MASH-Mushroom-Automation/MASH-IoT-Device/assets/figma/bg_main.png

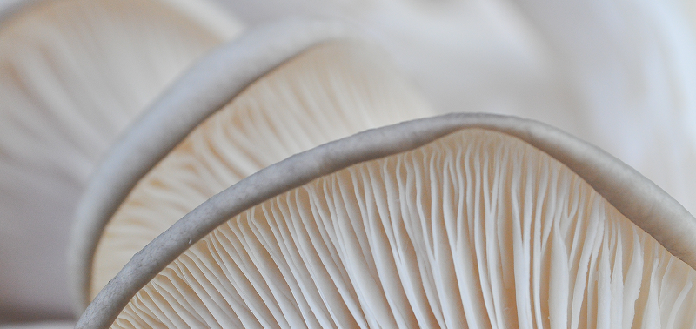
assets/figma/bg_main.png
