MASH-Mushroom-Automation/MASH-IoT-Device/assets/figma/bg_main_gradient.png

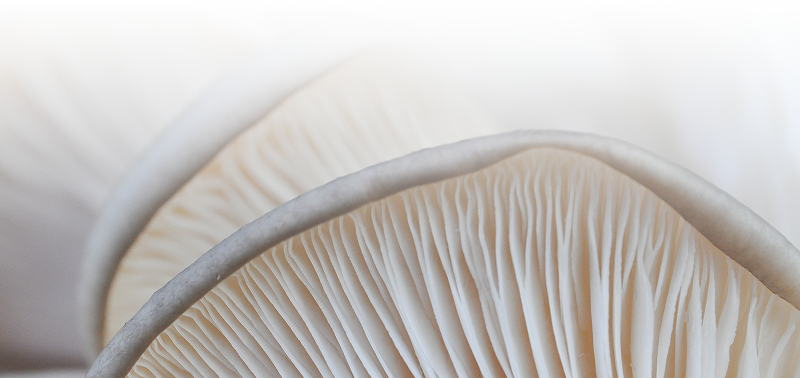
assets/figma/bg_main_gradient.png
