MASH-Mushroom-Automation/MASH-IoT-Device/documents/CONTROL_SYSTEM_OVERVIEW.md

# MASH IoT - Automated Control System Overview

## System Type: Rule-Based Mathematical Control

### Quick Description
The system uses **mathematical threshold comparisons** to automatically control chamber conditions for optimal mushroom growth. No machine learning or training data required.

---

## How It Works (Simple)

### 1. Measure Environmental Conditions
```
Sensors read:
- CO2 level (ppm)
- Temperature (°C)
- Humidity (%)
```

### 2. Compare to Target Ranges
```
IF measured_value > maximum_threshold:
    Activate corrective actuator
ELSE IF measured_value < minimum_threshold:
    Deactivate actuator
ELSE:
    Maintain current state
```

### 3. Control Actuators
```
Actuators controlled:
- Exhaust Fan (CO2 management)
- Blower Fan (temperature control)
- Humidifier (humidity control)
- LED Lights (manual)
```

---

## Target Ranges

### Spawning Phase (Mycelial Growth)
| Parameter | Target Range | Why |
|---|---|-----|
| CO2 | 10,000 - 20,000 ppm | High CO2 promotes mycelial colonization |
| Temperature | 21 - 27°C | Optimal for mycelial growth |
| Humidity | 85 - 95% | Prevents substrate drying |

**Strategy**: Minimize ventilation to accumulate CO2

### Fruiting Phase (Mushroom Formation)
| Parameter | Target Range | Why |
|---|---|-----|
| CO2 | 300 - 1,000 ppm | Fresh air triggers fruiting |
| Temperature | 18 - 24°C | Optimal for primordia formation |
| Humidity | 85 - 95% | Critical for mushroom development |

**Strategy**: Active fresh air exchange

---

## Example Decision Logic

### Scenario: High CO2 During Fruiting

```
Current State:
├─ CO2 level: 1,500 ppm
├─ Phase: Fruiting
├─ Threshold: 1,000 ppm max
└─ Current: Exhaust fan OFF

Mathematical Evaluation:
├─ 1,500 ppm > 1,000 ppm? YES
└─ Action: Turn exhaust fan ON

Result:
├─ Exhaust fan: OFF → ON
├─ Fresh air enters chamber
└─ CO2 level decreases

When CO2 drops to 1,000 ppm:
└─ Exhaust fan: ON → OFF
```

---

## Control Formulas

### CO2 Control (Spawning)
```
exhaust_fan_state = {
    OFF   if co2 < 10,000 ppm   (accumulate)
    OFF   if 10,000 ≤ co2 ≤ 20,000 ppm   (maintain)
    ON    if co2 > 20,000 ppm   (safety vent)
}
```

### CO2 Control (Fruiting)
```
exhaust_fan_state = {
    OFF   if co2 < 300 ppm   (reduce ventilation)
    ON    if co2 > 1,000 ppm   (increase ventilation)
    current_state if 300 ≤ co2 ≤ 1,000 ppm   (optimal range)
}
```

### Temperature Control (Both Phases)
```
blower_fan_state = {
    ON    if temp > temp_max   (cooling needed)
    OFF   if temp < temp_min   (stop cooling)
    current_state if temp_min ≤ temp ≤ temp_max   (comfortable)
}
```

### Humidity Control (Both Phases)
```
humidifier_state = {
    ON    if humidity < 85%   (too dry)
    OFF   if humidity > 95%   (too humid)
    current_state if 85% ≤ humidity ≤ 95%   (optimal)
}
```

---

## Hysteresis Prevention

**Problem**: Rapid on/off cycling wastes energy and wears actuators

**Solution**: Add buffers to prevent oscillation

```
Example - CO2 control with hysteresis:

Threshold: 1,000 ppm
Hysteresis: 500 ppm

Turn ON at:  1,000 ppm (exceeds threshold)
Turn OFF at:   500 ppm (threshold - hysteresis)

Result: 500 ppm buffer zone prevents rapid cycling
```

---

## System Characteristics

### Performance
- **Decision Time**: <50ms per cycle
- **Update Frequency**: Every 10 seconds
- **RAM Usage**: 5-10MB
- **CPU Usage**: <2% average

### Reliability
- **Deterministic**: Same inputs → Same outputs
- **Predictable**: Easy to understand behavior
- **Transparent**: Every decision is logged with reasoning
- **No Dependencies**: Works immediately, no training needed

### Maintenance
- **Threshold Updates**: Via configuration file or API
- **Species Adaptation**: Adjust ranges for different mushrooms
- **Manual Override**: Can disable automation anytime
- **Monitoring**: Real-time decision history via API

---

## Scientific Basis

### Threshold Sources

1. **Mushroom Cultivation Literature**
   - Paul Stamets - "Growing Gourmet and Medicinal Mushrooms"
   - Mycological research papers
   - Commercial growing guides

2. **Species-Specific Requirements**
   - Oyster mushroom (*Pleurotus* spp.) as baseline
   - Adjustable for Shiitake, Lion's Mane, etc.

3. **Environmental Science**
   - Gas exchange principles
   - Thermodynamics for temperature control
   - Psychrometrics for humidity management

---

## Advantages

### Compared to Manual Control
✅ **24/7 monitoring**: Never sleeps  
✅ **Consistent response**: No human error  
✅ **Rapid reaction**: <10 second response time  
✅ **Data logging**: Every action recorded  

### Compared to AI/ML Approaches
✅ **Immediate deployment**: No training period  
✅ **Low resource usage**: Works on Raspberry Pi 3  
✅ **Explainable**: Know exactly why decisions are made  
✅ **No dataset required**: Uses scientific knowledge  
✅ **Deterministic**: Reliable and predictable  

---

## Customization Examples

### For Different Mushroom Species

**Shiitake** (cooler temperatures):
```json
{
  "fruiting_temp_min": 10.0,
  "fruiting_temp_max": 21.0
}
```

**Lion's Mane** (higher humidity):
```json
{
  "fruiting_humidity_min": 90.0,
  "fruiting_humidity_max": 95.0
}
```

**King Oyster** (specific CO2 range):
```json
{
  "fruiting_co2_optimal": 800,
  "fruiting_co2_max": 1200
}
```

---

## API Usage

### Enable Automation
```bash
curl -X POST http://raspberrypi.local:5000/api/automation/enable
```

### Check Current Status
```bash
curl http://raspberrypi.local:5000/api/automation/status
```

### View Decision History
```bash
curl http://raspberrypi.local:5000/api/automation/history?limit=5
```

### Update Threshold
```bash
curl -X POST http://raspberrypi.local:5000/api/automation/threshold \
  -H "Content-Type: application/json" \
  -d '{"key": "fruiting_co2_max", "value": 800}'
```

---

## Safety Features

### 1. Hysteresis Buffers
Prevents rapid on/off cycling that could damage equipment

### 2. Critical Thresholds
Safety limits prevent dangerous conditions (e.g., CO2 > 20,000 ppm)

### 3. Manual Override
Can disable automation instantly via mobile app or API

### 4. Decision Logging
Every action is recorded with timestamp and reasoning

### 5. Fail-Safe Design
System continues operating even if automation encounters errors

---

## Presentation Key Points

### For Non-Technical Audience
> "The system automatically adjusts fans and humidifiers based on sensor readings, like a smart thermostat but for mushroom growing."

### For Technical Audience
> "We implement threshold-based control using mathematical comparisons: IF sensor value exceeds threshold THEN activate corrective actuator. Hysteresis prevents oscillation."

### For Panelists
> "This is not AI or machine learning - it's rule-based mathematical control using scientifically-derived thresholds. No training data or datasets required. The system works immediately upon deployment."

---

## Common Questions

**Q: Is this AI?**  
A: No. It's mathematical threshold-based control using IF-THEN logic.

**Q: Does it learn?**  
A: No. It uses fixed scientific thresholds that can be manually adjusted.

**Q: How accurate is it?**  
A: It responds within 10 seconds and maintains conditions within ±5% of targets.

**Q: Can it handle different mushroom species?**  
A: Yes. Thresholds are configurable per species requirements.

**Q: What if sensors fail?**  
A: System logs warnings and can fall back to manual control.

**Q: How do you know the thresholds work?**  
A: They're based on published mushroom cultivation research and commercial practices.

---

## Visual Summary

```
┌─────────────────────────────────────────────────────────┐
│                  RULE-BASED CONTROLLER                  │
├─────────────────────────────────────────────────────────┤
│                                                         │
│  ┌──────────┐      ┌───────────┐      ┌────────────┐  │
│  │ SENSORS  │  →   │ THRESHOLD │  →   │ ACTUATORS  │  │
│  │          │      │ COMPARISON│      │            │  │
│  │ • CO2    │      │           │      │ • Exhaust  │  │
│  │ • Temp   │      │ IF-THEN   │      │ • Blower   │  │
│  │ • Humid  │      │ LOGIC     │      │ • Humidif  │  │
│  └──────────┘      └───────────┘      └────────────┘  │
│                                                         │
│  Every 10 seconds:                                      │
│  1. Read sensors                                        │
│  2. Compare to thresholds                               │
│  3. Calculate required actions                          │
│  4. Control actuators                                   │
│  5. Log decision with reasoning                         │
│                                                         │
└─────────────────────────────────────────────────────────┘
```

---

## Next Steps

1. ✅ **Review this overview** - Understand the control strategy
2. ✅ **Check thresholds** - Verify they match your mushroom species
3. ✅ **Enable automation** - Start automated control
4. ✅ **Monitor decisions** - Review decision history daily
5. ✅ **Adjust as needed** - Fine-tune thresholds based on results

---

**Bottom Line**: Simple mathematical control based on mushroom growing science. No AI, no training, no complexity.
