MASH-Mushroom-Automation/MASH-IoT-Device/touchscreen_ui/ALIGNMENT_AND_ICONS_SUMMARY.md

# Alignment Fixes & Icon Integration Summary

## ✅ Completed Tasks

### 1. Alignment Fixes
- **Controls Screen**: Fixed actuator grid layout with proper spacing and row heights
- **WiFi Setup Screen**: Improved form layout for OSK compatibility (inputs in top 60%)
- **Controls Screen**: Added section titles and consistent spacing

### 2. Icon Integration System
Created comprehensive icon management system:
- **Icon Helper** (`utils/icon_helper.py`) - Centralized icon loading and management
- **Icon Guide** (`ICON_GUIDE.md`) - Complete documentation
- **Download Checklist** (`ICON_DOWNLOAD_CHECKLIST.md`) - Step-by-step download instructions
- **Usage Examples** (`ICON_USAGE_EXAMPLES.py`) - Code examples

### 3. Icon Assets
Created proper asset structure:
```
touchscreen_ui/assets/icons/
├── Navigation icons (home, sliders, bell, brain, help-circle, settings)
├── Actuator icons (droplet, wind, lightbulb, power)
├── Sensor icons (gauge, thermometer, droplet)
├── Status icons (check-circle, alert-triangle, x-circle, info)
└── System icons (wifi, activity, refresh-cw, chevron-right)
```

## 📋 Required Icons (27 total)

### Priority 1 - Essential (17 icons)
1. home.png - Dashboard navigation
2. sliders.png - Controls navigation
3. bell.png - Alerts navigation
4. brain.png - AI Insights navigation
5. help-circle.png - Help navigation
6. settings.png - Settings navigation
7. droplet.png - Humidifier & Humidity
8. wind.png - Fan controls
9. lightbulb.png - LED lights
10. power.png - Power toggle
11. gauge.png - CO2 sensor
12. thermometer.png - Temperature
13. check-circle.png - Success
14. alert-triangle.png - Warning
15. x-circle.png - Error
16. info.png - Information
17. wifi.png - WiFi connectivity

### Priority 2 - Additional (10 icons)
18. activity.png - System activity
19. refresh-cw.png - Refresh data
20. chevron-right.png - Navigation arrow
21. menu.png - Menu (optional)
22. play.png - Start automation
23. pause.png - Pause automation
24. skip-forward.png - Next
25. skip-back.png - Previous
26. download.png - Export data
27. upload.png - Import settings

## 🎨 Icon Specifications

**Download from**: https://lucide.dev

**Settings**:
- Format: PNG
- Size: 60x60 pixels (standard), 32x32 (small)
- Color: #FFFFFF (white) for dark theme
- Stroke width: 2px
- Background: Transparent

## 💻 Usage in Code

### Basic Usage
```python
from utils.icon_helper import get_icon

# Standard 60x60 icon
icon = get_icon('home')

# Different sizes
small = get_icon('bell', size='small')    # 32x32
medium = get_icon('wifi', size='medium')  # 48x48
large = get_icon('settings', size='large') # 60x60

# Custom size
custom = get_icon('power', size=40)
```

### Integration Examples

#### Navigation Sidebar
```python
# Replace emoji icons with Lucide icons
nav_items = [
    ('home', 'dashboard', 'Home'),
    ('bell', 'alerts', 'Alerts'),
    ('brain', 'ai_insights', 'AI'),
    ('sliders', 'controls', 'Controls'),
    ('help-circle', 'help', 'Help'),
    ('settings', 'settings', 'Settings')
]
```

#### Sensor Cards
```python
# Add sensor type icons
sensor_icons = {
    'co2': 'gauge',
    'temperature': 'thermometer',
    'humidity': 'droplet'
}
```

#### Actuator Controls
```python
# Add actuator icons
actuator_icons = {
    'humidifier': 'droplet',
    'fan_exhaust': 'wind',
    'fan_circulation': 'wind',
    'led_grow': 'lightbulb'
}
```

## 📂 File Structure
```
touchscreen_ui/
├── assets/
│   └── icons/              # Icon PNG files (YOU NEED TO ADD THESE)
│       ├── home.png
│       ├── sliders.png
│       ├── bell.png
│       └── ... (27 icons total)
├── utils/
│   └── icon_helper.py      # ✅ Icon loading utility (CREATED)
├── ICON_GUIDE.md           # ✅ Complete documentation (CREATED)
├── ICON_DOWNLOAD_CHECKLIST.md  # ✅ Download guide (CREATED)
└── ICON_USAGE_EXAMPLES.py  # ✅ Code examples (CREATED)
```

## 🚀 Next Steps

### 1. Download Icons (YOU NEED TO DO THIS)
Follow the checklist in `ICON_DOWNLOAD_CHECKLIST.md`:
1. Go to https://lucide.dev
2. Search for each icon
3. Download as PNG (60x60px, white, stroke 2px)
4. Save to `touchscreen_ui/assets/icons/`

### 2. Integrate Icons into Screens
Once icons are downloaded, update these files:
- `widgets/navigation_sidebar.py` - Replace emoji icons
- `widgets/sensor_card.py` - Add sensor type icons
- `widgets/toggle_button.py` - Add actuator icons
- `widgets/status_bar.py` - Add WiFi and status icons

### 3. Test Demo Mode
```powershell
cd touchscreen_ui
python main.py
```

## 🎯 Alignment Improvements

### Controls Screen
- ✅ Added section title "Actuator Controls"
- ✅ Fixed grid layout with proper row heights
- ✅ Improved spacing between elements
- ✅ Added consistent padding

### WiFi Setup Screen
- ✅ Form positioned in top 60% (OSK compatible)
- ✅ Added input padding for better touch targets
- ✅ Improved button layout and spacing
- ✅ Better status message alignment

### General Improvements
- ✅ Consistent spacing across all screens
- ✅ Proper touch target sizes (minimum 50dp)
- ✅ Better visual hierarchy with titles
- ✅ Improved readability

## ⚠️ Important Notes

1. **Icons are NOT included** - You must download them from lucide.dev
2. **Placeholder system** - Icon helper creates gray squares if icons are missing
3. **Testing** - Test with mock mode: `MOCK_MODE=true` in `.env`
4. **Performance** - Icons are optimized for RPi3 (60x60px)

## 📊 Implementation Status

- ✅ Icon helper system created
- ✅ Documentation complete
- ✅ Alignment fixes applied
- ✅ Mock mode working
- ⏳ Icons need to be downloaded (by you)
- ⏳ Screen integration (after icons are added)

---

**Ready for Testing**: Yes (with placeholder icons)  
**Ready for Production**: After downloading real icons
