MASH-Mushroom-Automation/MASH-IoT-Device/touchscreen_ui/ROADMAP.md

# Development Roadmap

## Phase 1: Foundation ✅ COMPLETED

- [x] Project structure
- [x] Configuration system
- [x] API client
- [x] Main application skeleton
- [x] Deployment guide

**Files Created**:
- `main.py` - Entry point with basic UI
- `config.py` - Configuration constants
- `api_client.py` - Flask API communication
- `requirements.txt` - Python dependencies
- `DEPLOYMENT_GUIDE.md` - Complete RPi3 setup instructions
- `README.md` - Project overview

## Phase 2: Core Screens (Next)

### 2.1 Dashboard Screen
- [ ] Live sensor data cards (CO2, temp, humidity)
- [ ] Real-time line charts
- [ ] Current mode indicator
- [ ] Alert notifications
- [ ] Auto-refresh every 2 seconds

**Estimated Time**: 8 hours

### 2.2 Controls Screen
- [ ] Actuator toggle buttons (4 relays)
- [ ] Visual on/off indicators
- [ ] Mode switcher (spawning/fruiting)
- [ ] Automation enable/disable toggle
- [ ] Confirmation dialogs

**Estimated Time**: 6 hours

### 2.3 WiFi Setup Screen
- [ ] Network scanner
- [ ] Network list with signal strength
- [ ] Password input dialog
- [ ] Connection status indicator
- [ ] Current network display

**Estimated Time**: 8 hours

### 2.4 Settings Screen
- [ ] Device info (ID, name, IP, MAC)
- [ ] System stats (CPU, RAM, temp, uptime)
- [ ] Backend connection status
- [ ] Version info
- [ ] Restart/shutdown buttons

**Estimated Time**: 4 hours

**Phase 2 Total**: 26 hours (~3-4 weeks part-time)

## Phase 3: Polish & Enhancement

- [ ] Custom widgets (sensor card, toggle button)
- [ ] Kivy layout files (.kv)
- [ ] Animations and transitions
- [ ] Error handling and retry logic
- [ ] Loading indicators
- [ ] Virtual keyboard for text input

**Estimated Time**: 12 hours

## Phase 4: Real-time Updates

- [ ] WebSocket client integration
- [ ] Live sensor data streaming
- [ ] Actuator state synchronization
- [ ] Connection status monitoring
- [ ] Automatic reconnection

**Estimated Time**: 8 hours

## Phase 5: Testing & Optimization

- [ ] Hardware testing on RPi3
- [ ] Performance profiling (RAM, CPU, FPS)
- [ ] Touch input calibration
- [ ] Battery/power management
- [ ] Long-term stability testing (24h+)
- [ ] Bug fixes

**Estimated Time**: 10 hours

## Phase 6: Documentation & Training

- [ ] User manual
- [ ] Video tutorial
- [ ] Troubleshooting guide
- [ ] Maintenance procedures

**Estimated Time**: 6 hours

---

## Total Estimated Time

- **Phase 1** (Foundation): ✅ 8 hours - DONE
- **Phase 2** (Core Screens): 26 hours
- **Phase 3** (Polish): 12 hours
- **Phase 4** (Real-time): 8 hours
- **Phase 5** (Testing): 10 hours
- **Phase 6** (Docs): 6 hours

**TOTAL**: ~70 hours (~2-3 months part-time, or 2-3 weeks full-time)

---

## Current Status

**Phase**: 1 (Foundation) ✅  
**Progress**: 8/70 hours (11%)  
**Next Task**: Implement Dashboard Screen

## How to Continue Development

```bash
# 1. Test current skeleton
cd touchscreen_ui
python3 main.py

# 2. Start Phase 2 - Dashboard Screen
# Create: screens/dashboard.py
# Create: kv/dashboard.kv
# Add to main.py screen manager

# 3. Test on development machine first
# Then deploy to RPi3 for hardware testing
```
