MASH-Mushroom-Automation/MASH-IoT-Device/documents/BLUETOOTH_INTEGRATION_SUMMARY.md

# Bluetooth Integration Summary - IoT Device

## Overview
Successfully integrated Bluetooth connectivity into the MASH IoT Device integrated server, enabling Bluetooth tethering for internet sharing and device discovery.

## Files Modified

### 1. `integrated_server.py`
**Changes Made:**
- Added Bluetooth manager and tethering imports
- Initialized Bluetooth components on startup
- Added 3 new API endpoints for Bluetooth control
- Updated health check to include Bluetooth status

## New Components Initialized

### Bluetooth Manager
```python
bluetooth_manager = BluetoothManager()
```
- Handles Bluetooth adapter control
- Manages discoverable mode
- Provides Bluetooth status

### Bluetooth Tethering
```python
bluetooth_tethering = BluetoothTethering()
```
- Manages internet sharing via Bluetooth PAN
- Handles NAT configuration
- Controls tethering lifecycle

## New API Endpoints

### 1. GET `/api/bluetooth/status`
**Description:** Get Bluetooth and tethering status

**Response:**
```json
{
  "success": true,
  "data": {
    "bluetooth": {
      "available": true,
      "powered": true,
      "discoverable": true,
      "pairable": true,
      "adapter": "hci0",
      "address": "XX:XX:XX:XX:XX:XX"
    },
    "tethering": {
      "active": false,
      "interface": "bnep0",
      "connected_devices": []
    }
  }
}
```

### 2. POST `/api/bluetooth/tethering`
**Description:** Start or stop Bluetooth tethering

**Request Body:**
```json
{
  "action": "start"  // or "stop"
}
```

**Response:**
```json
{
  "success": true,
  "data": {
    "action": "start",
    "message": "Bluetooth tethering started",
    "status": {
      "active": true,
      "interface": "bnep0",
      "connected_devices": []
    }
  }
}
```

### 3. POST `/api/bluetooth/discoverable`
**Description:** Set Bluetooth discoverable mode

**Request Body:**
```json
{
  "enabled": true,
  "timeout": 180  // seconds (optional, default: 180)
}
```

**Response:**
```json
{
  "success": true,
  "data": {
    "discoverable": true,
    "timeout": 180,
    "message": "Bluetooth discoverable enabled"
  }
}
```

## Startup Behavior

When the integrated server starts:

1. **Bluetooth Initialization**
   - Checks if Bluetooth is available
   - Logs availability status
   - Handles initialization errors gracefully

2. **Auto-Discoverable Mode**
   - Automatically sets device to discoverable
   - Default timeout: 300 seconds (5 minutes)
   - Allows mobile app to find the device easily

3. **Logging**
   ```
   INFO - Bluetooth is available
   INFO - Bluetooth set to discoverable mode (5 minutes)
   ```

## Updated Health Check

The `/api/health` endpoint now includes Bluetooth status:

```json
{
  "success": true,
  "data": {
    "status": "healthy",
    "serialConnected": true,
    "gpioAvailable": true,
    "automationEnabled": true,
    "bluetoothAvailable": true,  // NEW
    "timestamp": "2024-11-11T15:13:00.000Z"
  }
}
```

## Integration Flow

### Mobile App → IoT Device via Bluetooth

1. **Discovery Phase**
   ```
   Mobile App → Scans for Bluetooth devices
   IoT Device → Broadcasts as discoverable (MASH-IoT-XXXXX)
   Mobile App → Finds device in scan results
   ```

2. **Connection Phase**
   ```
   Mobile App → Connects to device via Bluetooth
   IoT Device → Accepts connection
   Mobile App → Sends HTTP requests over Bluetooth
   ```

3. **Tethering Phase (Optional)**
   ```
   Mobile App → POST /api/bluetooth/tethering {"action": "start"}
   IoT Device → Starts Bluetooth PAN
   IoT Device → Configures NAT for internet sharing
   IoT Device → Gets internet from mobile app
   ```

## Error Handling

All Bluetooth endpoints include comprehensive error handling:

```python
try:
    # Bluetooth operation
    status = bluetooth_manager.get_status()
    return jsonify({'success': True, 'data': status})
except Exception as e:
    logger.error(f"ERROR: Error getting Bluetooth status: {e}")
    return jsonify({'success': False, 'error': str(e)}), 500
```

## Dependencies

### Python Packages
- `subprocess` - For bluetoothctl commands
- `logging` - For error and status logging
- `flask` - For HTTP API endpoints

### System Requirements
- Bluetooth adapter (built-in on Raspberry Pi 3)
- `bluetoothctl` command-line tool
- `bluez` Bluetooth stack
- `iptables` for NAT configuration

## Testing Checklist

- [x] Bluetooth manager initialization
- [x] Bluetooth tethering initialization
- [x] API endpoint: GET /api/bluetooth/status
- [x] API endpoint: POST /api/bluetooth/tethering
- [x] API endpoint: POST /api/bluetooth/discoverable
- [x] Health check includes Bluetooth status
- [x] Auto-discoverable on startup
- [ ] Test on actual Raspberry Pi 3 hardware
- [ ] Test Bluetooth pairing with mobile app
- [ ] Test tethering internet sharing
- [ ] Test API calls over Bluetooth connection

## Usage Examples

### Check Bluetooth Status
```bash
curl http://localhost:5000/api/bluetooth/status
```

### Start Tethering
```bash
curl -X POST http://localhost:5000/api/bluetooth/tethering \
  -H "Content-Type: application/json" \
  -d '{"action": "start"}'
```

### Make Device Discoverable
```bash
curl -X POST http://localhost:5000/api/bluetooth/discoverable \
  -H "Content-Type: application/json" \
  -d '{"enabled": true, "timeout": 300}'
```

### Health Check
```bash
curl http://localhost:5000/api/health
```

## Security Considerations

1. **Pairing Required**: Device requires pairing before connection
2. **Timeout**: Discoverable mode auto-disables after timeout
3. **Local Only**: Bluetooth has limited range (~10 meters)
4. **No Authentication**: API endpoints don't require auth (local network only)

## Future Enhancements

1. Add Bluetooth device pairing management
2. Add connected devices list
3. Add Bluetooth signal strength monitoring
4. Add automatic tethering on mobile connection
5. Add Bluetooth connection history
6. Add device name customization

## Troubleshooting

### Bluetooth Not Available
```
WARNING: Bluetooth not available on this system
```
**Solution:** Ensure Bluetooth hardware is present and `bluez` is installed

### Tethering Fails
```
ERROR: Failed to start tethering
```
**Solution:** Check iptables permissions and network configuration

### Discoverable Mode Fails
```
ERROR: Failed to set discoverable mode
```
**Solution:** Ensure bluetoothctl is installed and Bluetooth is powered on

---

**Updated:** November 11, 2024
**Version:** 1.0.0
**Status:** Integrated and Ready for Testing
