MASH-Mushroom-Automation/MASH-IoT-Device/documents/Budget_Breakdown.md

# M.A.S.H. Project Budget Breakdown

## Hardware Components Budget

| Item | Cost | Shop Link |
|---|---|---|
| Raspberry Pi Zero 2W | ₱1,600.00 | [MakerLab Electronics](https://www.makerlab-electronics.com/products/raspberry-pi-zero-2w-sc1146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) |
| Micro USB Power Switch | ₱70.00 | [Shopee](https://shopee.ph/ITHT-USB-Type-C-With-ON-OFF-Switch-Power-Button-30CM-Charging-Extension-Cable-Universal-Type-C-Extension-Cable-new-i.168902097.43350919209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) |
| CO2L Unit with Temperature and Humidity Sensor | ₱3,090.00 | [MakerLab Electronics](https://www.makerlab-electronics.com/products/m5stack-co2l-unit-with-temperature-and-humidity-sensor-scd41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) |
| I2C 20x4 Arduino LCD Display Module | ₱280.00 | [MakerLab Electronics](https://www.makerlab-electronics.com/products/20x4-lcd-display-i2c-white-blue?_pos=2&_psq=20x4&_ss=e&_v=1.0) |
| Breadboard Jumper Wires | ₱50.00 | [MakerLab Electronics](https://www.makerlab-electronics.com/products/40-pin-10cm-jumper-wires?_pos=1&_psq=jum&_ss=e&_v=1.) |
| Mini Fan (exhaust) | ₱75.00 | [MakerLab Electronics](https://www.makerlab-electronics.com/products/raspberry-pi-fan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) |
| Humidifier | ₱135.00 | [Shopee](https://shopee.ph/DC5V-Unswitched-Four-Spray-Humidifier-Module-Atomization-Control-Board-i.1118156654.41163184713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) |
| HEPA Filter | ₱400.00 | [Shopee](https://shopee.ph/Sharp-FZ-F30HFE-Air-Purifier-Composite-Filter-For-FP-F30-FP-GM30E-KC-F30E-FP-J30E-FP-JM30-FP-GM30B-B-i.1242063782.41350010111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) |
| Blower Fan (12 inch) (Air intake) | ₱1,000.00 | [Shopee](https://shopee.ph/Exhaust-fan-Low-Noise-Kitchen-Exhaust-Fan-Wall-Mounted-Home-Exhaust-Fan-Multi-size-Ventilation-Fan-i.629450377.26465497321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) |
| Air Filtered Fan (4 inch) | ₱2,300.00 | [Shopee](https://shopee.ph/%E3%80%90Remote-Control%E3%80%91-Xiaomi-DIY-Air-Purifier-Set-Exhaust-Fan-Extractor-Fan-with-for-Version2-2S-2H-2C-3H-i.955280135.29637047541) |
| Grow Tent (24 x 24 x 36 inch) | ₱4,789.00 | [Shopee](https://shopee.ph/%E3%80%90Litgrow%E3%80%91Garden-80-x-80-x-160-CM(32-x32-x64-)-Hydroponic-Indoor-Bud-Green-Room-600D-Grow-Tent-i.980116806.16894088199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) |
| Fan Speed Control Board | ₱200.00 | [OSHPark](https://oshpark.com/shared_projects/oJIFTsvc) |
| Panel Mount Audio Jack | ₱90.00 | [Shopee](https://shopee.ph/1-3-5PCS-3.5MM-Audio-Jack-Socket-Stereo-3-Pole-Solder-Panel-Mount-With-Nut-Connector-Headphone-Female-Socket-PJ-392A-PJ392A-i.1263679380.2816672311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) |
| Power strip smart socket | ₱1,799.00 | [Shopee](https://shopee.ph/LASCO-Wifi-Universal-Smart-Power-Strip-with-Energy-Monitoring-Smart-Socket-with-Surge-Pro-i.151900297.23955304247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) |
| F5305S Power Mosfet Module | ₱150.00 | [MakerLab Electronics](https://www.makerlab-electronics.com/products/f5305s-power-mosfet-module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) |

## Total Hardware Cost: ₱16,028.00

## Budget Analysis

### Project Budget Allocation
- **Total Team Budget**: ₱20,000.00
- **Hardware Costs**: ₱16,028.00 (80.14% of budget)
- **Remaining Budget**: ₱3,972.00 (19.86% of budget)

### Remaining Budget Allocation
The remaining ₱3,972.00 will cover:
- Software development tools and subscriptions
- Testing and prototyping materials
- Documentation and printing costs
- Contingency funds for unexpected expenses
- Transportation for field visits and interviews

### Cost Justification
- **Component Selection**: All components chosen are off-the-shelf, readily available, and cost-effective for a prototype system
- **Scalability**: Components can be sourced in bulk for production scaling
- **Quality**: Industrial-grade components ensure reliability for agricultural use
- **Local Availability**: Most components available through Philippine suppliers (Shopee, local electronics shops)

### Return on Investment (ROI) Projection
Based on stakeholder interviews and market research:
- **Target Yield Increase**: 20% improvement in mushroom production
- **Cost Recovery Period**: 6-8 months for small-scale growers
- **Annual ROI**: 150-200% based on increased yields and direct-to-consumer sales
- **Break-even Analysis**: System pays for itself within one growing cycle

### Funding Sources
- **Primary**: Team budget allocation (₱20,000)
- **Secondary**: Potential sponsorships from Department of Agriculture or technology partners
- **Future**: Government grants for agricultural innovation (DA, DTI programs)

## Procurement Timeline
- **Week 1-2**: Core controller (Raspberry Pi) and basic sensors
- **Week 3-4**: Environmental control components (fans, humidifier, filters)
- **Week 5-6**: Structural components (grow tent, mounting hardware)
- **Week 7-8**: Power management and connectivity components

## Risk Mitigation
- **Price Fluctuations**: Budget includes 10% contingency for component price changes
- **Availability**: Multiple suppliers identified for critical components
- **Import Delays**: Local alternatives identified for imported components
- **Currency Exchange**: Budget fixed in Philippine Pesos to avoid exchange rate risks
