MASH-Mushroom-Automation/MASH-IoT-Device/documents/README.md

# MASH Project Documentation

This folder contains official documentation for the M.A.S.H. (Mushroom Automation with Smart Hydro-environment using IoT and AI for Sustainable Harvest) project.

## Documents Overview

- **[MASH_Project_Proposal.md](MASH_Project_Proposal.md)** - Complete project proposal including rationale, objectives, scope, and methodology
- **[Feasibility_Study.md](Feasibility_Study.md)** - Detailed feasibility analysis across operational, technical, and economic domains
- **[Budget_Breakdown.md](Budget_Breakdown.md)** - Complete hardware and component cost breakdown
- **[Technical_Specifications.md](Technical_Specifications.md)** - Hardware components, software stack, and system architecture details
- **[Tech_Stack.md](Tech_Stack.md)** - Detailed technology stack including frameworks, databases, and tools
- **[Stakeholder_Interviews.md](Stakeholder_Interviews.md)** - Interview summaries with growers, producers, and industry experts
- **[References.md](References.md)** - Complete bibliography and research sources

## Project Overview

M.A.S.H. is an IoT and AI-driven system for automated oyster mushroom cultivation, featuring:
- Smart environmental monitoring and control
- AI-powered optimization algorithms
- Mobile applications for growers and consumers
- Integrated e-commerce platform
- Real-time data synchronization

## Contact Information

**Project Team:**
- Kevin A. Llanes (Project Manager)
- Irheil Mae S. Antang (Software Engineer)
- Ma. Catherine H. Bae (Front-end Developer)
- Jin Harold A. Failana (Hardware Programmer)
- Jhon Keneth Ryan B. Namias (Back-end Developer)
- Emmanuel L. Pabua (Database Administrator)
- Ronan Renz T. Valencia (Full Stack Developer)

**Thesis Adviser:** Prof. Joemen G. Barrios, MIT

**Date:** September 29, 2025
