MASH-Mushroom-Automation/MASH-IoT-Device/documents/MIGRATION_TO_RULE_BASED.md

# Migration from AI to Rule-Based Controller

## Summary

Based on panelist feedback, the system has been updated to remove AI terminology and clearly show that it uses **mathematical threshold-based control**, not machine learning or AI.

## What Changed

### 1. New Rule-Based Controller
- **File**: `rule_based_controller.py`
- Replaces: `ai_automation.py`
- **Key Improvement**: Clear documentation that this uses mathematical equations, not AI

### 2. Updated Integration
- **File**: `integrated_server.py`
- Changed all references from `AIAutomationEngine` to `RuleBasedController`
- Updated variable names: `ai_engine` → `automation_controller`
- Updated log messages to remove "AI" terminology

### 3. New Documentation
- **File**: `RULE_BASED_AUTOMATION_GUIDE.md`
- Comprehensive guide explaining the mathematical approach
- Threshold tables and formulas clearly documented
- Examples showing exact decision logic
- Replaces: `AI_AUTOMATION_GUIDE.md` (which can be archived)

## What DIDN'T Change

### System Still Works the Same Way
The control logic is **identical** - it was always using mathematical thresholds, not AI:

```python
# This was ALWAYS the logic (just renamed now)
IF co2 > threshold_max THEN
    activate_exhaust_fan
ELSE IF co2 < threshold_min THEN
    deactivate_exhaust_fan
```

### No Breaking Changes
- **Backward compatible**: Old `AIAutomationEngine` still works (aliased)
- **Same API endpoints**: `/api/automation/*` endpoints unchanged
- **Same functionality**: All features work exactly as before
- **No dataset required**: Never needed datasets (that was the point!)

## Key Clarifications

### What This System Actually Does

**Rule-Based Mathematical Control**:
1. Read sensor values (CO2, temperature, humidity)
2. Compare values to scientific thresholds
3. Apply simple IF-THEN logic
4. Control actuators based on comparison results

**NOT AI/Machine Learning**:
- ❌ No neural networks
- ❌ No training datasets required
- ❌ No model training process
- ❌ No machine learning algorithms

### Why It Was Called "AI" Before

The original `ai_automation.py` had this confusing structure:
- Included a "training" function that just loaded JSON thresholds
- Used terminology like "model" for what was just configuration
- This made panelists think it needed dataset collection time

## Benefits of the Clarification

### For Presentation
✅ **Clearer explanation**: "Mathematical threshold-based control"  
✅ **No dataset concerns**: Works immediately with scientifically-derived values  
✅ **Transparent logic**: Every decision is explainable  
✅ **Simpler terminology**: Rule-based controller, not AI engine  

### For Implementation
✅ **Same lightweight performance**: 5-10MB RAM  
✅ **Same deterministic behavior**: Predictable outcomes  
✅ **Same ease of customization**: Adjust thresholds via config  
✅ **Backward compatible**: No code changes needed elsewhere  

## Control Logic Documentation

### Spawning Phase
```
CO2 Management:
  IF co2 < 10,000 ppm:
    exhaust_fan = OFF (accumulate CO2)
  ELSE IF co2 > 20,000 ppm:
    exhaust_fan = ON (safety ventilation)
  
Temperature Control:
  IF temperature > 27°C:
    blower_fan = ON (cooling)
  ELSE IF temperature < 21°C:
    blower_fan = OFF (stop cooling)
  
Humidity Control:
  IF humidity < 85%:
    humidifier = ON
  ELSE IF humidity > 95%:
    humidifier = OFF
```

### Fruiting Phase
```
CO2 Management:
  IF co2 > 1,000 ppm:
    exhaust_fan = ON (fresh air exchange)
  ELSE IF co2 < 300 ppm:
    exhaust_fan = OFF (reduce ventilation)
  
Temperature Control:
  IF temperature > 24°C:
    blower_fan = ON (cooling)
  ELSE IF temperature < 18°C:
    blower_fan = OFF (stop cooling)
  
Humidity Control:
  IF humidity < 85%:
    humidifier = ON
  ELSE IF humidity > 95%:
    humidifier = OFF
```

## Threshold Sources

All thresholds are derived from **mushroom cultivation science**:

1. **Literature Review**:
   - Paul Stamets - "Growing Gourmet and Medicinal Mushrooms"
   - Research papers on Oyster mushroom cultivation
   - Commercial mushroom growing guidelines

2. **Known Best Practices**:
   - Spawning requires high CO2 (10,000-20,000 ppm) for mycelial growth
   - Fruiting requires fresh air exchange (300-1,000 ppm CO2)
   - Humidity must remain high (85-95%) throughout
   - Temperature ranges vary by growth phase

3. **Safety Margins**:
   - Hysteresis buffers prevent oscillation
   - Critical thresholds protect against extremes
   - Conservative ranges ensure mushroom health

## Migration Steps (If Needed)

### If You Have Custom Code

**Old import**:
```python
from ai_automation import AIAutomationEngine
controller = AIAutomationEngine()
```

**New recommended import**:
```python
from rule_based_controller import RuleBasedController
controller = RuleBasedController()
```

**Backward compatible** (old code still works):
```python
from rule_based_controller import AIAutomationEngine  # Alias provided
controller = AIAutomationEngine()  # Still works!
```

### Configuration Files

**Old**: `models/decision_model.json`  
**New**: `config/thresholds.json` (optional)

Same format works for both:
```json
{
  "version": "1.0",
  "thresholds": {
    "spawning_co2_min": 10000,
    "fruiting_co2_max": 1000
  }
}
```

## Presentation Talking Points

When presenting to panelists:

### Before (Confusing):
> "We use an AI automation engine with a trained decision model that learns from historical data..."

**Panelist concern**: "How long did you collect training data? How much storage for datasets?"

### After (Clear):
> "We use rule-based mathematical control with scientifically-derived thresholds. For example, if CO2 exceeds 1000 ppm during fruiting phase, the exhaust fan activates for fresh air exchange."

**Panelist response**: "That makes sense and is immediately deployable."

## Files Reference

### New/Updated Files
- ✅ `rule_based_controller.py` - Main controller (new)
- ✅ `RULE_BASED_AUTOMATION_GUIDE.md` - Documentation (new)
- ✅ `MIGRATION_TO_RULE_BASED.md` - This file (new)
- ✅ `integrated_server.py` - Updated integration

### Old Files (Can Be Kept for Reference)
- 📁 `ai_automation.py` - Original (now superseded)
- 📁 `AI_AUTOMATION_GUIDE.md` - Original documentation
- 📁 `raspberry-pi/train_decision_model.py` - Not needed

### Files to Remove (Optional Cleanup)
- ❌ `raspberry-pi/train_decision_model.py` - Training script not needed
- ❌ `data/training_data.csv` - No training data needed
- ❌ `models/` directory - Can use `config/` instead

## Testing Checklist

After migration, verify:

- [ ] System starts successfully
- [ ] Automation can be enabled/disabled via API
- [ ] Sensor readings are processed
- [ ] Actuator control works
- [ ] Decision history is logged
- [ ] API endpoints respond correctly
- [ ] No errors in logs

## Questions & Answers

**Q: Do I need to retrain anything?**  
A: No. There is no training. The system uses fixed mathematical thresholds.

**Q: Will performance change?**  
A: No. It's the exact same logic, just renamed for clarity.

**Q: Can I still customize thresholds?**  
A: Yes. Edit `config/thresholds.json` or use the API.

**Q: Is the old code still there?**  
A: Yes. `ai_automation.py` is kept for reference and backward compatibility.

**Q: Do mobile apps need updates?**  
A: No. API endpoints are unchanged.

**Q: What about the "AI" toggle in the mobile app?**  
A: It can be renamed to "Auto-Control" or "Automation" in the UI, but the API works the same.

---

## Conclusion

This migration **clarifies the terminology** without changing functionality. The system was always using mathematical threshold-based control - now it's just more honest about it!

**For panelists**: No lengthy data collection required. The system uses proven scientific thresholds and is ready to deploy immediately.

**For you**: Same great control system, clearer documentation, easier to explain.
