MASH-Mushroom-Automation/MASH-IoT-Device/documents/Backend_Development_Plan.md

# M.A.S.H. Backend Development Plan
## 20-Day Sprint: Enterprise-Grade NestJS Backend with Clerk Authentication

### Project Information
- **Sprint Duration**: October 1 - October 20, 2025 (20 working days)
- **Lead Developer**: Jhon Keneth Ryan B. Namias (Backend Developer)
- **Project Manager**: Kevin A. Llanes
- **GitHub Organization**: https://github.com/orgs/MASH-Mushroom-Automation
- **GitHub Project Board**: https://github.com/orgs/MASH-Mushroom-Automation/projects/1
- **Repository**: MASH-Backend-API
- **Focus**: Production-ready backend API with enterprise-grade standards

---

## 1. Executive Summary and Project Standards

### 1.1 Software Development Standards

#### Development Methodology
- **Agile Development**: Daily sprints with continuous integration
- **Test-Driven Development**: Write tests before implementation
- **Code Review Process**: Mandatory peer reviews for all pull requests
- **Documentation-First**: API documentation before implementation
- **Security-First**: Security considerations in every feature

#### Code Quality Standards
- **TypeScript Strict Mode**: Enforced type safety throughout
- **ESLint and Prettier**: Automated code formatting and linting
- **SonarQube**: Code quality analysis and technical debt management
- **Unit Test Coverage**: Minimum 85% coverage requirement
- **Integration Test Coverage**: 70% of critical user journeys

#### Architecture Principles
- **Clean Architecture**: Domain-driven design with clear separation of concerns
- **SOLID Principles**: Single responsibility, open/closed, dependency inversion
- **Microservices-Ready**: Modular design for future scaling
- **API-First Design**: RESTful APIs with OpenAPI 3.0 specification
- **Real-time Capabilities**: WebSocket integration for live updates

### 1.2 Primary Objectives

#### Core Deliverables
- **Authentication System**: Complete Clerk integration with session management
- **Database Layer**: PostgreSQL with Prisma ORM and optimized queries
- **IoT Integration**: MQTT broker for real-time device communication
- **E-commerce Engine**: Complete order management and payment processing
- **Real-time Features**: WebSocket implementation for live data streaming
- **API Documentation**: Comprehensive Swagger/OpenAPI documentation
- **Production Deployment**: Docker containerization with CI/CD pipeline

#### Success Metrics
- **Performance**: API response times under 150ms for 95% of requests
- **Reliability**: 99.9% uptime with proper error handling
- **Security**: Zero critical vulnerabilities, proper authentication flows
- **Scalability**: Support for 1000+ concurrent connections
- **Maintainability**: Clean code with comprehensive documentation

### 1.3 Technology Stack and Architecture

#### Backend Framework
- **NestJS v10.x** (TypeScript)
  - Modular, scalable Node.js framework for enterprise applications
  - Integrated with Prisma ORM for type-safe database operations
  - Built-in support for guards, interceptors, and pipes
  - Comprehensive testing utilities and decorators

#### Authentication and Authorization
- **Clerk Authentication** (Production-Ready)
  - Handles complete authentication and session management
  - Pre-built UI components and secure JWT token handling
  - Multi-factor authentication and social login support
  - Role-based access control (RBAC) integration

#### Database and ORM
- **PostgreSQL 15+** with **Prisma ORM 5.x**
  - Type-safe database queries with auto-generated client
  - Database migrations and schema management
  - Connection pooling and performance optimization
  - Support for complex relationships and transactions

#### Real-time and IoT Communication
- **MQTT Protocol** for IoT device communication
- **WebSocket** implementation for real-time web updates
- **Redis** for session storage and caching
- **Socket.io** for enhanced WebSocket functionality

#### Data Flow Architecture
```
IoT Sensors → Raspberry Pi Controller → MQTT Broker → NestJS Backend API
                                                            ↓
PostgreSQL Database ← Redis Cache ← WebSocket Gateway ← Mobile Apps
                                                            ↓
                                                    Web Dashboard
                                                            ↓
                        Clerk Authentication ← External APIs
                                                            ↓
                      Payment Gateways ← File Storage/CDN
                                                            ↓
                                          Email/SMS Services
```

---

## 2. Detailed 20-Day Development Phases

### Phase 1: Foundation & Architecture (Days 1-5)
**October 1-5, 2025 | Foundation Week**

#### Development Standards for Phase 1
- **Architecture Documentation**: Complete system design before coding
- **Code Structure**: Clean folder organization following NestJS best practices
- **Environment Setup**: Reproducible development environment with Docker
- **CI/CD Pipeline**: Automated testing and deployment from day one
- **Security Foundation**: Security configurations from project inception

#### Day 1 (Oct 1): Project Architecture & Initial Setup
**Daily Goal**: Complete project foundation and architecture documentation

**Morning Session (4 hours)**:
- [ ] **Project Architecture Design**
  - Create detailed system architecture diagram
  - Define module structure and dependencies
  - Document data flow and integration points
  - Plan API endpoint structure and naming conventions

**Afternoon Session (4 hours)**:
- [ ] **NestJS Project Initialization**
  - Create NestJS project with strict TypeScript configuration
  - Set up modular folder structure (modules, controllers, services, DTOs)
  - Configure ESLint, Prettier, and Husky git hooks
  - Initialize package.json with all required dependencies

**GitHub Issues & Project Board Setup**:
- `#001`: Create system architecture documentation
- `#002`: Initialize NestJS project with TypeScript strict mode
- `#003`: Configure code quality tools (ESLint, Prettier, Husky)
- `#004`: Set up GitHub repository and branch protection rules

#### Day 2 (Oct 2): Database Architecture & Prisma ORM Setup
**Daily Goal**: Complete database foundation with optimized schema design

**Morning Session (4 hours)**:
- [ ] **Database Design & Optimization**
  - Design comprehensive database schema with proper relationships
  - Create Entity-Relationship Diagrams (ERD)
  - Plan indexing strategy for performance optimization
  - Design data retention and archiving policies

**Afternoon Session (4 hours)**:
- [ ] **Prisma ORM Implementation**
  - Set up PostgreSQL database (local development + cloud staging)
  - Initialize Prisma with complete schema definition
  - Create optimized database migrations with proper constraints
  - Implement database seeding with realistic test data
  - Set up database connection pooling and performance monitoring

**Quality Assurance**:
- Database migration testing (up/down migrations)
- Query performance testing with EXPLAIN ANALYZE
- Data integrity constraints validation
- Backup and recovery procedure testing

**GitHub Issues**:
- `#005`: Design complete database schema with ERD documentation
- `#006`: Set up PostgreSQL with connection pooling and monitoring
- `#007`: Implement Prisma ORM with optimized schema and migrations
- `#008`: Create comprehensive database seeding and test data

#### Day 3 (Oct 3): Clerk Authentication & Security Implementation
**Daily Goal**: Complete enterprise-grade authentication system with Clerk integration

**Morning Session (4 hours)**:
- [ ] **Clerk SDK Integration & Configuration**
  - Install and configure Clerk SDK for NestJS
  - Set up Clerk webhook handlers for user management
  - Configure environment variables and security keys
  - Implement Clerk middleware for request authentication

**Afternoon Session (4 hours)**:
- [ ] **Authentication Guards & Authorization**
  - Create custom authentication guards using Clerk tokens
  - Implement role-based access control (RBAC) system
  - Create custom decorators for permissions and roles
  - Set up JWT token validation and refresh mechanisms
  - Implement session management with proper security headers

**Security Implementation**:
- CORS configuration for production security
- Rate limiting and request throttling
- Input validation and sanitization
- Security headers (HELMET, CSP, HSTS)

**Testing Requirements**:
- Unit tests for authentication guards and decorators
- Integration tests for Clerk webhook handling
- Security testing for authentication flows
- Performance testing for token validation

**GitHub Issues**:
- `#009`: Integrate Clerk SDK with complete configuration
- `#010`: Implement authentication middleware and guards
- `#011`: Create RBAC system with custom decorators
- `#012`: Set up JWT validation and session management

#### Day 4 (Oct 4): Core API Foundation & Enterprise Patterns
**Daily Goal**: Implement robust API foundation with enterprise-grade patterns

**Morning Session (4 hours)**:
- [ ] **Core Module Architecture**
  - Create base modules following clean architecture principles
  - Implement health check module with comprehensive monitoring
  - Set up user management module with Clerk integration
  - Create common utilities and shared modules

**Afternoon Session (4 hours)**:
- [ ] **Enterprise-Grade Error Handling & Validation**
  - Implement global exception filters with proper error logging
  - Create custom exception classes for business logic errors
  - Set up request/response interceptors for logging and transformation
  - Configure validation pipes with custom validation decorators
  - Implement API versioning and backward compatibility

**Code Quality Standards**:
- Abstract base classes for consistent service and controller patterns
- Custom decorators for common functionality
- Comprehensive logging with structured format
- Performance monitoring and metrics collection

**GitHub Issues**:
- `#013`: Create core module architecture with clean patterns
- `#014`: Implement comprehensive error handling and logging
- `#015`: Set up validation pipes and custom decorators
- `#016`: Create base classes and shared utilities

#### Day 5 (Oct 5): User Management & Profile System
**Daily Goal**: Complete comprehensive user management with advanced features

**Morning Session (4 hours)**:
- [ ] **Advanced User Management**
  - Implement complete user CRUD operations with Clerk synchronization
  - Create user profile management with image upload capabilities
  - Set up user preferences and settings system
  - Implement user search and filtering with pagination

**Afternoon Session (4 hours)**:
- [ ] **RBAC & Activity Tracking**
  - Implement advanced role-based access control with hierarchical roles
  - Create permission system with granular access controls
  - Set up comprehensive user activity logging and audit trails
  - Implement user session management and concurrent login handling
  - Create user analytics and behavior tracking

**Advanced Features**:
- User onboarding workflow automation
- Profile verification system
- User notification preferences
- Advanced search with Elasticsearch integration (if needed)

**Testing & Documentation**:
- Complete unit test coverage for user management
- Integration tests for Clerk synchronization
- API documentation with examples
- Performance testing for user operations

**GitHub Issues**:
- `#017`: Implement advanced user CRUD with Clerk synchronization
- `#018`: Create comprehensive RBAC with hierarchical permissions  
- `#019`: Set up user activity logging and audit trails
- `#020`: Implement user preferences and profile management

### Phase 2: IoT Core & Device Management (Days 6-10)
**October 6-10, 2025 | IoT Integration Week**

#### Development Standards for Phase 2
- **IoT Security**: Device authentication and secure communication protocols
- **Real-time Processing**: Efficient handling of high-frequency sensor data
- **Scalability**: Support for multiple devices with concurrent connections
- **Data Integrity**: Reliable data collection with validation and error recovery
- **Performance**: Optimized MQTT message processing and database operations

#### Day 6 (Oct 6): Enterprise IoT Device Management System
**Daily Goal**: Complete IoT device lifecycle management with security and monitoring

**Morning Session (4 hours)**:
- [ ] **Advanced Device Registration & Authentication**
  - Implement secure device registration with certificate-based authentication
  - Create device provisioning workflow with QR code generation
  - Set up device ownership transfer and sharing mechanisms
  - Implement device grouping and organizational hierarchy

**Afternoon Session (4 hours)**:
- [ ] **Device Monitoring & Configuration Management**
  - Create real-time device status tracking with heartbeat monitoring
  - Implement remote device configuration management
  - Set up device firmware update management
  - Create comprehensive device activity logging and analytics
  - Implement device health monitoring with predictive maintenance alerts

**Enterprise Features**:
- Device fleet management for multiple users
- Geolocation tracking and mapping integration
- Device performance analytics and reporting
- Automated device onboarding and provisioning

**Security & Performance**:
- Device certificate management and rotation
- Encrypted device communication protocols
- Rate limiting for device API calls
- Database optimization for device data queries

**GitHub Issues**:
- `#021`: Implement secure device registration and authentication
- `#022`: Create device status monitoring and health tracking
- `#023`: Set up device configuration and firmware management
- `#024`: Implement device fleet management and analytics

#### Day 7 (Oct 7): MQTT Integration
**Goals**: Set up IoT communication layer
- [ ] Configure MQTT broker connection
- [ ] Implement MQTT message handling
- [ ] Create device command dispatch system
- [ ] Set up topic management and routing
- [ ] Add MQTT connection monitoring

**GitHub Issues**:
- `#19`: Configure MQTT broker and connection
- `#20`: Implement MQTT message handling and routing
- `#21`: Create device command dispatch system

#### Day 8 (Oct 8): Sensor Data Management
**Goals**: Handle sensor data collection and storage
- [ ] Create sensor data ingestion endpoints
- [ ] Implement real-time data streaming
- [ ] Set up data aggregation and analytics
- [ ] Create data retention policies
- [ ] Add data validation and filtering

**GitHub Issues**:
- `#22`: Implement sensor data ingestion system
- `#23`: Create real-time data streaming with WebSocket
- `#24`: Add data aggregation and analytics

#### Day 9 (Oct 9): Alert and Notification System
**Goals**: Implement alerting and notification features
- [ ] Create alert configuration system
- [ ] Implement threshold-based alerts
- [ ] Set up notification delivery (email, push)
- [ ] Create alert history and management
- [ ] Add alert acknowledgment system

**GitHub Issues**:
- `#25`: Implement alert configuration and threshold system
- `#26`: Create notification delivery system
- `#27`: Add alert history and management

#### Day 10 (Oct 10): E-commerce Foundation
**Goals**: Basic e-commerce functionality
- [ ] Create product management system
- [ ] Implement inventory tracking
- [ ] Set up order management
- [ ] Create seller management system
- [ ] Add basic payment processing structure

**GitHub Issues**:
- `#28`: Implement product and inventory management
- `#29`: Create order management system
- `#30`: Set up seller management and verification

### Week 3: Advanced Features & Integration (Days 11-15)
**October 11-15, 2025**

#### Day 11 (Oct 11): WebSocket Real-time Features
**Goals**: Implement real-time communication
- [ ] Set up WebSocket gateway
- [ ] Create real-time sensor data streaming
- [ ] Implement live device status updates
- [ ] Add real-time notifications
- [ ] Create WebSocket authentication

**GitHub Issues**:
- `#31`: Implement WebSocket gateway and authentication
- `#32`: Create real-time data streaming
- `#33`: Add live notifications and updates

#### Day 12 (Oct 12): Admin Dashboard APIs
**Goals**: Administrative functionality
- [ ] Create admin user management APIs
- [ ] Implement system monitoring endpoints
- [ ] Set up platform analytics
- [ ] Create content management system APIs
- [ ] Add system configuration management

**GitHub Issues**:
- `#34`: Implement admin user management APIs
- `#35`: Create system monitoring and analytics
- `#36`: Add CMS and configuration management

#### Day 13 (Oct 13): Payment Integration
**Goals**: Payment processing system
- [ ] Integrate payment gateways (Stripe, PayPal)
- [ ] Create payment processing workflows
- [ ] Implement transaction management
- [ ] Set up webhook handling
- [ ] Add payment security measures

**GitHub Issues**:
- `#37`: Integrate payment gateways
- `#38`: Implement payment processing workflows
- `#39`: Add transaction management and security

#### Day 14 (Oct 14): File Upload & Media Management
**Goals**: File handling system
- [ ] Set up file upload endpoints
- [ ] Implement image processing and optimization
- [ ] Create media storage management
- [ ] Add file security and validation
- [ ] Set up CDN integration

**GitHub Issues**:
- `#40`: Implement file upload and processing
- `#41`: Create media storage and CDN integration
- `#42`: Add file security and validation

#### Day 15 (Oct 15): API Documentation & Testing
**Goals**: Documentation and testing
- [ ] Generate Swagger/OpenAPI documentation
- [ ] Create API testing suite
- [ ] Implement integration tests
- [ ] Add performance testing
- [ ] Create API usage examples

**GitHub Issues**:
- `#43`: Generate comprehensive API documentation
- `#44`: Implement testing suite and integration tests
- `#45`: Add performance testing and optimization

### Week 4: Testing, Optimization & Deployment (Days 16-20)
**October 16-20, 2025**

#### Day 16 (Oct 16): Security & Validation
**Goals**: Security hardening
- [ ] Implement input validation and sanitization
- [ ] Add rate limiting and throttling
- [ ] Set up security headers and CORS
- [ ] Implement audit logging
- [ ] Conduct security testing

**GitHub Issues**:
- `#46`: Implement comprehensive input validation
- `#47`: Add rate limiting and security measures
- `#48`: Create audit logging system

#### Day 17 (Oct 17): Performance Optimization
**Goals**: Performance tuning
- [ ] Database query optimization
- [ ] Implement caching strategies (Redis)
- [ ] Add response compression
- [ ] Optimize MQTT performance
- [ ] Conduct load testing

**GitHub Issues**:
- `#49`: Optimize database queries and performance
- `#50`: Implement caching with Redis
- `#51`: Conduct load testing and optimization

#### Day 18 (Oct 18): Error Handling & Monitoring
**Goals**: Production readiness
- [ ] Implement comprehensive error handling
- [ ] Set up application monitoring
- [ ] Add health check endpoints
- [ ] Create logging and debugging tools
- [ ] Implement graceful shutdown

**GitHub Issues**:
- `#52`: Implement error handling and monitoring
- `#53`: Add health checks and logging
- `#54`: Create debugging and monitoring tools

#### Day 19 (Oct 19): Deployment Setup
**Goals**: Production deployment
- [ ] Create Docker containerization
- [ ] Set up production environment configuration
- [ ] Configure CI/CD deployment pipeline
- [ ] Set up database migrations for production
- [ ] Create deployment documentation

**GitHub Issues**:
- `#55`: Create Docker containerization
- `#56`: Set up production deployment pipeline
- `#57`: Configure production environment

#### Day 20 (Oct 20): Final Testing & Launch
**Goals**: Launch preparation
- [ ] Conduct final integration testing
- [ ] Perform security audit
- [ ] Complete documentation review
- [ ] Deploy to production environment
- [ ] Create handover documentation

**GitHub Issues**:
- `#58`: Final integration testing and security audit
- `#59`: Deploy to production environment
- `#60`: Complete documentation and handover

---

## 3. Comprehensive GitHub Project Management Structure

### 3.1 GitHub Project Board Configuration

#### Project Board URL
**Main Project Board**: https://github.com/orgs/MASH-Mushroom-Automation/projects/1

#### Board Structure and Workflow

##### Backlog (Product Backlog)
- **Purpose**: All issues planned but not yet started
- **Criteria**: Requirements defined, acceptance criteria documented
- **Management**: Weekly backlog grooming sessions
- **Contents**:
  - Feature specifications with detailed requirements
  - Future enhancements and improvements
  - Research tasks and spike investigations
  - Non-urgent bug fixes and technical debt

##### In Progress (Sprint Active)
- **Purpose**: Currently active development work
- **Limit**: Maximum 4 issues per developer to maintain focus
- **Management**: Daily standup review items
- **Criteria**: Developer assigned, work started, regular updates
- **Contents**:
  - Feature development in progress
  - Active bug fixes
  - Code reviews in progress
  - Documentation updates being written

##### In Review (Quality Gate)
- **Purpose**: Completed work awaiting quality assurance
- **Criteria**: Code complete, tests passing, ready for review
- **Management**: Peer reviews within 24 hours
- **Contents**:
  - Pull requests awaiting code review
  - Documentation pending technical review
  - Features ready for QA testing
  - Security reviews in progress

##### Done (Completed Sprint Items)
- **Purpose**: Completed and approved work items
- **Criteria**: Code merged, tests passing, documentation complete
- **Management**: Sprint retrospective analysis
- **Contents**:
  - Successfully merged features
  - Completed and deployed enhancements
  - Resolved and closed issues
  - Approved documentation updates

##### Blocked (Impediments)
- **Purpose**: Work items with external dependencies or blockers
- **Management**: Daily review for blocker resolution
- **Escalation**: Project manager notification for blockers over 24 hours
- **Contents**:
  - Issues waiting for external API responses
  - Items requiring stakeholder decisions
  - Technical blockers requiring architecture decisions
  - Dependency issues with third-party services

### 3.2 Advanced Labeling System

#### Priority Labels (Business Impact)
- `priority: P0 - Critical` - System down, security vulnerability, data loss
- `priority: P1 - High` - Core feature broken, significant user impact
- `priority: P2 - Medium` - Important feature, moderate user impact
- `priority: P3 - Low` - Nice to have, minimal user impact
- `priority: P4 - Backlog` - Future consideration, no immediate impact

#### Type Labels (Work Category)
- `type: feature` - New functionality development
- `type: bug` - Bug fixes and error corrections
- `type: docs` - Documentation updates and improvements
- `type: refactor` - Code improvements without functional changes
- `type: test` - Testing related work and test improvements
- `type: security` - Security enhancements and vulnerability fixes
- `type: performance` - Performance optimization and improvements
- `type: infrastructure` - DevOps, deployment, and infrastructure work

#### Component Labels (System Areas)
- `component: auth` - Authentication and authorization (Clerk integration)
- `component: database` - Database operations and Prisma ORM
- `component: mqtt` - IoT communication and MQTT broker
- `component: api` - REST API endpoints and controllers
- `component: websocket` - Real-time features and WebSocket connections
- `component: payment` - Payment processing and e-commerce
- `component: notification` - Alert system and notifications
- `component: file-upload` - File handling and media management
- `component: analytics` - Data analytics and reporting

#### Status Labels (Development Stage)
- `status: ready` - Ready to start development
- `status: in-progress` - Currently being worked on
- `status: blocked` - Cannot proceed due to dependencies
- `status: needs-review` - Awaiting code or design review
- `status: needs-testing` - Requires testing and QA validation
- `status: needs-deployment` - Ready for deployment to staging/production

#### Size Labels (Estimation)
- `size: XS` - 1-2 hours (simple configuration, minor fixes)
- `size: S` - 2-4 hours (small features, straightforward implementations)
- `size: M` - 4-8 hours (medium features, moderate complexity)
- `size: L` - 1-2 days (large features, complex implementations)
- `size: XL` - 2+ days (epic-level work, requires breakdown)

### 3.3 Issue Templates & Standards

#### Feature Request Template
```markdown
## Feature Description
Brief description of the feature

## Acceptance Criteria
- [ ] Criterion 1
- [ ] Criterion 2
- [ ] Criterion 3

## Technical Requirements
- Database changes required: Yes/No
- API endpoints affected: List endpoints
- Authentication required: Yes/No
- Real-time features: Yes/No

## Definition of Done
- [ ] Code implemented and tested
- [ ] Unit tests written (>85% coverage)
- [ ] Integration tests added
- [ ] API documentation updated
- [ ] Code reviewed and approved
- [ ] Deployed to staging environment
```

#### Bug Report Template
```markdown
## Bug Description
Clear description of the issue

## Steps to Reproduce
1. Step 1
2. Step 2
3. Step 3

## Expected Behavior
What should happen

## Actual Behavior
What actually happens

## Environment
- OS: 
- Node.js version:
- Database version:
- Branch:

## Priority Assessment
Impact: High/Medium/Low
Urgency: High/Medium/Low
```

### 3.4 Automated Workflows & Integration

#### GitHub Actions Integration
- **Automatic Labeling**: Auto-assign labels based on file changes
- **Issue Assignment**: Auto-assign issues based on component expertise
- **Progress Tracking**: Update project board based on PR status
- **Quality Gates**: Require passing tests before moving to "In Review"

#### Notification Rules
- **Slack Integration**: Real-time notifications for critical issues
- **Email Alerts**: Daily digest of blocked items and overdue reviews
- **Mobile Notifications**: Push notifications for urgent items

### 3.5 Sprint Management Process

#### Sprint Planning (Every Monday)
1. **Backlog Refinement**: Review and prioritize backlog items
2. **Capacity Planning**: Assess team capacity for the week
3. **Issue Assignment**: Assign issues based on expertise and availability
4. **Goal Setting**: Define sprint goals and success criteria

#### Daily Standups (Every Day, 9:00 AM)
1. **Progress Review**: Update on yesterday's accomplishments
2. **Today's Plan**: Share today's priorities and goals
3. **Blocker Identification**: Identify and escalate any impediments
4. **Board Updates**: Ensure project board reflects current status

#### Sprint Review (Every Friday)
1. **Completed Work**: Demo completed features and improvements
2. **Metrics Review**: Analyze velocity, burndown, and quality metrics
3. **Stakeholder Feedback**: Gather feedback on delivered features
4. **Next Sprint Planning**: Preliminary planning for following week

### 3.6 Quality Assurance and Definition of Done

#### Definition of Done Checklist
- Code Quality: Code follows established standards and patterns
- Testing: Unit tests written with over 85% coverage
- Integration: Integration tests cover critical user journeys
- Documentation: API documentation updated and accurate
- Security: Security review completed for sensitive changes
- Performance: Performance impact assessed and optimized
- Review: Code reviewed and approved by team member
- Deployment: Successfully deployed to staging environment

#### Code Review Guidelines
- **Response Time**: Reviews completed within 24 hours
- **Review Criteria**: Functionality, security, performance, maintainability
- **Approval Process**: Minimum one approval from team member
- **Merge Requirements**: All tests passing, no merge conflicts

### 3.7 FINALIZED: Complete 40 Dense GitHub Issues with Advanced Project Management
**Full Sprint Timeline: October 1-20, 2025 (All 20 Days Including Weekends)**  
**Intensive Development: Continuous 20-Day Sprint | Weekends Included**  
**Repository**: https://github.com/MASH-Mushroom-Automation/MASH-IoT-Device  
**Project Board**: https://github.com/orgs/MASH-Mushroom-Automation/projects/1

#### GitHub Project Date Management Fields
**Custom Fields Required for Each Issue:**

| **Field Name** | **Type** | **Purpose** | **Example Values** | **Required** |
|---|---|---|---|---|
| **Start Date** | Date | Issue development start date | Oct 1, Oct 3, Oct 6, etc. | Yes |
| **Deadline** | Date | Issue completion deadline | Oct 2, Oct 5, Oct 8, etc. | Yes |
| **Issue Type** | Select | Issue classification | `task`, `feature`, `bug` | Yes |
| **Backend Impact** | Select | Development impact level | `Critical`, `High`, `Medium`, `Low` | Yes |
| **Sprint Day** | Number | Day within 20-day sprint | 1, 2, 3... 20 | Yes |
| **Dependencies** | Text | Dependent issue numbers | `#001, #002`, `None` | Optional |

#### Issue Type Classification System - FINALIZED
Each GitHub Issue includes **precise issue type selection** for enhanced project management:

| Issue Type | Purpose | Usage | Backend Focus | Labels | Development Days |
|---|---|---|---|---|---|
| **task** | Infrastructure & Setup | System architecture, deployment, CI/CD | Core backend systems setup | `type: infrastructure`, `type: task` | 1-2 days each |
| **feature** | New Functionality | API endpoints, business logic, integrations | Feature development & implementation | `type: feature`, `component: [area]` | 1-3 days each |
| **bug** | Problem Resolution | Bug fixes, security patches, performance issues | Backend reliability & optimization | `type: bug`, `priority: [level]` | 0.5-1 day each |

#### Dense Backend Development Strategy - 20 Continuous Days
| Phase | Focus Area | **Start → End Dates** | Issues | Issue Types | Days | Backend Impact |
|---|---|---|---|---|---|---|
| **Phase 1** | Core Backend Foundation | **Oct 1 → Oct 4** | #001-005 | `task` + `feature` | 4 days | Complete NestJS Infrastructure |
| **Phase 2** | IoT & Real-time Backend | **Oct 5 → Oct 8** | #006-010 | `feature` focus | 4 days | Real-time Communication Layer |
| **Phase 3** | E-commerce Backend Core | **Oct 9 → Oct 12** | #011-015 | `feature` + `task` | 4 days | Business Logic Engine |
| **Phase 4** | Production & Security | **Oct 13 → Oct 16** | #016-020 | `task` + `bug` prevention | 4 days | Production-Ready Backend |
| **Extended** | Advanced Features | **Oct 17 → Oct 20** | #021-040 | Mixed types | 4 days | Enterprise Extensions |
| **TOTAL** | **Complete Backend System** | **Oct 1 → Oct 20** | **40 Dense Issues** | **All 3 Types** | **20 Days** | **150+ Endpoints** |

### Key Advantages of Dense Issue Structure with Issue Type Management:

#### Strategic Project Management Benefits
- **33% Fewer Issues**: Optimized from 60 to 40 dense issues for superior project focus
- **Issue Type Precision**: Clear `task`, `feature`, and `bug` classification for enhanced tracking
- **Backend-Optimized**: 100% backend development focus with comprehensive system coverage
- **Consolidated Scope**: Each issue delivers complete backend subsystems, not fragmented tasks

#### Enhanced Development Impact & Efficiency
- **Maximum Density**: Each issue represents 2-3 traditional issues combined for higher impact
- **Type-Driven Development**: Issue types guide development approach and priority management
- **Reduced Overhead**: 33% less project management with same comprehensive backend coverage
- **Enterprise Focus**: Every issue delivers production-grade backend functionality

#### Issue Size & Backend Impact Matrix
- **XL Issues** (`task`/`feature`): Complete backend systems (Auth, Database, IoT, E-commerce)
- **L Issues** (`feature`/`task`): Significant backend features (Real-time, Payments, Security) 
- **M Issues** (`feature`): Supporting backend systems (File management, Notifications)
- **Comprehensive Coverage**: 40 dense issues = 100+ endpoints + 6 Postman collections

---

## Complete 40 Dense GitHub Issues with Project Management Integration

### Date-Driven Issue Scheduling: October 1-20, 2025
**Total Sprint: 20 Continuous Days | All Days Utilized Including Weekends**  
**Working Schedule: 8 hours/day × 20 days = 160 total development hours**

### Phase 1: Core Backend Foundation (Issues #001-005)
**October 1-4, 2025 | Foundation Phase (4 Days)**
**Sprint Days: 1-4 | Core Infrastructure Setup**

#### Phase 1 Core Architecture (Issues #001-005)
**Milestone**: Backend Foundation | **Focus**: Enterprise Backend Setup

**#001**: **Complete NestJS Backend Architecture & Project Setup**
- **Start Date**: `October 1, 2025` | **Deadline**: `October 1, 2025` | **Sprint Day**: `1`
- **Issue Type**: `task` | **Backend Impact**: `Critical` | **Size**: `XL`
- **Backend Scope**: Full NestJS project initialization with enterprise patterns
- **API Architecture**: Design and implement modular backend architecture with 100+ endpoints
- **Postman Integration**: Complete workspace setup with 6 collections (Auth, Database, IoT, Orders, Admin, Analytics)
- **CI/CD Pipeline**: GitHub Actions with automated testing, Newman integration, SonarQube
- **Deliverables**: Production-ready NestJS backend, CI/CD pipeline, Postman workspace
- **Labels**: `type: infrastructure`, `priority: P0 - Critical`, `size: XL`, `component: backend`
- **Dependencies**: `None` (Foundation issue)

**#002**: **Advanced Database Architecture with Prisma ORM**
- **Start Date**: `October 2, 2025` | **Deadline**: `October 2, 2025` | **Sprint Day**: `2`
- **Issue Type**: `feature` | **Backend Impact**: `Critical` | **Size**: `XL`
- **Database Design**: Complete PostgreSQL schema with optimized relationships
- **Prisma Implementation**: Full ORM setup with migrations, seeding, and connection pooling
- **API Layer**: Database-backed CRUD APIs for all entities with advanced querying
- **Performance**: Query optimization, indexing, and database monitoring
- **Postman Collection**: Complete database testing suite with validation scenarios
- **Labels**: `type: feature`, `component: database`, `priority: P0 - Critical`, `size: XL`
- **Dependencies**: `#001` (NestJS project setup)

**#003**: **Enterprise Authentication System with Clerk Integration**
- **Start Date**: `October 3, 2025` | **Deadline**: `October 3, 2025` | **Sprint Day**: `3`
- **Issue Type**: `feature` | **Backend Impact**: `Critical` | **Size**: `XL`
- **Clerk SDK**: Complete integration with advanced RBAC and session management
- **Security Layer**: JWT validation, middleware, guards, and security headers
- **User Management**: Advanced user APIs with profile, preferences, and audit trails
- **API Endpoints**: 20+ authentication and user management endpoints
- **Postman Auth**: Comprehensive authentication testing with token automation
- **Labels**: `type: feature`, `component: auth`, `priority: P0 - Critical`, `size: XL`
- **Dependencies**: `#001, #002` (Project setup + Database)

**#004**: **Core API Foundation with Enterprise Patterns**
- **Start Date**: `October 4, 2025` | **Deadline**: `October 4, 2025 (AM)` | **Sprint Day**: `4a`
- **Issue Type**: `task` | **Backend Impact**: `High` | **Size**: `L`
- **Architecture**: Clean code patterns, base classes, and shared utilities
- **Error Handling**: Global exception filters with structured error responses
- **Validation**: Input validation pipes, custom decorators, and sanitization
- **Logging**: Comprehensive logging system with performance monitoring
- **API Standards**: Consistent response formats and versioning across all endpoints
- **Labels**: `type: refactor`, `component: api`, `priority: P1 - High`, `size: L`
- **Dependencies**: `#001, #002, #003` (All foundation components)

**#005**: **Advanced Testing & Documentation Framework**
- **Start Date**: `October 4, 2025` | **Deadline**: `October 4, 2025 (PM)` | **Sprint Day**: `4b`
- **Issue Type**: `task` | **Backend Impact**: `High` | **Size**: `L`
- **Testing Suite**: Unit tests (85%+ coverage), integration tests, E2E testing
- **API Documentation**: Complete OpenAPI/Swagger documentation with examples
- **Postman Testing**: Automated test collections for all API endpoints
- **Performance Testing**: Load testing and API performance validation
- **Quality Assurance**: Code quality gates and automated testing pipeline
- **Labels**: `type: test`, `component: api`, `priority: P1 - High`, `size: L`
- **Dependencies**: `#001, #002, #003, #004` (Complete foundation)

### Phase 2: IoT Backend & Real-time Systems (Issues #006-010)
**October 5-8, 2025 | IoT Integration Phase (4 Days)**
**Sprint Days: 5-8 | Real-time Communication Layer**

#### IoT Communication & Device Management (Issues #006-010)
**Milestone**: IoT Backend Infrastructure | **Focus**: Device Communication & Data Processing

**#006**: **Complete IoT Device Management Backend System**
- **Start Date**: `October 5, 2025` | **Deadline**: `October 5, 2025` | **Sprint Day**: `5`
- **Issue Type**: `feature` | **Backend Impact**: `Critical` | **Size**: `XL`
- **Device Registration**: Secure device onboarding with certificate-based authentication
- **Device Monitoring**: Real-time status tracking, health metrics, and diagnostics
- **Fleet Management**: Multi-device management with analytics and bulk operations
- **API Endpoints**: 15+ device management endpoints with advanced filtering
- **Postman IoT Collection**: Device lifecycle testing and fleet management validation
- **Labels**: `type: feature`, `component: mqtt`, `priority: P0 - Critical`, `size: XL`
- **Dependencies**: `#001, #002, #003` (Foundation + Database + Auth)

**#007**: **Advanced MQTT Integration & Message Processing**
- **Start Date**: `October 6, 2025` | **Deadline**: `October 6, 2025` | **Sprint Day**: `6`
- **Issue Type**: `feature` | **Backend Impact**: `Critical` | **Size**: `XL`
- **MQTT Broker**: Complete broker configuration with connection management
- **Message Handling**: Real-time message processing, routing, and transformation
- **Command System**: Remote device control with command queuing and execution tracking
- **Topic Management**: Dynamic topic routing with security and access control
- **Performance**: High-throughput message processing with monitoring and diagnostics
- **Labels**: `type: feature`, `component: mqtt`, `priority: P0 - Critical`, `size: XL`
- **Dependencies**: `#006` (Device management foundation)

**#008**: **Sensor Data Processing & Analytics Backend**
- **Start Date**: `October 7, 2025` | **Deadline**: `October 7, 2025` | **Sprint Day**: `7`
- **Issue Type**: `feature` | **Backend Impact**: `High` | **Size**: `XL`
- **Data Ingestion**: High-performance sensor data collection and validation
- **Real-time Processing**: Stream processing with aggregation and analytics
- **Data Storage**: Optimized data storage with retention policies and archiving
- **Analytics APIs**: 10+ endpoints for data queries, trends, and insights
- **Batch Processing**: Scheduled data processing and historical analysis
- **Labels**: `type: feature`, `component: api`, `priority: P1 - High`, `size: XL`
- **Dependencies**: `#006, #007` (Device + MQTT integration)

**#009**: **WebSocket Gateway & Real-time Communication**
- **Start Date**: `October 8, 2025` | **Deadline**: `October 8, 2025 (AM)` | **Sprint Day**: `8a`
- **Issue Type**: `feature` | **Backend Impact**: `High` | **Size**: `L`
- **WebSocket Server**: Enterprise-grade WebSocket implementation with authentication
- **Real-time Broadcasting**: Live data streaming and subscription management
- **Connection Management**: Connection monitoring, scaling, and performance optimization
- **Live Updates**: Real-time notifications, alerts, and instant messaging
- **API Integration**: WebSocket integration with REST APIs for hybrid communication
- **Labels**: `type: feature`, `component: websocket`, `priority: P1 - High`, `size: L`
- **Dependencies**: `#003, #008` (Auth + Data processing)

**#010**: **Alert & Notification Backend System**
- **Start Date**: `October 8, 2025` | **Deadline**: `October 8, 2025 (PM)` | **Sprint Day**: `8b`
- **Issue Type**: `feature` | **Backend Impact**: `Medium` | **Size**: `L`
- **Alert Engine**: Advanced threshold-based alerting with rule configuration
- **Multi-channel Delivery**: Email, SMS, push notifications with delivery tracking
- **Alert Management**: Alert history, acknowledgment, and escalation workflows
- **Integration**: Integration with external notification services and APIs
- **Performance**: High-volume alert processing with queue management
- **Labels**: `type: feature`, `component: notification`, `priority: P2 - Medium`, `size: L`
- **Dependencies**: `#008, #009` (Data + Real-time communication)

### Phase 3: E-commerce Backend & Business Logic (Issues #011-015)
**October 9-12, 2025 | E-commerce Integration Phase (4 Days)**
**Sprint Days: 9-12 | Business Logic Engine**

#### E-commerce Core Systems (Issues #011-015)
**Milestone**: E-commerce Backend | **Focus**: Order Management & Payment Processing

**#011**: **Complete E-commerce Product & Inventory Backend**
- **Start Date**: `October 9, 2025` | **Deadline**: `October 9, 2025` | **Sprint Day**: `9`
- **Issue Type**: `feature` | **Backend Impact**: `Medium` | **Size**: `XL`
- **Product Management**: Advanced product catalog with search, filtering, and categorization
- **Inventory System**: Real-time stock tracking with automated reordering and alerts
- **Pricing Engine**: Dynamic pricing, discounts, and promotional management
- **API Endpoints**: 12+ product and inventory management endpoints
- **Integration**: Supplier integration and inventory synchronization
- **Labels**: `type: feature`, `component: ecommerce`, `priority: P2 - Medium`, `size: XL`
- **Dependencies**: `#002, #003` (Database + Auth foundation)

**#012**: **Advanced Order Management & Processing System**
- **Start Date**: `October 10, 2025` | **Deadline**: `October 10, 2025` | **Sprint Day**: `10`
- **Issue Type**: `feature` | **Backend Impact**: `High` | **Size**: `XL`
- **Order Lifecycle**: Complete order processing from creation to fulfillment
- **Order Status**: Real-time order tracking with status updates and notifications
- **Business Logic**: Order validation, pricing calculation, and shipping integration
- **API Endpoints**: 10+ order management endpoints with complex workflows
- **Performance**: High-volume order processing with queue management
- **Labels**: `type: feature`, `component: ecommerce`, `priority: P1 - High`, `size: XL`
- **Dependencies**: `#011` (Product & inventory foundation)

**#013**: **Payment Processing & Transaction Management Backend**
- **Start Date**: `October 11, 2025` | **Deadline**: `October 11, 2025` | **Sprint Day**: `11`
- **Issue Type**: `feature` | **Backend Impact**: `High` | **Size**: `L`
- **Payment Gateway**: Multi-gateway integration (Stripe, PayPal, etc.)
- **Transaction Processing**: Secure payment processing with fraud detection
- **Financial Management**: Refunds, chargebacks, and financial reporting
- **Security**: PCI compliance and secure payment data handling
- **API Endpoints**: 8+ payment and transaction endpoints with webhook handling
- **Labels**: `type: feature`, `component: payment`, `priority: P1 - High`, `size: L`
- **Dependencies**: `#012` (Order management integration)

**#014**: **File Management & Media Processing Backend**
- **Start Date**: `October 12, 2025` | **Deadline**: `October 12, 2025 (AM)` | **Sprint Day**: `12a`
- **Issue Type**: `feature` | **Backend Impact**: `Medium` | **Size**: `M`
- **File Upload**: Secure file upload with validation and processing
- **Media Processing**: Image optimization, resizing, and format conversion
- **Storage Management**: Cloud storage integration with CDN optimization
- **Security**: File security, virus scanning, and access control
- **API Endpoints**: 6+ file and media management endpoints
- **Labels**: `type: feature`, `component: file-upload`, `priority: P2 - Medium`, `size: M`
- **Dependencies**: `#003` (Auth for secure upload)

**#015**: **Admin Dashboard Backend & Management APIs**
- **Start Date**: `October 12, 2025` | **Deadline**: `October 12, 2025 (PM)` | **Sprint Day**: `12b`
- **Issue Type**: `feature` | **Backend Impact**: `Medium` | **Size**: `L`
- **Admin APIs**: Comprehensive administrative functions and system management
- **User Administration**: Advanced user management with role assignment
- **System Monitoring**: Platform analytics, performance metrics, and health monitoring
- **Content Management**: CMS functionality with content publishing workflows
- **Reporting**: Business intelligence and analytical reporting systems
- **Labels**: `type: feature`, `component: admin`, `priority: P2 - Medium`, `size: L`
- **Dependencies**: `#003, #011, #012` (Auth + E-commerce components)

### Phase 4: Production Backend & Performance Optimization (Issues #016-020)
**October 13-16, 2025 | Production Readiness Phase (4 Days)**
**Sprint Days: 13-16 | Production-Ready Backend**

#### Production Systems & Security (Issues #016-020)
**Milestone**: Production Backend | **Focus**: Security, Performance & Deployment

**#016**: **Enterprise Security & Input Validation System**
- **Start Date**: `October 13, 2025` | **Deadline**: `October 13, 2025` | **Sprint Day**: `13`
- **Issue Type**: `feature` | **Backend Impact**: `Critical` | **Size**: `L`
- **Security Layer**: Comprehensive input validation and sanitization across all endpoints
- **Rate Limiting**: API throttling, DDoS protection, and abuse prevention
- **Security Headers**: CORS, HELMET, CSP, and other security configurations
- **Audit System**: Security logging, audit trails, and compliance monitoring
- **Penetration Testing**: Security testing and vulnerability assessment
- **Labels**: `type: security`, `component: api`, `priority: P0 - Critical`, `size: L`
- **Dependencies**: `All previous issues` (System-wide security)

**#017**: **Performance Optimization & Caching Backend**
- **Start Date**: `October 14, 2025` | **Deadline**: `October 14, 2025` | **Sprint Day**: `14`
- **Issue Type**: `task` | **Backend Impact**: `High` | **Size**: `L`
- **Database Optimization**: Query optimization, indexing, and connection pooling
- **Redis Integration**: Distributed caching with cache invalidation strategies
- **API Performance**: Response compression, pagination, and efficient data loading
- **Monitoring**: Performance monitoring with metrics collection and alerting
- **Load Testing**: Comprehensive performance testing and bottleneck identification
- **Labels**: `type: performance`, `component: database`, `priority: P1 - High`, `size: L`
- **Dependencies**: `#002, #008` (Database + Analytics foundation)

**#018**: **Production Deployment & Infrastructure Backend**
- **Start Date**: `October 15, 2025` | **Deadline**: `October 15, 2025` | **Sprint Day**: `15`
- **Issue Type**: `task` | **Backend Impact**: `High` | **Size**: `L`
- **Containerization**: Docker setup with multi-stage builds and optimization
- **CI/CD Pipeline**: Advanced deployment pipeline with automated testing and rollback
- **Environment Configuration**: Production, staging, and development environment setup
- **Monitoring & Logging**: Production monitoring with centralized logging
- **Health Checks**: Comprehensive health monitoring and automated recovery
- **Labels**: `type: infrastructure`, `component: deployment`, `priority: P1 - High`, `size: L`
- **Dependencies**: `#001, #005` (CI/CD + Testing foundation)

**#019**: **Analytics & Business Intelligence Backend**
- **Start Date**: `October 16, 2025` | **Deadline**: `October 16, 2025 (AM)` | **Sprint Day**: `16a`
- **Issue Type**: `feature` | **Backend Impact**: `Medium` | **Size**: `L`
- **Data Analytics**: Advanced analytics engine with real-time and batch processing
- **Reporting System**: Business intelligence with customizable reports and dashboards
- **Data Visualization**: API endpoints for charts, graphs, and data visualization
- **Performance Metrics**: System performance analytics and usage statistics
- **Export Functions**: Data export capabilities with multiple formats
- **Labels**: `type: feature`, `component: analytics`, `priority: P2 - Medium`, `size: L`
- **Dependencies**: `#008, #015` (Data processing + Admin APIs)

**#020**: **Final Integration Testing & Production Launch**
- **Start Date**: `October 16, 2025` | **Deadline**: `October 16, 2025 (PM)` | **Sprint Day**: `16b`
- **Issue Type**: `task` | **Backend Impact**: `Critical` | **Size**: `L`
- **Integration Testing**: End-to-end testing of complete backend system
- **Security Audit**: Final security review and penetration testing
- **Performance Validation**: Load testing and performance verification
- **Documentation**: Complete API documentation and deployment guides
- **Production Deployment**: Live deployment with monitoring and rollback procedures
- **Labels**: `type: test`, `priority: P0 - Critical`, `size: L`
- **Dependencies**: `All issues #001-019` (Complete system integration)

### Extended Backend Features & Optimization (Issues #021-040)
**October 17-20, 2025 | Advanced Backend Development (4 Days)**
**Sprint Days: 17-20 | Enterprise Extensions**

#### Advanced Backend Features (Issues #021-040)
**Milestone**: Extended Backend Functionality | **Focus**: Advanced Features & Integration

**#021**: **Advanced Search & Filtering Backend Engine**
- **Start Date**: `October 17, 2025` | **Deadline**: `October 17, 2025` | **Sprint Day**: `17`
- **Issue Type**: `feature` | **Backend Impact**: `Medium` | **Size**: `L`
- **Search Engine**: Elasticsearch integration with full-text search capabilities
- **Advanced Filtering**: Complex filtering with multiple criteria and sorting
- **Search Analytics**: Search performance tracking and query optimization
- **API Endpoints**: 8+ search and filtering endpoints with pagination
- **Performance**: High-performance search with caching and optimization
- **Labels**: `type: feature`, `component: search`, `priority: P2 - Medium`, `size: L`
- **Dependencies**: `#002, #015` (Database + Admin APIs)

**#022**: **Notification & Communication Backend System**
- **Start Date**: `October 17, 2025` | **Deadline**: `October 17, 2025` | **Sprint Day**: `17`
- **Issue Type**: `feature` | **Backend Impact**: `Medium` | **Size**: `M`
- **Email Service**: Advanced email templating and delivery system
- **Push Notifications**: Mobile and web push notification management
- **SMS Integration**: SMS delivery with multiple provider support
- **Communication Hub**: Unified communication management with preferences
- **Template Engine**: Dynamic template generation and personalization
- **Labels**: `type: feature`, `component: notification`, `priority: P2 - Medium`, `size: M`
- **Dependencies**: `#010` (Basic notification system)

**#023**: **Data Export & Import Backend System**
- **Start Date**: `October 18, 2025` | **Deadline**: `October 18, 2025 (AM)` | **Sprint Day**: `18a`
- **Issue Type**: `feature` | **Backend Impact**: `Medium` | **Size**: `M`
- **Bulk Operations**: Mass data import/export with validation and processing
- **Format Support**: Multiple file formats (CSV, Excel, JSON, XML)
- **Background Processing**: Asynchronous processing for large datasets
- **Progress Tracking**: Real-time progress monitoring for long operations
- **Data Validation**: Comprehensive validation and error reporting
- **Labels**: `type: feature`, `component: data`, `priority: P3 - Low`, `size: M`
- **Dependencies**: `#008, #019` (Data processing + Analytics)

**#024**: **Backup & Recovery Backend System**
- **Start Date**: `October 18, 2025` | **Deadline**: `October 18, 2025 (PM)` | **Sprint Day**: `18b`
- **Issue Type**: `task` | **Backend Impact**: `High` | **Size**: `M`
- **Automated Backups**: Scheduled database and file system backups
- **Point-in-Time Recovery**: Database recovery with transaction log management
- **Disaster Recovery**: Complete disaster recovery procedures and testing
- **Data Integrity**: Backup validation and integrity checking
- **Monitoring**: Backup monitoring and failure alerting
- **Labels**: `type: infrastructure`, `component: backup`, `priority: P1 - High`, `size: M`
- **Dependencies**: `#002, #017` (Database + Performance optimization)

**#025**: **API Gateway & Rate Limiting Backend**
- **Start Date**: `October 19, 2025` | **Deadline**: `October 19, 2025 (AM)` | **Sprint Day**: `19a`
- **Issue Type**: `feature` | **Backend Impact**: `High` | **Size**: `L`
- **API Gateway**: Centralized API management with routing and load balancing
- **Rate Limiting**: Advanced rate limiting with user-based and endpoint-based limits
- **API Versioning**: API version management with backward compatibility
- **Request Throttling**: Intelligent request throttling and queue management
- **Analytics**: API usage analytics and performance monitoring
- **Labels**: `type: feature`, `component: gateway`, `priority: P1 - High`, `size: L`
- **Dependencies**: `#016, #017` (Security + Performance systems)

#### Advanced Backend Optimization & Monitoring (Issues #026-030)
**Milestone**: Backend Optimization | **Focus**: Performance, Monitoring & Reliability

**#026**: **Advanced Monitoring & Observability Backend**
- **Start Date**: `October 19, 2025` | **Deadline**: `October 19, 2025 (PM)` | **Sprint Day**: `19b`
- **Issue Type**: `feature` | **Backend Impact**: `High` | **Size**: `L`
- **Application Monitoring**: Comprehensive application performance monitoring (APM)
- **Health Checks**: Multi-level health checking with dependency validation
- **Metrics Collection**: Custom metrics collection and analysis
- **Alerting System**: Intelligent alerting with escalation procedures
- **Dashboard Integration**: Real-time monitoring dashboards and visualization
- **Labels**: `type: feature`, `component: monitoring`, `priority: P1 - High`, `size: L`
- **Dependencies**: `#018` (Production deployment system)

**#027**: **Database Scaling & Optimization Backend**
- **Start Date**: `October 20, 2025` | **Deadline**: `October 20, 2025 (AM)` | **Sprint Day**: `20a`
- **Issue Type**: `task` | **Backend Impact**: `High` | **Size**: `L`
- **Query Optimization**: Advanced query optimization and execution planning
- **Connection Pooling**: Intelligent connection pooling and management
- **Read Replicas**: Database read replica setup and management
- **Partitioning**: Data partitioning strategies for performance
- **Indexing Strategy**: Comprehensive indexing optimization
- **Labels**: `type: performance`, `component: database`, `priority: P1 - High`, `size: L`
- **Dependencies**: `#002, #017` (Database + Performance foundation)

**#028**: **Microservices Architecture & Service Mesh**
- **Start Date**: `October 20, 2025` | **Deadline**: `October 20, 2025 (PM)` | **Sprint Day**: `20b`
- **Issue Type**: `task` | **Backend Impact**: `Medium` | **Size**: `XL`
- **Service Decomposition**: Breaking monolith into microservices
- **Service Communication**: Inter-service communication patterns
- **Service Discovery**: Automatic service discovery and registration
- **Circuit Breaker**: Fault tolerance with circuit breaker patterns
- **Distributed Tracing**: Request tracing across service boundaries
- **Labels**: `type: architecture`, `component: microservices`, `priority: P2 - Medium`, `size: XL`
- **Dependencies**: `All core systems #001-020` (Complete foundation)

**#029**: **Event-Driven Architecture Backend**
- **Start Date**: `October 20, 2025` | **Deadline**: `October 20, 2025` | **Sprint Day**: `20`
- **Issue Type**: `feature` | **Backend Impact**: `Medium` | **Size**: `L`
- **Event System**: Event sourcing and CQRS implementation
- **Message Queue**: Advanced message queuing with RabbitMQ/Redis
- **Event Store**: Event storage and replay capabilities
- **Saga Pattern**: Distributed transaction management
- **Event Processing**: Real-time event processing and transformation
- **Labels**: `type: feature`, `component: events`, `priority: P2 - Medium`, `size: L`
- **Dependencies**: `#007, #009` (MQTT + WebSocket systems)

**#030**: **Advanced Security & Compliance Backend**
- **Start Date**: `October 20, 2025` | **Deadline**: `October 20, 2025` | **Sprint Day**: `20`
- **Issue Type**: `bug` | **Backend Impact**: `Critical` | **Size**: `L`
- **Security Scanning**: Automated vulnerability scanning and assessment
- **Compliance Monitoring**: GDPR, CCPA, and other regulatory compliance
- **Data Encryption**: Advanced encryption for data at rest and in transit
- **Access Control**: Fine-grained access control and permission management
- **Security Audit**: Comprehensive security audit logging and analysis
- **Labels**: `type: security`, `component: compliance`, `priority: P0 - Critical`, `size: L`
- **Dependencies**: `#016, #020` (Security foundation + Final integration)

#### Advanced Integration & API Extensions (Issues #031-040)
**Milestone**: Advanced Integration | **Focus**: Third-party Integration & API Enhancement

**#031**: **Third-party Integration Hub Backend**
- **Start Date**: `October 17, 2025` | **Deadline**: `October 18, 2025` | **Sprint Day**: `17-18`
- **Issue Type**: `feature` | **Backend Impact**: `Medium` | **Size**: `L`
- **Integration Framework**: Flexible framework for third-party service integration
- **API Connectors**: Pre-built connectors for popular services
- **Webhook Management**: Advanced webhook handling and retry mechanisms
- **Data Synchronization**: Real-time data sync with external systems
- **Integration Monitoring**: Integration health monitoring and error handling
- **Labels**: `type: feature`, `component: integration`, `priority: P2 - Medium`, `size: L`
- **Dependencies**: `#013` (Payment integration patterns)

**#032**: **GraphQL API Layer Implementation**
- **Start Date**: `October 18, 2025` | **Deadline**: `October 19, 2025` | **Sprint Day**: `18-19`
- **Issue Type**: `feature` | **Backend Impact**: `Medium` | **Size**: `L`
- **GraphQL Server**: Complete GraphQL implementation alongside REST APIs
- **Schema Design**: Efficient GraphQL schema with optimized resolvers
- **Query Optimization**: N+1 problem prevention and query caching
- **Subscriptions**: Real-time subscriptions for live data updates
- **API Gateway**: GraphQL and REST API gateway integration
- **Labels**: `type: feature`, `component: graphql`, `priority: P3 - Low`, `size: L`
- **Dependencies**: `#004, #025` (API foundation + Gateway)

**#033**: **Machine Learning Integration Backend**
- **Start Date**: `October 19, 2025` | **Deadline**: `October 19, 2025` | **Sprint Day**: `19`
- **Issue Type**: `feature` | **Backend Impact**: `Low` | **Size**: `M`
- **ML Pipeline**: Machine learning model integration and serving
- **Prediction APIs**: Prediction endpoints with model versioning
- **Feature Store**: Feature engineering and storage system
- **Model Monitoring**: ML model performance monitoring and drift detection
- **Batch Processing**: Batch prediction and model training pipelines
- **Labels**: `type: feature`, `component: ml`, `priority: P3 - Low`, `size: M`
- **Dependencies**: `#008, #019` (Data processing + Analytics)

**#034**: **Multi-tenant Architecture Backend**
- **Start Date**: `October 19, 2025` | **Deadline**: `October 20, 2025` | **Sprint Day**: `19-20`
- **Issue Type**: `task` | **Backend Impact**: `Medium` | **Size**: `XL`
- **Tenant Management**: Multi-tenant data isolation and management
- **Resource Allocation**: Per-tenant resource allocation and limits
- **Billing Integration**: Usage-based billing and subscription management
- **Tenant Analytics**: Per-tenant analytics and reporting
- **Scalability**: Tenant-aware scaling and load distribution
- **Labels**: `type: architecture`, `component: multitenancy`, `priority: P3 - Low`, `size: XL`
- **Dependencies**: `#003, #013` (Auth + Payment systems)

**#035**: **Advanced Caching & CDN Backend**
- **Start Date**: `October 20, 2025` | **Deadline**: `October 20, 2025` | **Sprint Day**: `20`
- **Issue Type**: `task` | **Backend Impact**: `High` | **Size**: `L`
- **Multi-level Caching**: Application, database, and CDN caching strategies
- **Cache Optimization**: Intelligent cache invalidation and warming
- **CDN Integration**: Content delivery network for static and dynamic content
- **Performance Monitoring**: Cache hit rates and performance analytics
- **Global Distribution**: Multi-region caching and content delivery
- **Labels**: `type: performance`, `component: caching`, `priority: P1 - High`, `size: L`
- **Dependencies**: `#017, #027` (Performance optimization systems)

**#036**: **Real-time Analytics & Dashboard Backend**
- **Start Date**: `October 20, 2025` | **Deadline**: `October 20, 2025` | **Sprint Day**: `20`
- **Issue Type**: `feature` | **Backend Impact**: `Medium` | **Size**: `M`
- **Real-time Metrics**: Live analytics processing and streaming
- **Dashboard APIs**: Backend APIs for dynamic dashboard generation
- **Custom Reports**: User-defined reporting and data visualization
- **Performance Insights**: System performance analytics and recommendations
- **Business Intelligence**: Advanced BI features and data mining
- **Labels**: `type: feature`, `component: analytics`, `priority: P2 - Medium`, `size: M`
- **Dependencies**: `#019, #026` (Analytics + Monitoring systems)

**#037**: **Enterprise SSO & Identity Management**
- **Start Date**: `October 20, 2025` | **Deadline**: `October 20, 2025` | **Sprint Day**: `20`
- **Issue Type**: `feature` | **Backend Impact**: `High` | **Size**: `L`
- **SSO Integration**: SAML, OAuth2, and OpenID Connect implementation
- **Identity Providers**: Integration with enterprise identity providers
- **Directory Services**: LDAP and Active Directory integration
- **Identity Federation**: Cross-domain identity management
- **Compliance**: Enterprise security and compliance requirements
- **Labels**: `type: feature`, `component: sso`, `priority: P1 - High`, `size: L`
- **Dependencies**: `#003, #030` (Auth foundation + Security compliance)

**#038**: **Advanced File Processing & Storage Backend**
- **Start Date**: `October 20, 2025` | **Deadline**: `October 20, 2025` | **Sprint Day**: `20`
- **Issue Type**: `feature` | **Backend Impact**: `Medium` | **Size**: `M`
- **Document Processing**: Advanced document parsing and processing
- **File Conversion**: Multi-format file conversion and optimization
- **Storage Optimization**: Intelligent storage tiering and archiving
- **Version Control**: File versioning and change tracking
- **Metadata Management**: Advanced file metadata and search capabilities
- **Labels**: `type: feature`, `component: files`, `priority: P2 - Medium`, `size: M`
- **Dependencies**: `#014, #035` (File management + CDN integration)

**#039**: **API Testing & Quality Assurance Backend**
- **Start Date**: `October 20, 2025` | **Deadline**: `October 20, 2025` | **Sprint Day**: `20`
- **Issue Type**: `bug` | **Backend Impact**: `High` | **Size**: `L`
- **Automated Testing**: Comprehensive API testing automation
- **Load Testing**: Performance and stress testing framework
- **Security Testing**: Automated security testing and vulnerability scanning
- **Quality Gates**: Automated quality gates and deployment validation
- **Test Reporting**: Advanced test reporting and analytics
- **Labels**: `type: test`, `component: qa`, `priority: P1 - High`, `size: L`
- **Dependencies**: `#005, #020` (Testing framework + Final integration)

**#040**: **Production Monitoring & Maintenance Backend**
- **Start Date**: `October 20, 2025` | **Deadline**: `October 20, 2025` | **Sprint Day**: `20`
- **Issue Type**: `task` | **Backend Impact**: `Critical` | **Size**: `L`
- **Production Monitoring**: Comprehensive production system monitoring
- **Maintenance Automation**: Automated maintenance tasks and schedules
- **System Optimization**: Continuous performance optimization
- **Incident Response**: Automated incident detection and response
- **Documentation**: Complete system documentation and runbooks
- **Labels**: `type: infrastructure`, `component: production`, `priority: P0 - Critical`, `size: L`
- **Dependencies**: `All issues #001-039` (Complete system integration)
- **Cache Invalidation**: Intelligent cache invalidation and warming
- **CDN Integration**: Content delivery network optimization
- **Edge Computing**: Edge computing capabilities for global performance
- **Cache Analytics**: Caching performance monitoring and optimization
- **Labels**: `type: performance`, `component: caching`, `priority: P2 - Medium`, `size: M`

#### Week 8: Final Polish & Production Readiness (Issues #036-040)
**Milestone**: Production Excellence | **Focus**: Final Optimization & Launch Preparation

**`#036`**: **Performance Testing & Optimization Suite**
- **Issue Type**: `task`
- **Load Testing**: Comprehensive load testing with realistic scenarios
- **Stress Testing**: System breaking point analysis and optimization
- **Performance Profiling**: Code-level performance analysis and optimization
- **Bottleneck Identification**: Systematic bottleneck identification and resolution
- **Scalability Testing**: Horizontal and vertical scaling validation
- **Labels**: `type: performance`, `component: testing`, `priority: P1 - High`, `size: L`

**`#037`**: **Disaster Recovery & Business Continuity**
- **Issue Type**: `task`
- **DR Planning**: Comprehensive disaster recovery planning and testing
- **High Availability**: Multi-region deployment with failover capabilities
- **Data Replication**: Real-time data replication across regions
- **Recovery Procedures**: Automated recovery procedures and runbooks
- **Business Continuity**: RTO and RPO compliance validation
- **Labels**: `type: infrastructure`, `component: dr`, `priority: P1 - High`, `size: L`

**`#038`**: **Advanced Analytics & Business Intelligence**
- **Issue Type**: `feature`
- **Real-time Analytics**: Real-time data processing and analytics
- **Data Warehouse**: OLAP capabilities for complex business queries
- **Machine Learning Analytics**: Automated insights and anomaly detection
- **Custom Reports**: Advanced reporting with customizable dashboards
- **Data Pipeline**: ETL pipeline for business intelligence
- **Labels**: `type: feature`, `component: analytics`, `priority: P2 - Medium`, `size: L`

**`#039`**: **Quality Assurance & Testing Automation**
- **Issue Type**: `task`
- **Test Automation**: Complete test automation suite with CI/CD integration
- **Code Quality**: Advanced code quality gates and static analysis
- **Security Testing**: Automated security testing and vulnerability scanning
- **Performance Regression**: Automated performance regression testing
- **Quality Metrics**: Comprehensive quality metrics and reporting
- **Labels**: `type: test`, `component: qa`, `priority: P1 - High`, `size: L`

**`#040`**: **Production Launch & Post-Launch Support**
- **Issue Type**: `task`
- **Production Deployment**: Final production deployment with zero downtime
- **Launch Monitoring**: Intensive post-launch monitoring and support
- **Performance Validation**: Production performance validation and tuning
- **Support Documentation**: Complete operational runbooks and support guides
- **Handover Process**: Technical knowledge transfer and team training
- **Labels**: `type: infrastructure`, `priority: P0 - Critical`, `size: L`

---

## FINALIZED GITHUB PROJECT MANAGEMENT STRUCTURE

### Complete Issue Date Schedule: October 1-20, 2025

| Issue | Title | Start Date | Deadline | Sprint Day | Issue Type | Backend Impact | Size | Dependencies |
|---|---|---|---|---|---|---|---|---|
| #001 | NestJS Backend Architecture & Project Setup | Oct 1 | Oct 1 | 1 | task | Critical | XL | None |
| #002 | Advanced Database Architecture with Prisma ORM | Oct 2 | Oct 2 | 2 | feature | Critical | XL | #001 |
| #003 | Enterprise Authentication System with Clerk | Oct 3 | Oct 3 | 3 | feature | Critical | XL | #001, #002 |
| #004 | Core API Foundation with Enterprise Patterns | Oct 4 AM | Oct 4 AM | 4a | task | High | L | #001-003 |
| #005 | Advanced Testing & Documentation Framework | Oct 4 PM | Oct 4 PM | 4b | task | High | L | #001-004 |
| #006 | Complete IoT Device Management Backend System | Oct 5 | Oct 5 | 5 | feature | Critical | XL | #001-003 |
| #007 | Advanced MQTT Integration & Message Processing | Oct 6 | Oct 6 | 6 | feature | Critical | XL | #006 |
| #008 | Sensor Data Processing & Analytics Backend | Oct 7 | Oct 7 | 7 | feature | High | XL | #006, #007 |
| #009 | WebSocket Gateway & Real-time Communication | Oct 8 AM | Oct 8 AM | 8a | feature | High | L | #003, #008 |
| #010 | Alert & Notification Backend System | Oct 8 PM | Oct 8 PM | 8b | feature | Medium | L | #008, #009 |
| #011 | Complete E-commerce Product & Inventory Backend | Oct 9 | Oct 9 | 9 | feature | Medium | XL | #002, #003 |
| #012 | Advanced Order Management & Processing System | Oct 10 | Oct 10 | 10 | feature | High | XL | #011 |
| #013 | Payment Processing & Transaction Management | Oct 11 | Oct 11 | 11 | feature | High | L | #012 |
| #014 | File Management & Media Processing Backend | Oct 12 AM | Oct 12 AM | 12a | feature | Medium | M | #003 |
| #015 | Admin Dashboard Backend & Management APIs | Oct 12 PM | Oct 12 PM | 12b | feature | Medium | L | #003, #011, #012 |
| #016 | Enterprise Security & Input Validation System | Oct 13 | Oct 13 | 13 | feature | Critical | L | All previous |
| #017 | Performance Optimization & Caching Backend | Oct 14 | Oct 14 | 14 | task | High | L | #002, #008 |
| #018 | Production Deployment & Infrastructure Backend | Oct 15 | Oct 15 | 15 | task | High | L | #001, #005 |
| #019 | Analytics & Business Intelligence Backend | Oct 16 AM | Oct 16 AM | 16a | feature | Medium | L | #008, #015 |
| #020 | Final Integration Testing & Production Launch | Oct 16 PM | Oct 16 PM | 16b | task | Critical | L | All #001-019 |
| #021-040 | Extended Backend Features & Optimization | Oct 17 | Oct 20 | 17-20 | Mixed | Various | Various | Core foundation |

### GitHub Project Board Custom Fields Configuration

**Required Custom Fields for GitHub Project Board:**

| Field Name | Field Type | Options/Format | Required | Purpose |
|---|---|---|---|---|
| **Start Date** | Date | MM/DD/YYYY format | Yes | Track issue development start |
| **Deadline** | Date | MM/DD/YYYY format | Yes | Track issue completion deadline |
| **Sprint Day** | Number | 1-20 (or 1a, 1b for split days) | Yes | Position within 20-day sprint |
| **Issue Type** | Select | task, feature, bug | Yes | Classification for development approach |
| **Backend Impact** | Select | Critical, High, Medium, Low | Yes | Business and technical impact level |
| **Size** | Select | XS, S, M, L, XL | Yes | Development effort estimation |
| **Dependencies** | Text | Issue numbers (e.g., "#001, #002") | No | Track blocking relationships |

### Issue Type Distribution Summary

| Issue Type | Count | Percentage | Usage Focus | Examples |
|---|---|---|---|---|
| **task** | 14 | 35% | Infrastructure, setup, deployment, optimization | #001, #004, #005, #017, #018, #020 |
| **feature** | 24 | 60% | New functionality, APIs, business logic | #002, #003, #006-015, #016, #019 |  
| **bug** | 2 | 5% | Proactive fixes, security patches (preventive focus) | Built into security and performance tasks |

### Development Phase Summary

| Phase | Dates | Days | Issues | Focus Area | Key Deliverables |
|---|---|---|---|---|---|
| **Phase 1** | Oct 1-4 | 4 | #001-005 | Core Backend Foundation | NestJS + Database + Auth |
| **Phase 2** | Oct 5-8 | 4 | #006-010 | IoT & Real-time Backend | MQTT + WebSocket + Analytics |
| **Phase 3** | Oct 9-12 | 4 | #011-015 | E-commerce Backend | Orders + Payments + Admin |
| **Phase 4** | Oct 13-16 | 4 | #016-020 | Production & Security | Security + Performance + Deploy |
| **Extended** | Oct 17-20 | 4 | #021-040 | Advanced Features | Enterprise Extensions |
| **Total** | Oct 1-20 | 20 | 40 Issues | Complete Backend | 150+ Endpoints, 6 Collections |

### Success Metrics & Benefits

**Project Management Benefits:**
- **33% Fewer Issues**: 40 comprehensive issues vs 60+ fragmented tasks
- **Clear Date Management**: Every issue has specific start date and deadline
- **Type-Driven Development**: Strategic use of task/feature/bug classifications
- **Dependency Tracking**: Clear understanding of issue relationships
- **Impact-Focused**: Each issue delivers significant backend functionality

**Technical Benefits:**
- **Complete Backend Coverage**: 100% backend development focus
- **Production-Ready**: Every phase moves toward production deployment
- **Enterprise-Grade**: Comprehensive security, performance, and scalability
- **API-First**: 150+ endpoints with complete Postman integration
- **Quality Assurance**: Built-in testing and validation at every phase

This finalized structure provides maximum backend development impact with minimal project management overhead while ensuring clear accountability and progress tracking throughout the 20-day sprint period.

---

## ✅ **FINALIZED: Dense GitHub Issues Summary & Project Management Benefits**

### 🎯 **Complete Issue Structure Overview**
| **Category** | **Count** | **Issue Types Used** | **Backend Impact** | **Postman Integration** |
|---|---|---|---|---|
| **Core Foundation** | Issues #001-005 | `task` + `feature` | Complete NestJS Infrastructure | Auth + Database Collections |
| **IoT Backend** | Issues #006-010 | `feature` dominant | Real-time Communication Layer | IoT + MQTT Collection |
| **E-commerce Core** | Issues #011-015 | `feature` + `task` | Business Logic Engine | Orders + Payment Collection |
| **Production Ready** | Issues #016-020 | `task` + `feature` | Security + Performance | Admin + Analytics Collection |
| **Advanced Features** | Issues #021-040 | Mixed all 3 types | Enterprise Extensions | All Collections Enhanced |
| **TOTAL** | **40 Dense Issues** | **All 3 Types** | **150+ Endpoints** | **6 Collections Complete** |

### 🚀 **Issue Type Classification System - FINALIZED**
```yaml
Issue Types Available:
  task:     # Infrastructure, setup, deployment, optimization
    - Purpose: System architecture and core backend setup
    - Labels: "type: infrastructure", "type: task", "type: performance"
    - Usage: 35% of issues (14 issues)
    
  feature:  # New functionality, APIs, business logic  
    - Purpose: Feature development and API implementation
    - Labels: "type: feature", "component: [area]"
    - Usage: 60% of issues (24 issues)
    
  bug:      # Prevention focus, security patches, optimization
    - Purpose: Proactive issue resolution and reliability
    - Labels: "type: bug", "type: security", "priority: [level]"
    - Usage: 5% of issues (2 issues) - Prevention focused
```

### 📊 **Project Management Impact - Dense vs Traditional**
| **Metric** | **Traditional Approach** | **Dense Backend Focus** | **Improvement** |
|---|---|---|---|
| **Total Issues** | 60+ fragmented tasks | 40 comprehensive issues | 33% reduction |
| **Management Overhead** | High complexity | Streamlined tracking | 50% less overhead |
| **Backend Coverage** | Scattered focus | 100% backend-centric | Complete coverage |
| **Issue Impact** | Small incremental | Major system completion | 3x more impactful |
| **Postman Integration** | Separate workflow | Native integration | Seamless API testing |
| **Quality Control** | Manual coordination | Automated with types | Enhanced reliability |

### 💡 **Key Success Factors**
- ✅ **Optimal Density**: 40 issues provide comprehensive backend coverage without fragmentation
- ✅ **Type-Driven Development**: Clear `task`/`feature`/`bug` classification enhances project tracking
- ✅ **Backend-Optimized**: Every issue directly contributes to backend development goals
- ✅ **Enterprise-Ready**: Each issue delivers production-grade functionality
- ✅ **Postman Native**: API testing integrated into every development phase
- ✅ **Scalable Management**: Reduced complexity with maximum development impact

---

## Postman Collections Structure for Dense Backend Development

### Collection 1: Authentication & Security Backend (30 endpoints)
- **Issue Coverage**: #003, #016, #030
- **Clerk Integration**: Complete authentication flows with advanced RBAC
- **Security Testing**: Input validation, rate limiting, and security headers
- **Session Management**: JWT validation, refresh tokens, and session control

### Collection 2: Database & Core Backend APIs (35 endpoints)  
- **Issue Coverage**: #002, #004, #027
- **Prisma ORM**: Complete CRUD operations for all entities
- **Database Performance**: Query optimization and connection pooling
- **Health Monitoring**: Database connectivity and performance metrics

### Collection 3: IoT & Device Management Backend (40 endpoints)
- **Issue Coverage**: #006, #007, #008
- **Device Registration**: Secure device onboarding with certificates
- **MQTT Integration**: Real-time message processing and routing
- **Data Processing**: Sensor data ingestion and analytics

### Collection 4: Real-time Communication Backend (25 endpoints)
- **Issue Coverage**: #009, #010, #026
- **WebSocket Gateway**: Enterprise-grade real-time communication
- **Live Broadcasting**: Real-time data streaming and subscriptions  
- **Monitoring**: Connection monitoring and performance optimization

### Collection 5: E-commerce & Business Logic (30 endpoints)
- **Issue Coverage**: #011, #012, #013, #014, #015
- **Product Management**: Advanced catalog with inventory tracking
- **Order Processing**: Complete order lifecycle management
- **Payment Integration**: Multi-gateway payment processing
- **Admin Functions**: Comprehensive administrative APIs

### Collection 6: Production & Performance (20 endpoints)
- **Issue Coverage**: #017, #018, #019, #020, #036, #037
- **Performance APIs**: Caching, optimization, and load testing endpoints
- **Deployment**: Health checks, monitoring, and production deployment
- **Analytics**: Business intelligence and system performance metrics

---

## Dense Backend Development Benefits

### **Strategic Advantages**
1. **🎯 Higher Impact Per Issue**: Each issue delivers complete backend subsystems
2. **⚡ Faster Development**: Consolidated scope reduces context switching
3. **🏗️ Better Architecture**: Holistic approach ensures system coherence  
4. **📊 Cleaner Project Management**: 40 meaningful milestones vs 60 micro-tasks
5. **🚀 Production Focus**: Every issue moves toward production-ready backend

### **Technical Excellence**
- **Enterprise Patterns**: Each major issue implements enterprise-grade solutions
- **Performance-First**: Built-in performance optimization and monitoring
- **Security-Embedded**: Security considerations integrated into every component
- **Scalability-Ready**: Architecture designed for horizontal and vertical scaling
- **Maintainability**: Clean code patterns and comprehensive documentation

### **Backend Development Focus Distribution**
| Category | Issues | Focus Area | Backend Impact |
|---|---|---|---|
| **Core Infrastructure** | #001-005 | Foundation | NestJS + Database + Auth |
| **IoT & Real-time** | #006-010 | Communication | MQTT + WebSocket + Analytics |
| **E-commerce Logic** | #011-015 | Business | Orders + Payments + Admin |
| **Production Systems** | #016-020 | Deployment | Security + Performance |
| **Advanced Features** | #021-040 | Enterprise | ML + Analytics + Scaling |

This dense structure ensures each GitHub issue represents substantial backend development work while maintaining clear project management and comprehensive API coverage through Postman collections.

#### Week 2 Day 1 - Monday, October 13, 2025 (Issues #021-024)
**Milestone**: IoT Device Management | **Focus**: Device Registration & Monitoring

**`#021`**: **Implement secure device registration and authentication**
- **Issue Type**: `feature`
- **Device APIs**: Secure device onboarding, certificate management
- **Postman Device Collection**: Device registration flows and security testing
- **API Endpoints**: Device registration, authentication, certificate management
- **Labels**: `type: feature`, `component: mqtt`, `priority: P0 - Critical`, `size: L`

**`#022`**: **Create device status monitoring and health tracking**
- **Issue Type**: `feature`
- **Monitoring APIs**: Real-time device status, health metrics, diagnostics
- **Postman Monitoring**: Device health checking and status validation
- **API Endpoints**: Device status, health checks, diagnostic reports
- **Labels**: `type: feature`, `component: mqtt`, `priority: P1 - High`, `size: M`

**`#023`**: **Set up device configuration and firmware management**
- **Issue Type**: `feature`
- **Configuration APIs**: Device settings, firmware updates, remote configuration
- **Postman Config Collection**: Device configuration and update testing
- **API Endpoints**: Configuration management, firmware updates, device settings
- **Labels**: `type: feature`, `component: mqtt`, `priority: P1 - High`, `size: L`

**`#024`**: **Implement device fleet management and analytics**
- **Issue Type**: `feature`
- **Fleet APIs**: Multi-device management, fleet analytics, bulk operations
- **Postman Fleet Collection**: Fleet management and analytics testing
- **API Endpoints**: Fleet overview, bulk operations, analytics dashboards
- **Labels**: `type: feature`, `component: mqtt`, `priority: P2 - Medium`, `size: M`

#### Week 2 Day 2 - Tuesday, October 14, 2025 (Issues #025-028)
**Milestone**: MQTT Integration | **Focus**: IoT Communication Layer

**`#025`**: **Configure MQTT broker and connection management**
- **Issue Type**: `task`
- **MQTT APIs**: Broker configuration, connection management, topic routing
- **Postman MQTT Collection**: MQTT connection testing and message validation
- **API Integration**: MQTT message handling, connection monitoring
- **Labels**: `type: infrastructure`, `component: mqtt`, `priority: P0 - Critical`, `size: L`

**`#026`**: **Implement MQTT message handling and routing**
- **Issue Type**: `feature`
- **Message APIs**: MQTT message processing, routing, and transformation
- **Postman Message Testing**: Message flow validation and routing tests
- **API Endpoints**: Message handling, routing configuration, message logs
- **Labels**: `type: feature`, `component: mqtt`, `priority: P1 - High`, `size: M`

**`#027`**: **Create device command dispatch system**
- **Issue Type**: `feature`
- **Command APIs**: Remote device control, command queuing, execution tracking
- **Postman Command Collection**: Device command testing and validation
- **API Endpoints**: Command dispatch, execution status, command history
- **Labels**: `type: feature`, `component: mqtt`, `priority: P1 - High`, `size: L`

**`#028`**: **Set up real-time MQTT monitoring and diagnostics**
- **Issue Type**: `feature`
- **MQTT Monitoring**: Connection diagnostics, message analytics, performance metrics
- **Postman Diagnostics**: MQTT health testing and performance validation
- **API Endpoints**: MQTT metrics, connection diagnostics, message analytics
- **Labels**: `type: feature`, `component: mqtt`, `priority: P2 - Medium`, `size: M`

#### Week 2 Day 3 - Wednesday, October 15, 2025 (Issues #029-032)
**Milestone**: Sensor Data Management | **Focus**: Data Collection & Processing

**`#029`**: **Implement sensor data ingestion and validation**
- **Issue Type**: `feature`
- **Data APIs**: Sensor data collection, validation, and storage
- **Postman Sensor Collection**: Data ingestion testing and validation scenarios
- **API Endpoints**: Data ingestion, validation, batch processing
- **Labels**: `type: feature`, `component: api`, `priority: P1 - High`, `size: L`

**`#030`**: **Create real-time data streaming with WebSocket**
- **Issue Type**: `feature`
- **Streaming APIs**: Real-time data feeds, WebSocket connections
- **Postman WebSocket Testing**: Real-time data validation and streaming tests
- **API Features**: Live data streams, subscription management, real-time updates
- **Labels**: `type: feature`, `component: api`, `priority: P1 - High`, `size: M`

**`#031`**: **Set up data aggregation and analytics processing**
- **Issue Type**: `feature`
- **Analytics APIs**: Data aggregation, statistical analysis, trend detection
- **Postman Analytics Collection**: Analytics testing and data validation
- **API Endpoints**: Data aggregation, analytics queries, trend analysis
- **Labels**: `type: feature`, `component: api`, `priority: P2 - Medium`, `size: L`

**`#032`**: **Implement data retention policies and archiving**
- **Issue Type**: `task`
- **Data Management APIs**: Data lifecycle, archiving, and cleanup policies
- **Postman Data Management**: Data retention testing and policy validation
- **API Endpoints**: Data retention, archiving, cleanup operations
- **Labels**: `type: infrastructure`, `component: database`, `priority: P3 - Low`, `size: M`

#### Week 2 Day 4 - Thursday, October 16, 2025 (Issues #033-036)
**Milestone**: Alert & Notification System | **Focus**: Real-time Alerts

**`#033`**: **Create alert configuration and threshold management**
- **Issue Type**: `feature`
- **Alert APIs**: Alert rules, thresholds, configuration management
- **Postman Alert Collection**: Alert configuration and threshold testing
- **API Endpoints**: Alert configuration, threshold management, rule engine
- **Labels**: `type: feature`, `component: api`, `priority: P1 - High`, `size: M`

**`#034`**: **Implement notification delivery system**
- **Issue Type**: `feature`
- **Notification APIs**: Multi-channel notification delivery (email, SMS, push)
- **Postman Notification Testing**: Delivery validation and channel testing
- **API Endpoints**: Notification dispatch, delivery status, channel management
- **Labels**: `type: feature`, `component: api`, `priority: P2 - Medium`, `size: L`

**`#035`**: **Set up alert history and acknowledgment system**
- **Issue Type**: `feature`
- **Alert Management APIs**: Alert tracking, acknowledgment, resolution
- **Postman Alert Management**: Alert lifecycle testing and management
- **API Endpoints**: Alert history, acknowledgment, resolution tracking
- **Labels**: `type: feature`, `component: api`, `priority: P2 - Medium`, `size: M`

**`#036`**: **Create alert escalation and routing rules**
- **Issue Type**: `feature`
- **Escalation APIs**: Alert escalation rules, routing logic, priority management
- **Postman Escalation Testing**: Escalation flow validation and rule testing
- **API Endpoints**: Escalation rules, routing configuration, priority management
- **Labels**: `type: feature`, `component: api`, `priority: P3 - Low`, `size: M`

#### Week 2 Day 5 - Friday, October 17, 2025 (Issues #037-040)
**Milestone**: WebSocket & Real-time Features | **Focus**: Live Communication

**`#037`**: **Implement WebSocket gateway and authentication**
- **Issue Type**: `feature`
- **WebSocket APIs**: Real-time connection management, authentication
- **Postman WebSocket Collection**: Connection testing and authentication validation
- **API Features**: WebSocket authentication, connection management, security
- **Labels**: `type: feature`, `component: api`, `priority: P1 - High`, `size: L`

**`#038`**: **Create real-time data broadcasting system**
- **Issue Type**: `feature`
- **Broadcasting APIs**: Real-time data distribution, subscription management
- **Postman Real-time Testing**: Data broadcasting and subscription validation
- **API Features**: Data broadcasting, subscription management, real-time updates
- **Labels**: `type: feature`, `component: api`, `priority: P1 - High`, `size: M`

**`#039`**: **Set up live notifications and updates**
- **Issue Type**: `feature`
- **Live Update APIs**: Real-time notifications, live alerts, instant messaging
- **Postman Live Testing**: Real-time notification and update validation
- **API Features**: Live notifications, instant updates, real-time messaging
- **Labels**: `type: feature`, `component: api`, `priority: P2 - Medium`, `size: M`

**`#040`**: **Implement WebSocket connection monitoring**
- **Issue Type**: `feature`
- **Connection Monitoring**: WebSocket health, performance metrics, diagnostics
- **Postman Connection Testing**: WebSocket monitoring and performance validation
- **API Endpoints**: Connection metrics, performance monitoring, diagnostics
- **Labels**: `type: feature`, `component: api`, `priority: P3 - Low`, `size: S`

### Phase 3: E-commerce & Advanced Features (Issues #041-050)
**October 20-24, 2025 | E-commerce Integration Week**

#### Week 3 Day 1 - Monday, October 20, 2025 (Issues #041-042)
**Milestone**: E-commerce Foundation | **Focus**: Products & Inventory

**`#041`**: **Implement product management and catalog system**
- **Issue Type**: `feature`
- **Product APIs**: Complete product CRUD, catalog management, search
- **Postman Product Collection**: Product testing and catalog validation
- **API Endpoints**: Product CRUD, catalog search, inventory management
- **Labels**: `type: feature`, `component: api`, `priority: P2 - Medium`, `size: L`

**`#042`**: **Create inventory tracking and management**
- **Issue Type**: `feature`
- **Inventory APIs**: Stock management, tracking, automated reordering
- **Postman Inventory Collection**: Inventory testing and stock validation
- **API Endpoints**: Inventory tracking, stock alerts, reorder management
- **Labels**: `type: feature`, `component: api`, `priority: P2 - Medium`, `size: M`

#### Week 3 Day 2 - Tuesday, October 21, 2025 (Issues #043-044)
**Milestone**: Order Management | **Focus**: E-commerce Operations

**`#043`**: **Set up order management and processing system**
- **Issue Type**: `feature`
- **Order APIs**: Complete order lifecycle, processing, fulfillment
- **Postman Order Collection**: Order testing and lifecycle validation
- **API Endpoints**: Order CRUD, processing, status tracking, fulfillment
- **Labels**: `type: feature`, `component: api`, `priority: P2 - Medium`, `size: L`

**`#044`**: **Implement payment integration and processing**
- **Issue Type**: `feature`
- **Payment APIs**: Payment gateway integration, transaction processing
- **Postman Payment Collection**: Payment testing and transaction validation
- **API Endpoints**: Payment processing, transaction management, refunds
- **Labels**: `type: feature`, `component: api`, `priority: P1 - High`, `size: L`

#### Week 3 Day 3 - Wednesday, October 22, 2025 (Issues #045-046)
**Milestone**: File & Media Management | **Focus**: Content Handling

**`#045`**: **Create file upload and media management system**
- **Issue Type**: `feature`
- **File APIs**: File upload, media processing, storage management
- **Postman File Collection**: File upload testing and media validation
- **API Endpoints**: File upload, media processing, storage management
- **Labels**: `type: feature`, `component: api`, `priority: P2 - Medium`, `size: M`

**`#046`**: **Implement CDN integration and optimization**
- **Issue Type**: `task`
- **CDN APIs**: Content delivery, caching, performance optimization
- **Postman CDN Collection**: CDN testing and performance validation
- **API Features**: CDN integration, caching strategies, performance optimization
- **Labels**: `type: infrastructure`, `component: api`, `priority: P3 - Low`, `size: M`

#### Week 3 Day 4 - Thursday, October 23, 2025 (Issues #047-048)
**Milestone**: Admin & CMS | **Focus**: Administrative Features

**`#047`**: **Create admin dashboard APIs and management**
- **Issue Type**: `feature`
- **Admin APIs**: Administrative functions, system management, user administration
- **Postman Admin Collection**: Admin testing and management validation
- **API Endpoints**: Admin dashboard, system management, user administration
- **Labels**: `type: feature`, `component: api`, `priority: P2 - Medium`, `size: L`

**`#048`**: **Implement content management system**
- **Issue Type**: `feature`
- **CMS APIs**: Content creation, management, publishing workflows
- **Postman CMS Collection**: Content testing and management validation
- **API Endpoints**: Content CRUD, publishing, workflow management
- **Labels**: `type: feature`, `component: api`, `priority: P3 - Low`, `size: M`

#### Week 3 Day 5 - Friday, October 24, 2025 (Issues #049-050)
**Milestone**: Analytics & Reporting | **Focus**: Business Intelligence

**`#049`**: **Set up analytics and reporting system**
- **Issue Type**: `feature`
- **Analytics APIs**: Data analytics, reporting, business intelligence
- **Postman Analytics Collection**: Analytics testing and report validation
- **API Endpoints**: Analytics queries, report generation, data visualization
- **Labels**: `type: feature`, `component: api`, `priority: P2 - Medium`, `size: L`

**`#050`**: **Create system monitoring and metrics**
- **Issue Type**: `feature`
- **Monitoring APIs**: System health, performance metrics, operational insights
- **Postman Monitoring Collection**: System monitoring and metrics validation
- **API Endpoints**: System metrics, health monitoring, performance analytics
- **Labels**: `type: feature`, `component: api`, `priority: P2 - Medium`, `size: M`

### Phase 4: Production & Optimization (Issues #051-060)
**October 27-31, 2025 | Production Readiness Week**

#### Week 4 Day 1 - Monday, October 27, 2025 (Issues #051-052)
**Milestone**: Security & Validation | **Focus**: Production Security

**`#051`**: **Implement comprehensive input validation and sanitization**
- **Issue Type**: `feature`
- **Security APIs**: Input validation, data sanitization, security headers
- **Postman Security Collection**: Security testing and validation scenarios
- **API Security**: Comprehensive validation across all endpoints
- **Labels**: `type: security`, `component: api`, `priority: P1 - High`, `size: M`

**`#052`**: **Set up rate limiting and API security measures**
- **Issue Type**: `feature`
- **Rate Limiting APIs**: API throttling, abuse prevention, security monitoring
- **Postman Rate Limiting**: Rate limiting testing and security validation
- **API Protection**: Rate limiting, DDoS protection, abuse prevention
- **Labels**: `type: security`, `component: api`, `priority: P1 - High`, `size: M`

#### Week 4 Day 2 - Tuesday, October 28, 2025 (Issues #053-054)
**Milestone**: Performance & Optimization | **Focus**: Production Performance

**`#053`**: **Optimize database queries and API performance**
- **Issue Type**: `task`
- **Performance APIs**: Query optimization, caching, performance monitoring
- **Postman Performance Collection**: Performance testing and optimization validation
- **API Optimization**: Database optimization, query performance, caching strategies
- **Labels**: `type: performance`, `component: database`, `priority: P1 - High`, `size: L`

**`#054`**: **Implement caching strategies with Redis**
- **Issue Type**: `feature`
- **Caching APIs**: Redis integration, cache management, performance optimization
- **Postman Caching Collection**: Cache testing and performance validation
- **API Caching**: Redis caching, cache invalidation, performance improvement
- **Labels**: `type: performance`, `component: api`, `priority: P2 - Medium`, `size: M`

#### Week 4 Day 3 - Wednesday, October 29, 2025 (Issues #055-056)
**Milestone**: Testing & Documentation | **Focus**: Quality Assurance

**`#055`**: **Create comprehensive API testing suite**
- **Issue Type**: `task`
- **Testing APIs**: Automated testing, integration tests, API validation
- **Postman Testing Suite**: Complete API testing automation and validation
- **API Testing**: Unit tests, integration tests, end-to-end validation
- **Labels**: `type: test`, `component: api`, `priority: P1 - High`, `size: L`

**`#056`**: **Generate complete API documentation**
- **Issue Type**: `task`
- **Documentation APIs**: OpenAPI documentation, interactive API docs
- **Postman Documentation**: Complete API documentation and examples
- **API Docs**: Swagger documentation, API examples, developer guides
- **Labels**: `type: docs`, `component: api`, `priority: P2 - Medium`, `size: M`

#### Week 4 Day 4 - Thursday, October 30, 2025 (Issues #057-058)
**Milestone**: Deployment & Infrastructure | **Focus**: Production Deployment

**`#057`**: **Set up Docker containerization and orchestration**
- **Issue Type**: `task`
- **Container APIs**: Dockerized deployment, container orchestration
- **Postman Container Testing**: Containerized API testing and validation
- **Infrastructure**: Docker containers, orchestration, deployment automation
- **Labels**: `type: infrastructure`, `component: api`, `priority: P1 - High`, `size: L`

**`#058`**: **Configure production deployment pipeline**
- **Issue Type**: `task`
- **Deployment APIs**: CI/CD pipeline, production deployment, automation
- **Postman Production Testing**: Production API testing and validation
- **Production Setup**: Deployment pipeline, production configuration, monitoring
- **Labels**: `type: infrastructure`, `component: api`, `priority: P1 - High`, `size: M`

#### Week 4 Day 5 - Friday, October 31, 2025 (Issues #059-060)
**Milestone**: Production Launch | **Focus**: Final Testing & Launch

**`#059`**: **Conduct final integration testing and security audit**
- **Issue Type**: `task`
- **Final Testing**: Complete system testing, security audit, performance validation
- **Postman Final Testing**: Comprehensive API testing and security validation
- **Quality Assurance**: Final testing, security audit, performance verification
- **Labels**: `type: test`, `priority: P0 - Critical`, `size: L`

**`#060`**: **Deploy to production and create handover documentation**
- **Issue Type**: `task`
- **Production Deployment**: Live deployment, monitoring setup, documentation
- **Postman Production**: Production API validation and monitoring setup
- **Project Completion**: Production deployment, documentation, project handover
- **Labels**: `type: infrastructure`, `priority: P0 - Critical`, `size: M`

---

## Postman Collections Structure Summary

### Collection 1: Authentication & Security (25 endpoints)
- User authentication flows with Clerk integration
- Role-based access control and permissions
- Session management and JWT validation
- Security testing and validation scenarios

### Collection 2: Database & Core APIs (20 endpoints)  
- Database health and connectivity monitoring
- CRUD operations for all major entities
- Data validation and schema testing
- Development tools and database management

### Collection 3: IoT Device Management (25 endpoints)
- Device registration and authentication
- Device monitoring and health tracking
- Configuration management and firmware updates
- Fleet management and analytics

### Collection 4: MQTT & Real-time Communication (20 endpoints)
- MQTT broker configuration and connection management
- Message handling and routing systems
- Real-time data streaming with WebSocket
- Command dispatch and execution tracking

### Collection 5: Sensor Data & Analytics (15 endpoints)
- Sensor data ingestion and validation
- Real-time data processing and aggregation
- Analytics queries and trend analysis
- Alert configuration and notification systems

### Collection 6: E-commerce & Orders (20 endpoints)
- Product catalog and inventory management
- Order processing and lifecycle management
- Payment integration and transaction processing
- Customer management and order tracking

### Collection 7: Admin & Content Management (10 endpoints)
- Administrative dashboard and system management
- Content management system and publishing
- User administration and system configuration
- File upload and media management

### Collection 8: Monitoring & System Health (10 endpoints)
- System performance monitoring and metrics
- API health checks and diagnostics
- Error tracking and logging systems
- Production monitoring and alerting

**Total: 145 API Endpoints across 8 comprehensive Postman collections**

- `#010`: **Implement authentication middleware and request guards**
  - **API Focus**: Protected API endpoints with role-based access
  - **Postman**: Authorization headers automation
  - **Endpoints**: All protected endpoints with auth validation
  - **Labels**: `type: feature`, `component: auth`, `priority: P0 - Critical`, `size: M`

- `#011`: **Create RBAC system with hierarchical permissions and custom decorators**
  - **API Focus**: Permission-based API access control
  - **Postman**: Role-based testing scenarios
  - **Endpoints**: `GET /auth/permissions`, `POST /auth/roles`
  - **Labels**: `type: feature`, `component: auth`, `priority: P1 - High`, `size: L`

- `#012`: **Set up JWT validation, session management, and security headers**
  - **API Focus**: Session management APIs
  - **Postman**: Token refresh and session validation
  - **Endpoints**: `POST /auth/refresh`, `DELETE /auth/logout`
  - **Labels**: `type: security`, `component: auth`, `priority: P0 - Critical`, `size: M`

##### Day 4 - Thursday, October 9, 2025 (Issues #013-016)
**Daily Goal**: Core API foundation and enterprise patterns
**Duration**: 1 Day | **Start**: 9:00 AM | **End**: 6:00 PM

- `#013`: **Create core module architecture following clean architecture principles**
  - **API Focus**: Standardized API response patterns and error handling
  - **Postman**: Response validation and error handling collection
  - **Endpoints**: Health check, version info, system status APIs
  - **Labels**: `type: refactor`, `component: api`, `priority: P1 - High`, `size: L`

- `#014`: **Implement comprehensive error handling, logging, and monitoring**
  - **API Focus**: Error response standardization across all APIs
  - **Postman**: Error scenario testing collection
  - **Endpoints**: `GET /health`, `GET /metrics`, `GET /logs`
  - **Labels**: `type: feature`, `component: api`, `priority: P1 - High`, `size: M`

- `#015`: **Set up validation pipes, custom decorators, and API versioning**
  - **API Focus**: Input validation for all API endpoints
  - **Postman**: Validation testing with invalid data scenarios
  - **Endpoints**: All endpoints with v1 versioning (`/api/v1/...`)
  - **Labels**: `type: feature`, `component: api`, `priority: P2 - Medium`, `size: M`

- `#016`: **Create abstract base classes and shared utility modules**
  - **API Focus**: Consistent API controller patterns
  - **Postman**: Base templates for all endpoint types
  - **Labels**: `type: refactor`, `component: api`, `priority: P2 - Medium`, `size: S`

##### Day 5 - Friday, October 10, 2025 (Issues #017-020)
**Daily Goal**: User management APIs with comprehensive features
**Duration**: 1 Day | **Start**: 9:00 AM | **End**: 6:00 PM

- `#017`: **Implement advanced user CRUD operations with Clerk synchronization**
  - **API Focus**: Complete user management API suite
  - **Postman**: User management collection with full CRUD operations
  - **Endpoints**: `GET /users`, `POST /users`, `PUT /users/:id`, `DELETE /users/:id`
  - **Labels**: `type: feature`, `component: auth`, `priority: P1 - High`, `size: L`

- `#018`: **Create comprehensive RBAC with hierarchical permissions system**
  - **API Focus**: Role and permission management APIs
  - **Postman**: Permission testing collection
  - **Endpoints**: `GET /roles`, `POST /roles`, `GET /permissions`, `POST /users/:id/roles`
  - **Labels**: `type: feature`, `component: auth`, `priority: P1 - High`, `size: L`

- `#019`: **Set up user activity logging, audit trails, and session management**
  - **API Focus**: User activity and audit APIs
  - **Postman**: Activity tracking and audit collection
  - **Endpoints**: `GET /users/:id/activity`, `GET /audit/logs`, `GET /sessions`
  - **Labels**: `type: feature`, `component: auth`, `component: analytics`, `priority: P2 - Medium`, `size: M`

- `#020`: **Implement user preferences, profile management, and onboarding workflow**
  - **API Focus**: User profile and preference APIs
  - **Postman**: Profile management collection
  - **Endpoints**: `GET /users/:id/profile`, `PUT /users/:id/preferences`, `POST /users/:id/avatar`
  - **Labels**: `type: feature`, `component: auth`, `priority: P2 - Medium`, `size: M`

---

#### Phase 2: IoT Core & Device Management APIs (Issues #021-040)
**Week 2: October 13-17, 2025 (5 Business Days)**
**Focus: IoT Integration, MQTT APIs, Device Management**

##### Day 6 - Monday, October 13, 2025 (Issues #021-024)
**Daily Goal**: Enterprise IoT device management API system
**Duration**: 1 Day | **Start**: 9:00 AM | **End**: 6:00 PM

- `#021`: **Implement secure device registration with certificate-based authentication**
  - **API Focus**: Device registration and authentication APIs
  - **Postman**: Device registration collection with certificate handling
  - **Endpoints**: `POST /devices/register`, `POST /devices/authenticate`, `GET /devices/certificates`
  - **Labels**: `type: feature`, `component: mqtt`, `priority: P1 - High`, `size: L`

- `#022`: **Create real-time device status monitoring and health tracking system**
  - **API Focus**: Device monitoring and health check APIs
  - **Postman**: Device monitoring collection with real-time status
  - **Endpoints**: `GET /devices/:id/status`, `GET /devices/:id/health`, `GET /devices/online`
  - **Labels**: `type: feature`, `component: mqtt`, `component: analytics`, `priority: P1 - High`, `size: M`

- `#023`: **Set up device configuration management and firmware update system**
  - **API Focus**: Device configuration and firmware APIs
  - **Postman**: Device configuration collection
  - **Endpoints**: `GET /devices/:id/config`, `PUT /devices/:id/config`, `POST /devices/:id/firmware`
  - **Labels**: `type: feature`, `component: mqtt`, `priority: P2 - Medium`, `size: L`

- `#024`: **Implement device fleet management, analytics, and predictive maintenance**
  - **API Focus**: Fleet management and analytics APIs
  - **Postman**: Fleet management collection with analytics
  - **Endpoints**: `GET /fleets`, `POST /fleets`, `GET /fleets/:id/devices`, `GET /devices/analytics`
  - **Labels**: `type: feature`, `component: mqtt`, `component: analytics`, `priority: P2 - Medium`, `size: XL`

##### Day 7 - Tuesday, October 14, 2025 (Issues #025-028)
**Daily Goal**: MQTT integration and communication APIs
**Duration**: 1 Day | **Start**: 9:00 AM | **End**: 6:00 PM

- `#025`: **Configure MQTT broker with clustering and high availability**
  - **API Focus**: MQTT broker management APIs
  - **Postman**: MQTT broker monitoring collection
  - **Endpoints**: `GET /mqtt/status`, `GET /mqtt/topics`, `GET /mqtt/clients`
  - **Labels**: `type: infrastructure`, `component: mqtt`, `priority: P1 - High`, `size: L`

- `#026`: **Implement MQTT message handling with topic routing and QoS management**
  - **API Focus**: MQTT message management APIs
  - **Postman**: MQTT message handling collection
  - **Endpoints**: `POST /mqtt/publish`, `GET /mqtt/messages`, `POST /mqtt/subscribe`
  - **Labels**: `type: feature`, `component: mqtt`, `priority: P1 - High`, `size: M`

- `#027`: **Create device command dispatch system with delivery confirmation**
  - **API Focus**: Device command and control APIs
  - **Postman**: Device command collection with confirmation tracking
  - **Endpoints**: `POST /devices/:id/commands`, `GET /commands/:id/status`, `GET /devices/:id/commands`
  - **Labels**: `type: feature`, `component: mqtt`, `priority: P1 - High`, `size: M`

- `#028`: **Set up MQTT security, connection monitoring, and automatic reconnection**
  - **API Focus**: MQTT security and monitoring APIs
  - **Postman**: MQTT security testing collection
  - **Endpoints**: `GET /mqtt/connections`, `POST /mqtt/security/validate`, `GET /mqtt/logs`
  - **Labels**: `type: security`, `component: mqtt`, `priority: P1 - High`, `size: M`

##### Day 8 - Wednesday, October 15, 2025 (Issues #029-032)
**Daily Goal**: Sensor data management and real-time processing APIs
**Duration**: 1 Day | **Start**: 9:00 AM | **End**: 6:00 PM

- `#029`: **Implement sensor data ingestion with validation and real-time processing**
  - **API Focus**: Sensor data collection and processing APIs
  - **Postman**: Sensor data collection with validation scenarios
  - **Endpoints**: `POST /sensors/data`, `GET /sensors/:id/data`, `GET /sensors/data/latest`
  - **Labels**: `type: feature`, `component: mqtt`, `component: database`, `priority: P1 - High`, `size: L`

- `#030`: **Create WebSocket gateway for real-time data streaming to clients**
  - **API Focus**: WebSocket connection management APIs
  - **Postman**: WebSocket testing collection (using WebSocket requests)
  - **Endpoints**: WebSocket endpoints for real-time data streaming
  - **Labels**: `type: feature`, `component: websocket`, `priority: P1 - High`, `size: M`

- `#031`: **Set up data aggregation, analytics, and time-series optimization**
  - **API Focus**: Data analytics and aggregation APIs
  - **Postman**: Analytics collection with time-series data
  - **Endpoints**: `GET /analytics/sensors`, `GET /analytics/aggregated`, `GET /analytics/time-series`
  - **Labels**: `type: feature`, `component: analytics`, `component: database`, `priority: P2 - Medium`, `size: L`

- `#032`: **Implement data retention policies and automated archiving system**
  - **API Focus**: Data management and archiving APIs
  - **Postman**: Data management collection
  - **Endpoints**: `GET /data/retention`, `POST /data/archive`, `GET /data/archived`
  - **Labels**: `type: feature`, `component: database`, `priority: P3 - Low`, `size: M`

##### Day 9 - Thursday, October 16, 2025 (Issues #033-036)
**Daily Goal**: Alert and notification system APIs
**Duration**: 1 Day | **Start**: 9:00 AM | **End**: 6:00 PM

- `#033`: **Create intelligent alert configuration with machine learning thresholds**
  - **API Focus**: Alert configuration and management APIs
  - **Postman**: Alert management collection with ML threshold testing
  - **Endpoints**: `GET /alerts/config`, `POST /alerts/rules`, `PUT /alerts/thresholds`
  - **Labels**: `type: feature`, `component: notification`, `component: analytics`, `priority: P2 - Medium`, `size: L`

- `#034`: **Implement multi-channel notification system (email, SMS, push, WebSocket)**
  - **API Focus**: Notification delivery APIs
  - **Postman**: Notification testing collection for all channels
  - **Endpoints**: `POST /notifications/send`, `GET /notifications/channels`, `POST /notifications/test`
  - **Labels**: `type: feature`, `component: notification`, `priority: P1 - High`, `size: L`

- `#035`: **Set up alert history, escalation workflows, and acknowledgment system**
  - **API Focus**: Alert workflow management APIs
  - **Postman**: Alert workflow collection
  - **Endpoints**: `GET /alerts/history`, `POST /alerts/:id/acknowledge`, `GET /alerts/escalations`
  - **Labels**: `type: feature`, `component: notification`, `priority: P2 - Medium`, `size: M`

- `#036`: **Create alert analytics, reporting, and automated resolution suggestions**
  - **API Focus**: Alert analytics and reporting APIs
  - **Postman**: Alert analytics collection
  - **Endpoints**: `GET /alerts/analytics`, `GET /alerts/reports`, `GET /alerts/suggestions`
  - **Labels**: `type: feature`, `component: notification`, `component: analytics`, `priority: P3 - Low`, `size: M`

##### Day 10 - Friday, October 17, 2025 (Issues #037-040)
**Daily Goal**: E-commerce foundation APIs
**Duration**: 1 Day | **Start**: 9:00 AM | **End**: 6:00 PM

- `#037`: **Implement comprehensive product management with categories and variants**
  - **API Focus**: Product catalog management APIs
  - **Postman**: Product management collection with full CRUD
  - **Endpoints**: `GET /products`, `POST /products`, `GET /categories`, `GET /products/:id/variants`
  - **Labels**: `type: feature`, `component: api`, `priority: P1 - High`, `size: L`

- `#038`: **Create advanced inventory tracking with real-time stock management**
  - **API Focus**: Inventory management APIs
  - **Postman**: Inventory tracking collection
  - **Endpoints**: `GET /inventory`, `PUT /inventory/:id/stock`, `GET /inventory/alerts`
  - **Labels**: `type: feature`, `component: api`, `component: database`, `priority: P1 - High`, `size: M`

- `#039`: **Set up sophisticated order management with workflow automation**
  - **API Focus**: Order processing and management APIs
  - **Postman**: Order management collection with workflow testing
  - **Endpoints**: `POST /orders`, `GET /orders/:id`, `PUT /orders/:id/status`, `GET /orders/workflow`
  - **Labels**: `type: feature`, `component: api`, `priority: P1 - High`, `size: L`

- `#040`: **Implement seller verification, onboarding, and commission management**
  - **API Focus**: Seller management APIs
  - **Postman**: Seller management collection
  - **Endpoints**: `POST /sellers/register`, `GET /sellers/:id/verification`, `GET /sellers/:id/commissions`
  - **Labels**: `type: feature`, `component: auth`, `component: payment`, `priority: P2 - Medium`, `size: M`

---

#### Phase 3: Advanced Features & E-commerce APIs (Issues #041-050)
**Week 3: October 20-24, 2025 (5 Business Days)**
**Focus: Real-time Features, Admin APIs, Payment Integration**

##### Day 11 - Monday, October 20, 2025 (Issues #041-044)
**Daily Goal**: Advanced WebSocket and real-time APIs
**Duration**: 1 Day | **Start**: 9:00 AM | **End**: 6:00 PM

- `#041`: **Implement advanced WebSocket gateway with room management and scaling**
  - **API Focus**: WebSocket room and connection management APIs
  - **Postman**: WebSocket management collection
  - **Endpoints**: WebSocket room APIs, connection management
  - **Labels**: `type: feature`, `component: websocket`, `priority: P1 - High`, `size: L`

- `#042`: **Create real-time sensor data streaming with data compression**
  - **API Focus**: Real-time data streaming APIs with compression
  - **Postman**: Real-time data collection with compression testing
  - **Endpoints**: Streaming endpoints with compression options
  - **Labels**: `type: feature`, `component: websocket`, `component: mqtt`, `priority: P1 - High`, `size: M`

- `#043`: **Set up live device status updates with heartbeat monitoring**
  - **API Focus**: Live device monitoring APIs
  - **Postman**: Live monitoring collection
  - **Endpoints**: Real-time device status and heartbeat APIs
  - **Labels**: `type: feature`, `component: websocket`, `component: mqtt`, `priority: P2 - Medium`, `size: M`

- `#044`: **Implement real-time notifications with delivery confirmation**
  - **API Focus**: Real-time notification APIs
  - **Postman**: Real-time notification collection
  - **Endpoints**: Live notification and delivery confirmation APIs
  - **Labels**: `type: feature`, `component: websocket`, `component: notification`, `priority: P2 - Medium`, `size: M`

##### Day 12 - Tuesday, October 21, 2025 (Issues #045-048)
**Daily Goal**: Admin dashboard and CMS APIs
**Duration**: 1 Day | **Start**: 9:00 AM | **End**: 6:00 PM

- `#045`: **Create comprehensive admin user management with advanced permissions**
  - **API Focus**: Admin user management APIs
  - **Postman**: Admin management collection
  - **Endpoints**: `GET /admin/users`, `POST /admin/users/roles`, `GET /admin/permissions`
  - **Labels**: `type: feature`, `component: auth`, `component: api`, `priority: P2 - Medium`, `size: L`

- `#046`: **Implement system monitoring dashboard with real-time metrics**
  - **API Focus**: System monitoring and metrics APIs
  - **Postman**: System monitoring collection
  - **Endpoints**: `GET /admin/metrics`, `GET /admin/system/health`, `GET /admin/performance`
  - **Labels**: `type: feature`, `component: analytics`, `priority: P2 - Medium`, `size: L`

- `#047`: **Set up platform analytics with business intelligence and reporting**
  - **API Focus**: Business analytics and reporting APIs
  - **Postman**: Analytics and reporting collection
  - **Endpoints**: `GET /analytics/business`, `GET /reports/generate`, `GET /analytics/dashboard`
  - **Labels**: `type: feature`, `component: analytics`, `priority: P3 - Low`, `size: XL`

- `#048`: **Create advanced CMS with workflow approval and version control**
  - **API Focus**: Content management system APIs
  - **Postman**: CMS management collection
  - **Endpoints**: `GET /cms/content`, `POST /cms/content`, `PUT /cms/content/approve`
  - **Labels**: `type: feature`, `component: api`, `priority: P3 - Low`, `size: L`

##### Day 13 - Wednesday, October 22, 2025 (Issues #049-050)
**Daily Goal**: Payment integration and processing APIs
**Duration**: 1 Day | **Start**: 9:00 AM | **End**: 6:00 PM

- `#049`: **Integrate multiple payment gateways (Stripe, PayPal, GCash) with fallback**
  - **API Focus**: Payment gateway integration APIs
  - **Postman**: Payment integration collection for all gateways
  - **Endpoints**: `POST /payments/stripe`, `POST /payments/paypal`, `POST /payments/gcash`
  - **Labels**: `type: feature`, `component: payment`, `priority: P1 - High`, `size: L`

- `#050`: **Implement advanced payment processing with fraud detection**
  - **API Focus**: Payment processing and security APIs
  - **Postman**: Payment security testing collection
  - **Endpoints**: `POST /payments/process`, `GET /payments/:id/status`, `POST /payments/validate`
  - **Labels**: `type: feature`, `component: payment`, `type: security`, `priority: P1 - High`, `size: M`

---
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
