MASH-Mushroom-Automation/MASH-IoT-Device/documents/BACKEND_PLAN.md

# Backend Plan — NestJS + Prisma + PostgreSQL (Neon.tech)

This document is an opinionated, modern, production-ready backend plan (best-in-2025) for building a backend using NestJS, Prisma and PostgreSQL hosted on Neon.tech. It includes tech stack recommendations, architecture, Prisma/Neon specifics (Data Proxy and branches), authentication/security, caching, background jobs, file storage, observability, CI/CD, concrete setup steps (cmd.exe-friendly), a migration strategy, milestones, risks and a starter checklist.

---

## 1. Goal & Assumptions
- Goal: Build a robust, maintainable REST (or GraphQL) backend using NestJS + Prisma + PostgreSQL (Neon.tech).
- Assumptions:
  - Node.js LTS (>=18, prefer 20+) and TypeScript in strict mode.
  - Neon.tech hosts production DB; local dev may use Docker Postgres, SQLite (lightweight single-file DB) or a Neon dev branch depending on workflow.
  - You'll also use Firebase Realtime Database for realtime features (presence, lightweight message bus, or simple notifications) in development and production where appropriate.
  - Prisma for ORM and migrations.
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
