MASH-Mushroom-Automation/MASH-IoT-Device/arduino-uno/Figure_1.png

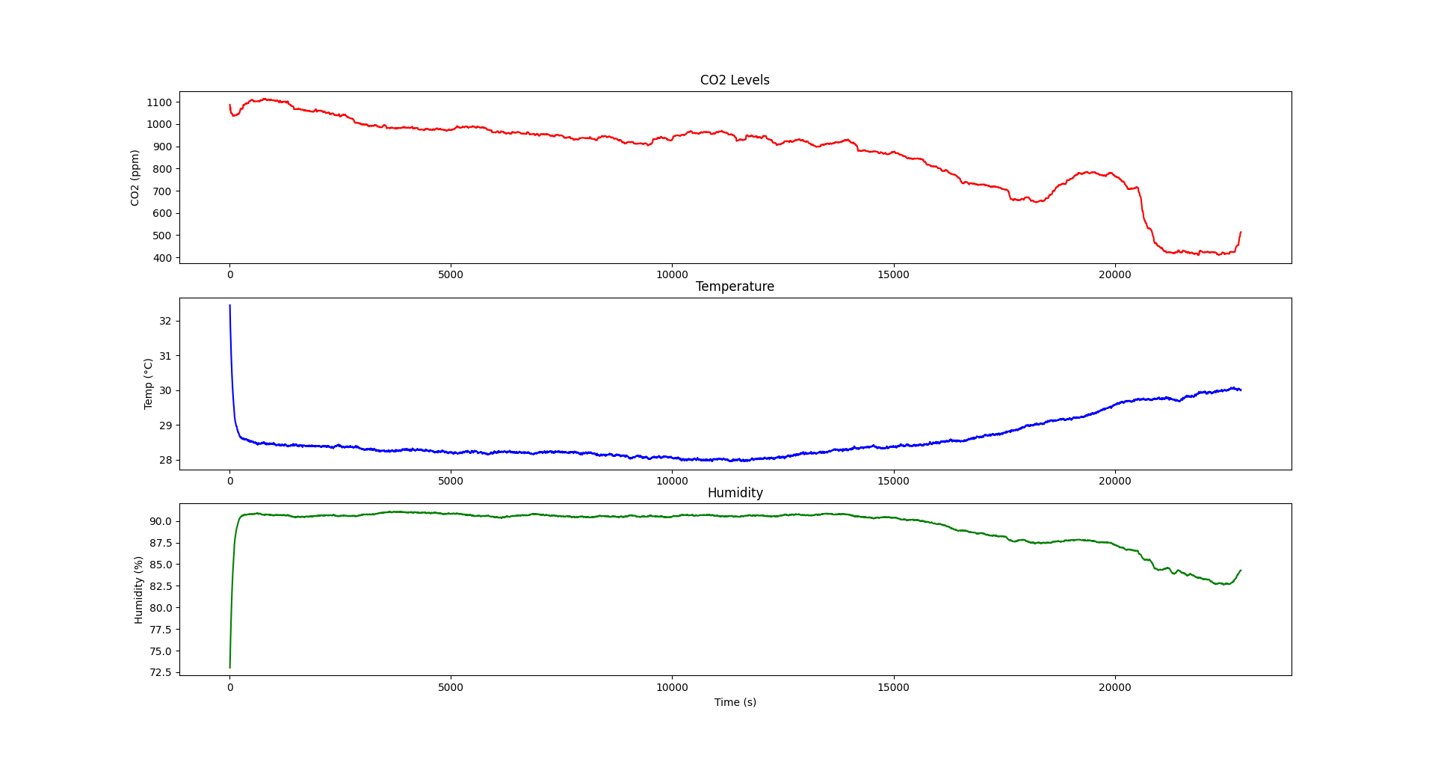
arduino-uno/Figure_1.png
