MASH-Mushroom-Automation/MASH-IoT-Device/arduino-uno/Figure_2.png

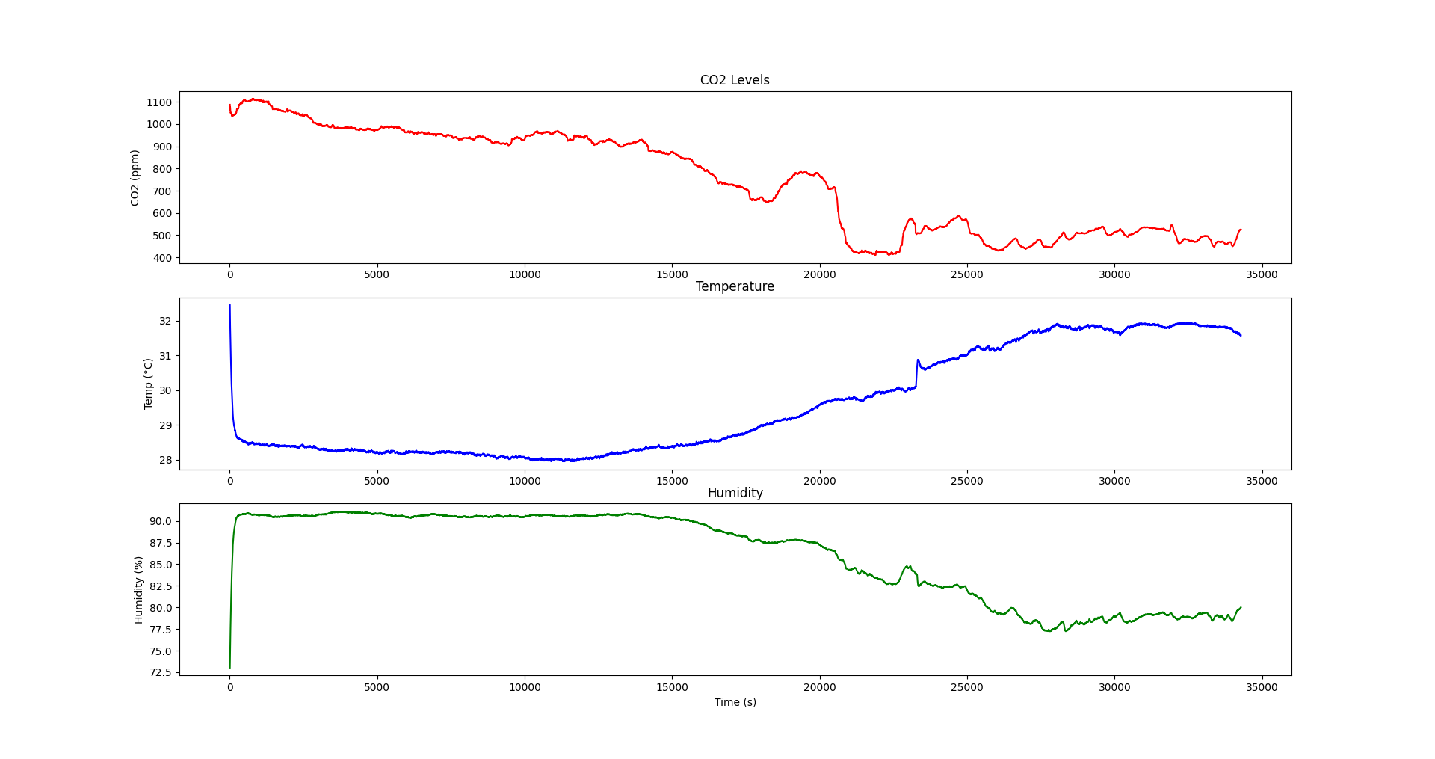
arduino-uno/Figure_2.png
