MASH-Mushroom-Automation/MASH-IoT-Device/arduino-uno/Figure_4.png

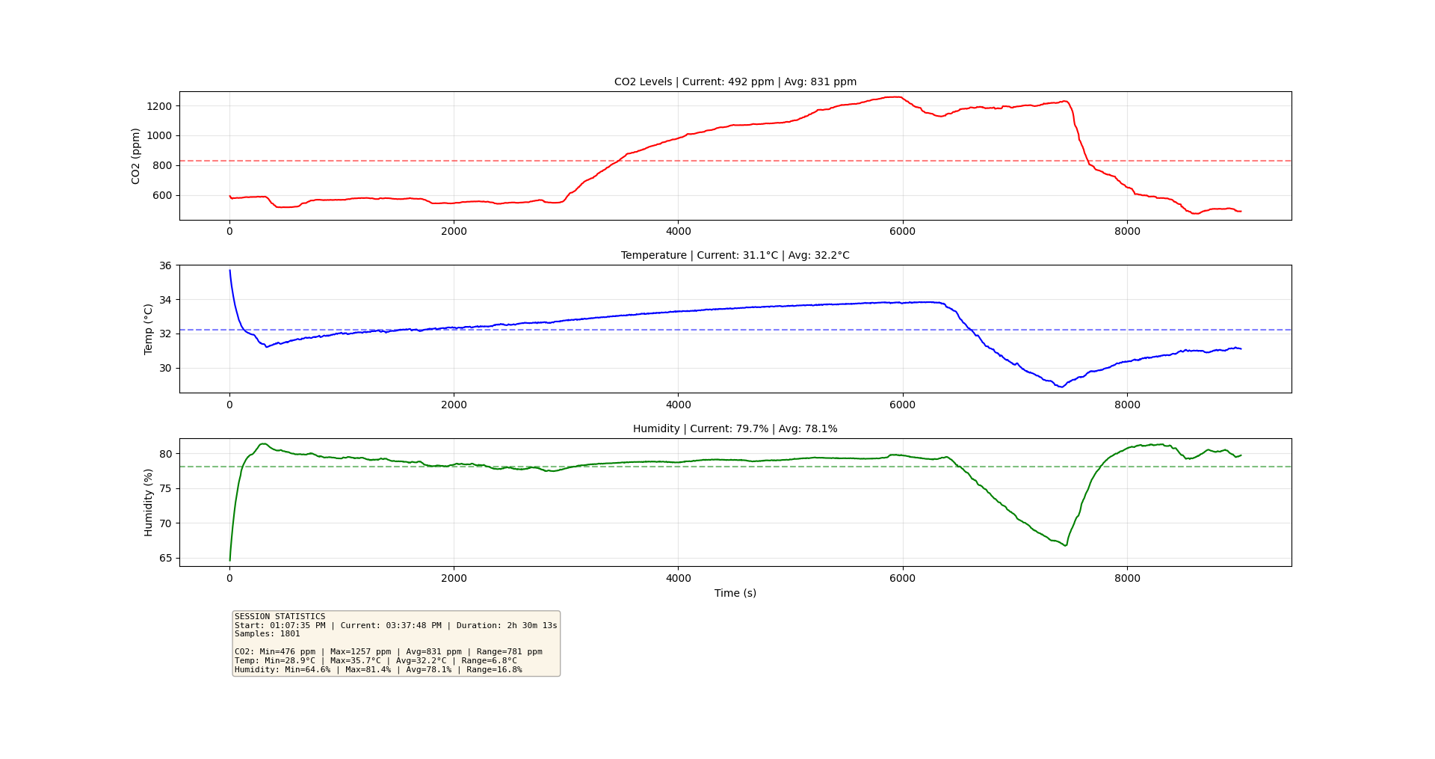
arduino-uno/Figure_4.png
