MASH-Mushroom-Automation/MASH-IoT-Device/arduino-uno/Figure_5.png

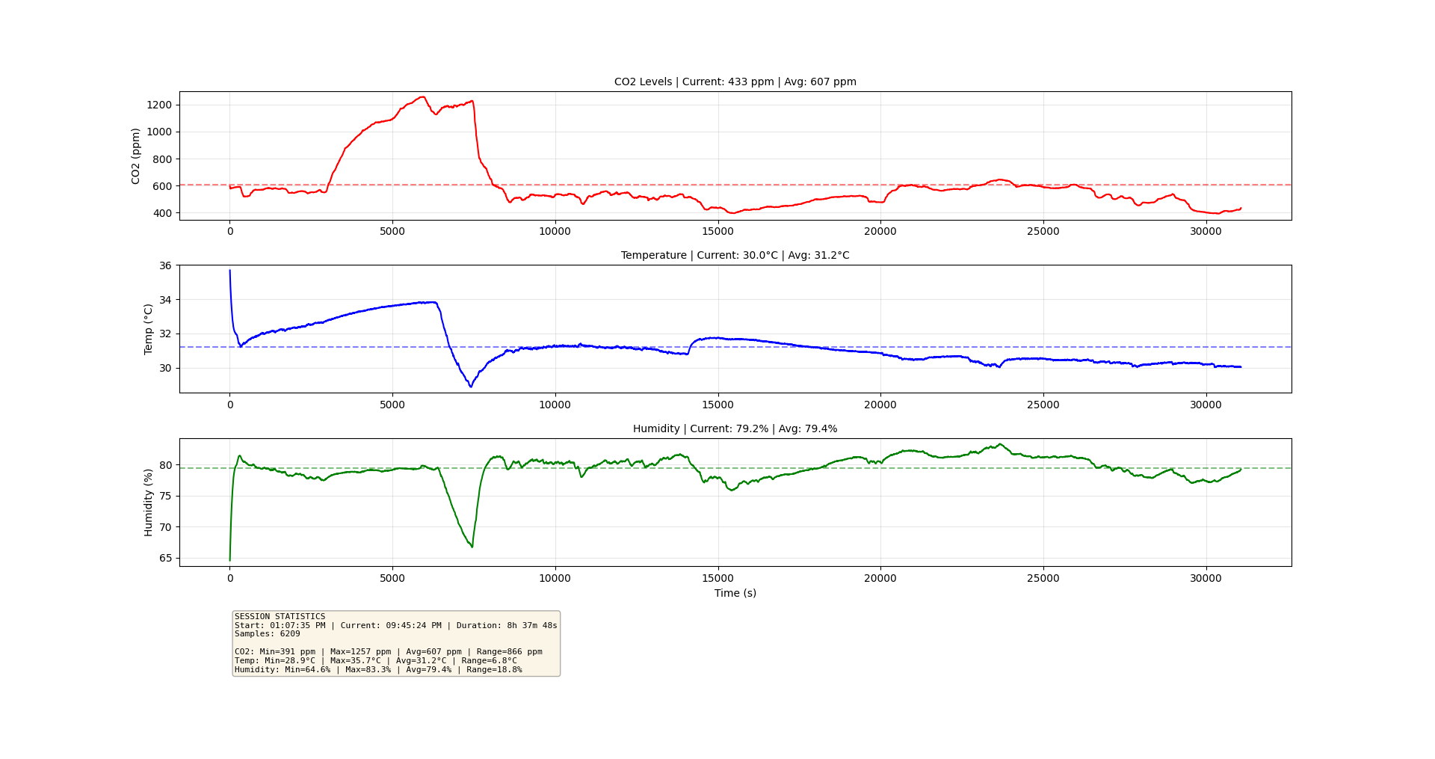
arduino-uno/Figure_5.png
