MASH-Mushroom-Automation/MASH-IoT-Device/arduino-uno/Figure_6.png

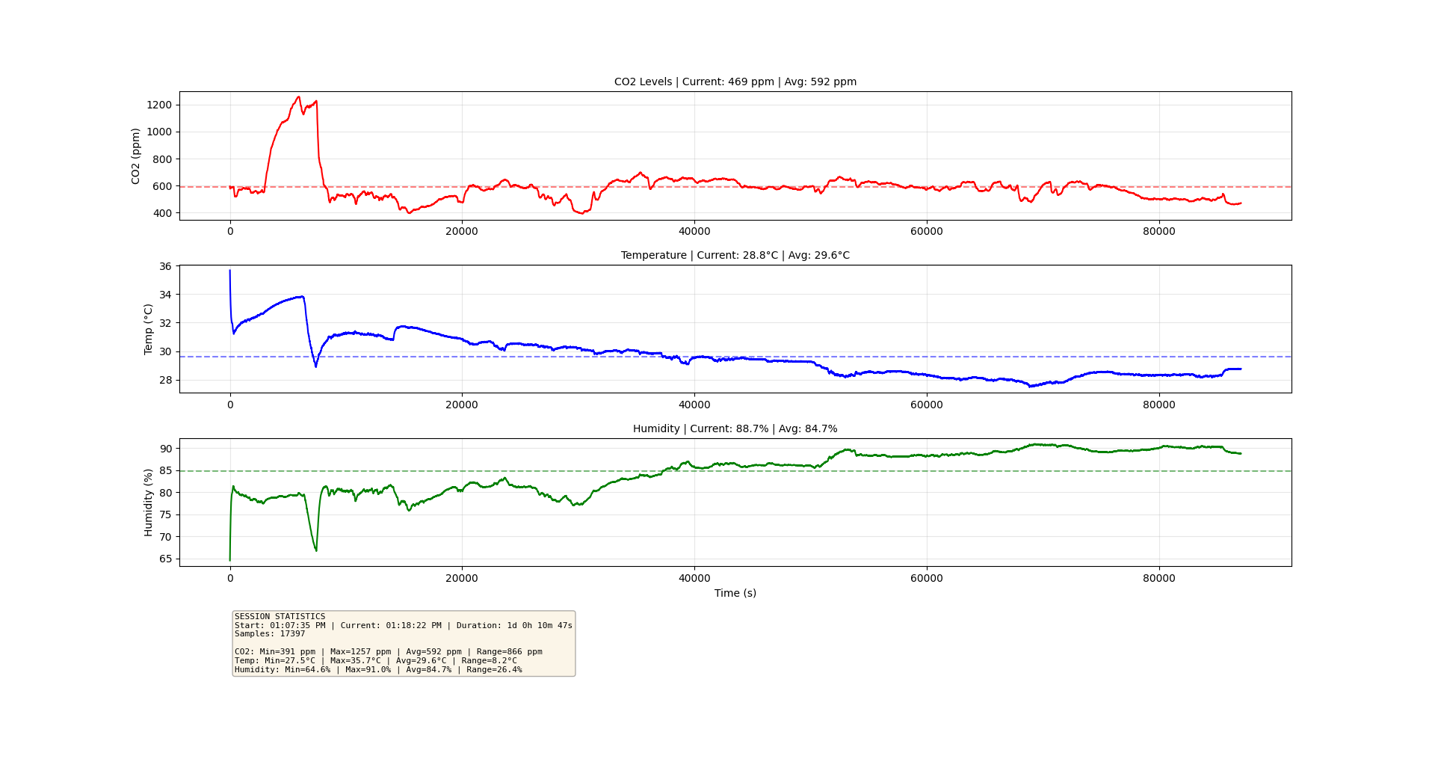
arduino-uno/Figure_6.png
