MASH-Mushroom-Automation/MASH-IoT-Device/assets/figma/wireframe.png

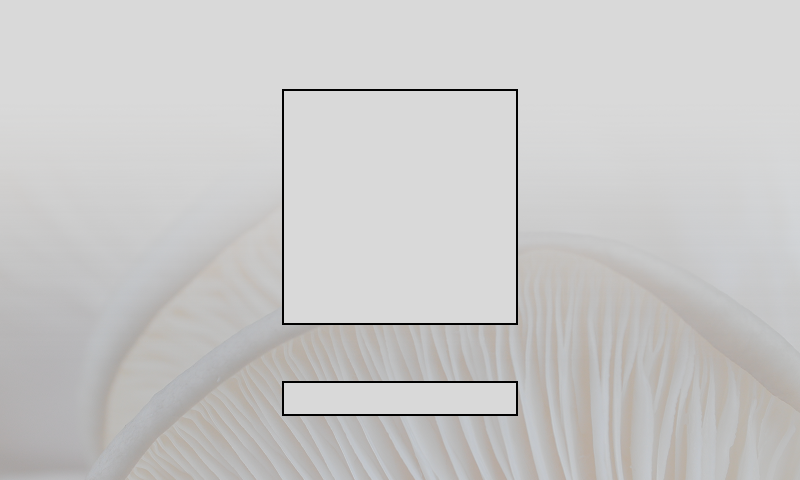
assets/figma/wireframe.png
