MASH-Mushroom-Automation/MASH-IoT-Device/assets/figma/wireframe_1.png

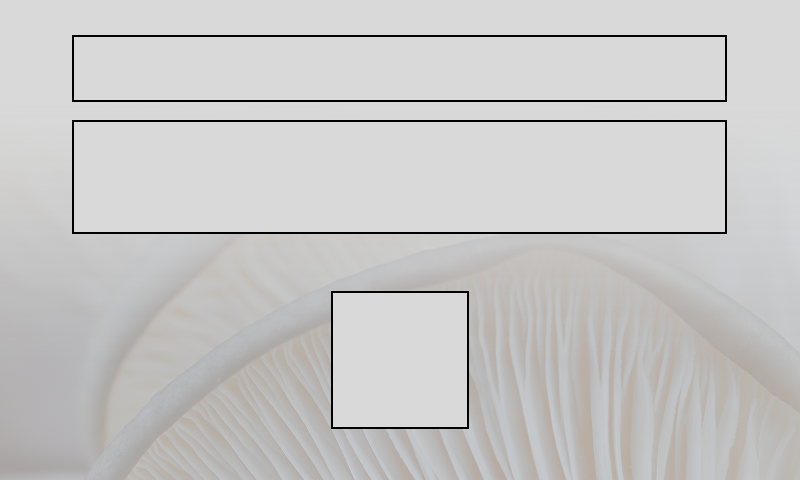
assets/figma/wireframe_1.png
