MASH-Mushroom-Automation/MASH-IoT-Device/assets/figma/wireframe_2.png

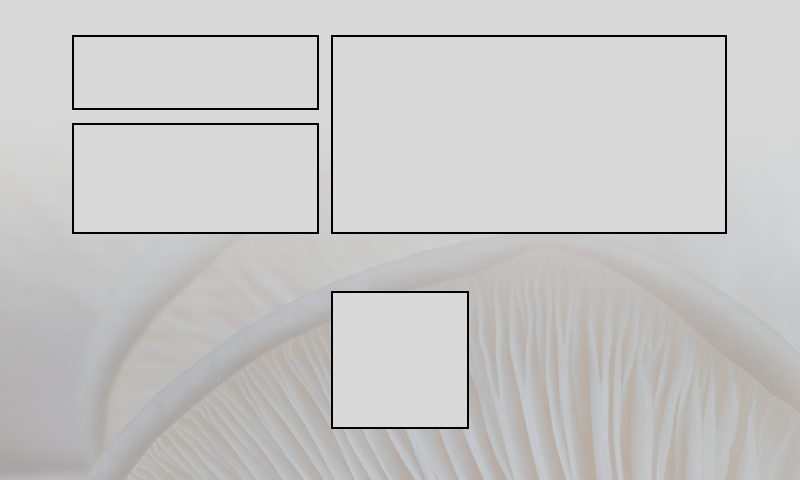
assets/figma/wireframe_2.png
