MASH-Mushroom-Automation/MASH-IoT-Device/assets/figma/wireframe_3.png

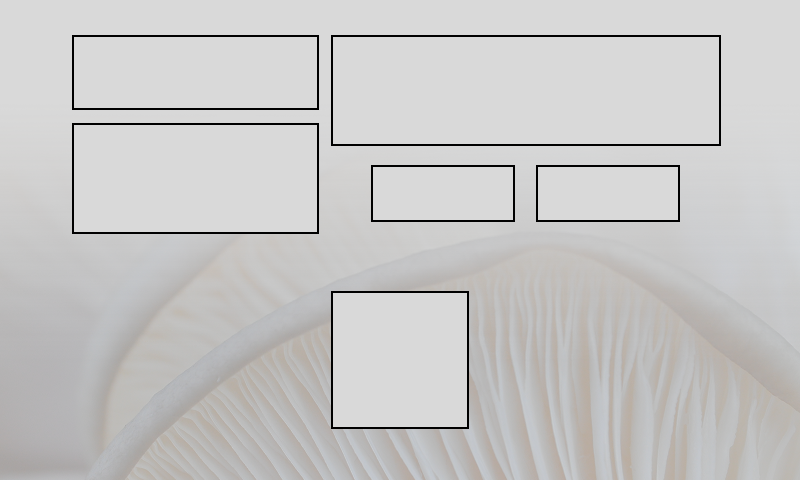
assets/figma/wireframe_3.png
