MASH-Mushroom-Automation/MASH-IoT-Device/assets/figma/wireframe_4.png

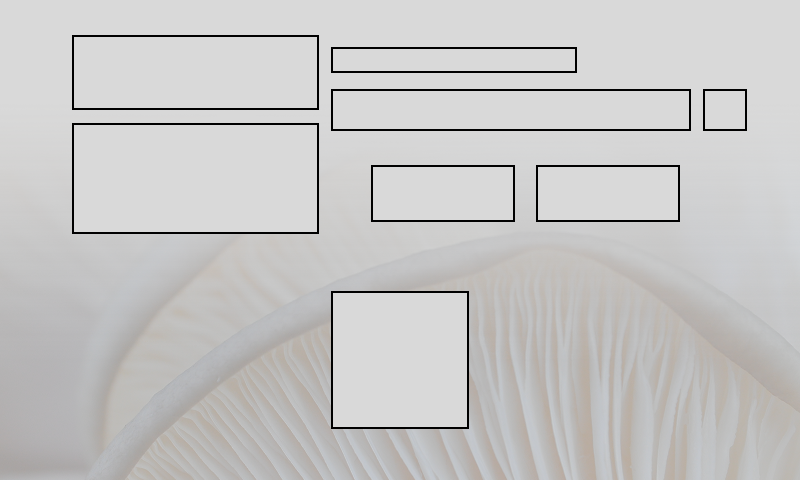
assets/figma/wireframe_4.png
