MASH-Mushroom-Automation/MASH-IoT-Device/assets/figma/wireframe_5.png

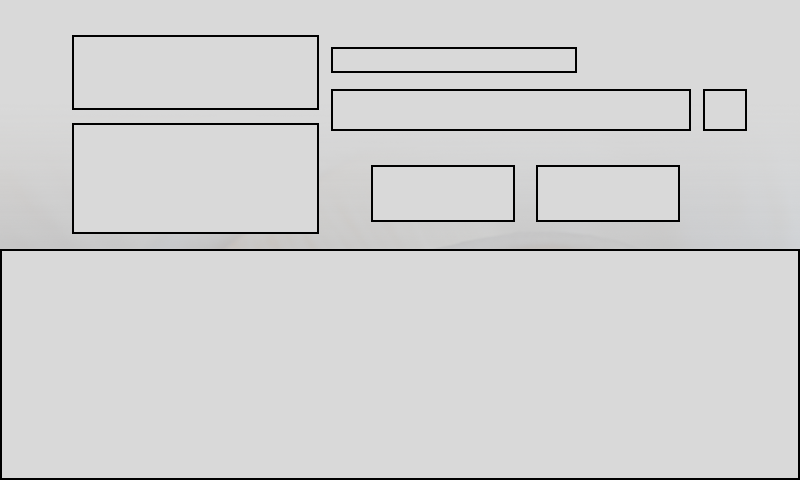
assets/figma/wireframe_5.png
