MASH-Mushroom-Automation/MASH-IoT-Device/assets/figma/wireframe_6.png

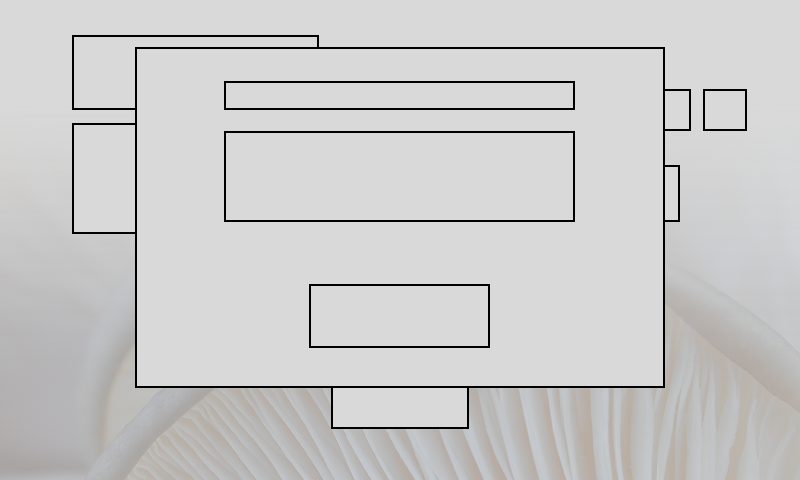
assets/figma/wireframe_6.png
