MASH-Mushroom-Automation/MASH-IoT-Device/assets/figma/wireframe_7.png

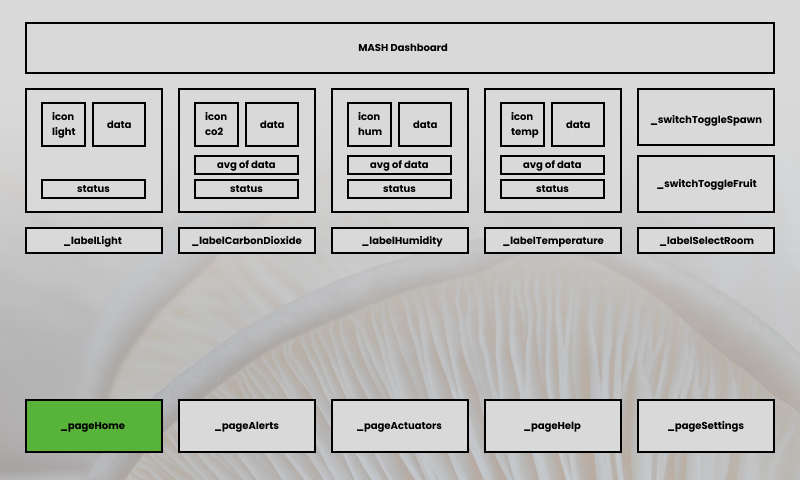
assets/figma/wireframe_7.png
