MASH-Mushroom-Automation/MASH-IoT-Device/assets/figma/wireframe_8.png

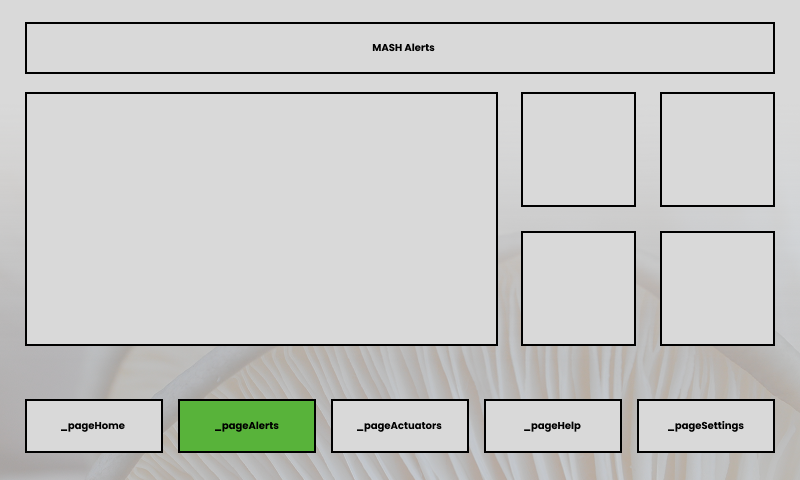
assets/figma/wireframe_8.png
