MASH-Mushroom-Automation/MASH-IoT-Device/assets/figma/wireframe_9-1.png

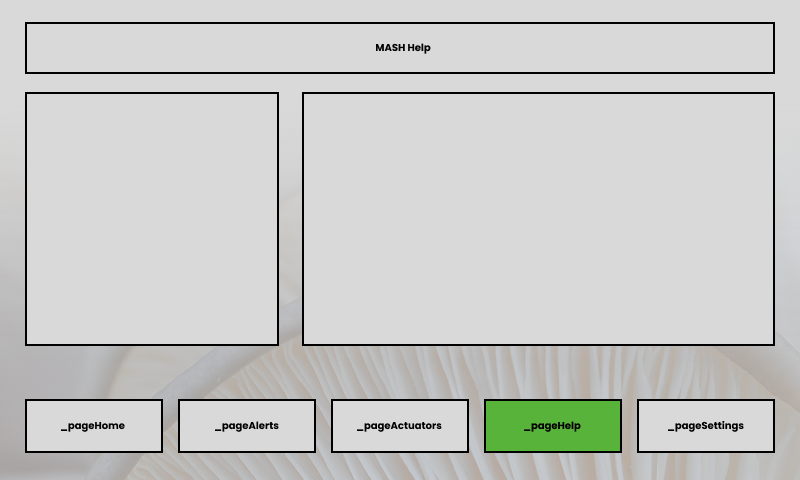
assets/figma/wireframe_9-1.png
