MASH-Mushroom-Automation/MASH-IoT-Device/assets/figma/wireframe_9.png

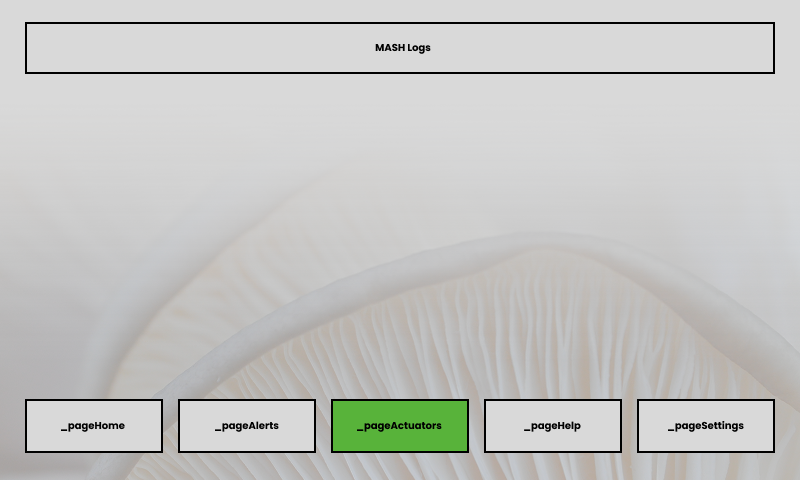
assets/figma/wireframe_9.png
