MASH-Mushroom-Automation/MASH-IoT-Device/assets/figma/wireframe_10-1.png

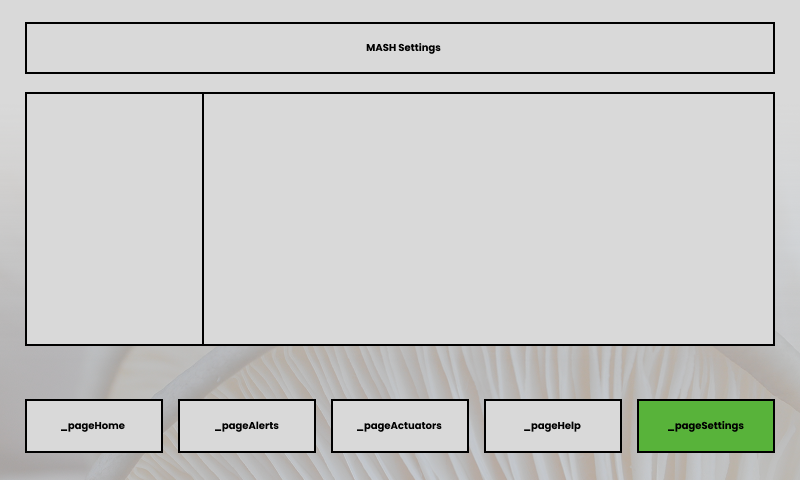
assets/figma/wireframe_10-1.png
