MASH-Mushroom-Automation/MASH-IoT-Device/assets/figma/wireframe_10.png

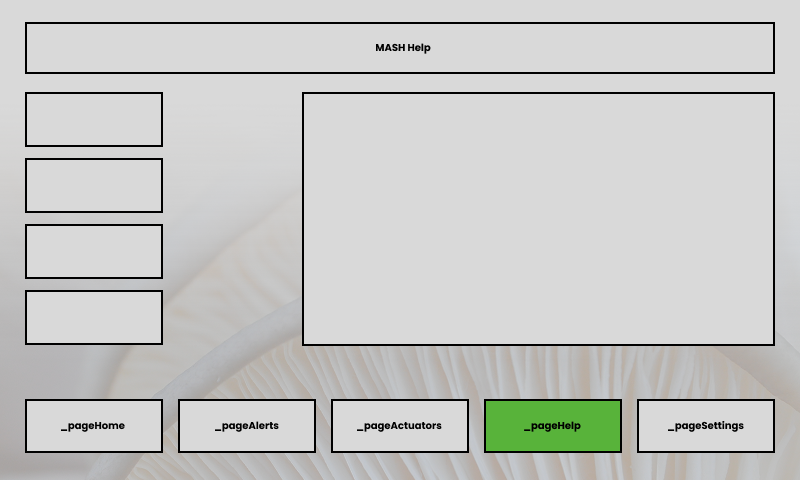
assets/figma/wireframe_10.png
