MASH-Mushroom-Automation/MASH-IoT-Device/documents/Components.md

Manual Override:

Setting up Actuators Control

Breadboard:
 - UGCM1205X
