MASH-Mushroom-Automation/MASH-IoT-Device/touchscreen_ui/DEPLOYMENT_GUIDE.md

# MASH Touchscreen UI - Deployment Guide for Raspberry Pi 3

Complete step-by-step guide to deploy the Kivy touchscreen interface on Raspberry Pi 3 with 7" display.

---

## 📋 Table of Contents

1. [Hardware Requirements](#hardware-requirements)
2. [OS Installation](#os-installation)
3. [System Configuration](#system-configuration)
4. [Software Installation](#software-installation)
5. [Application Setup](#application-setup)
6. [Auto-Boot Configuration](#auto-boot-configuration)
7. [Network Configuration](#network-configuration)
8. [Touchscreen Calibration](#touchscreen-calibration)
9. [Testing & Validation](#testing--validation)
10. [Troubleshooting](#troubleshooting)
11. [Rollback to CLI](#rollback-to-cli)

---

## 🔧 Hardware Requirements

### Essential Components

- **Raspberry Pi 3 Model B** (1GB RAM)
- **Official Raspberry Pi 7" Touchscreen Display** (800x480)
- **MicroSD Card** (16GB minimum, 32GB recommended, Class 10)
- **Power Supply** (5V 2.5A minimum, 3A recommended)
- **Arduino Uno** (for sensor data)
- **Relay Module** (4-channel for actuator control)
- **Sensors**: SCD41 (CO2), DHT22 (temp/humidity), or equivalent

### Connection Diagram

```
┌─────────────────────────────────────────────────────────────┐
│  Raspberry Pi 3 Model B                                     │
│                                                             │
│  GPIO Pins ───────► Relay Module (4-channel)               │
│  USB ──────────────► Arduino Uno (serial sensor data)      │
│  DSI ──────────────► 7" Touchscreen (800x480)              │
│  Ethernet/WiFi ────► Network (for backend sync)            │
│                                                             │
└─────────────────────────────────────────────────────────────┘
```

---

## 💿 OS Installation

### Step 1: Download Raspberry Pi OS

**Option A: Raspberry Pi OS with Desktop** (Recommended)
```bash
# Download from: https://www.raspberrypi.com/software/operating-systems/
# Choose: "Raspberry Pi OS with desktop" (NOT Lite)
# File: 2024-11-19-raspios-bookworm-armhf.img.xz
```

**Why Desktop OS?**
- Kivy requires X11 windowing system
- GPU acceleration for smooth 60 FPS
- Touchscreen input handling
- Desktop Lite OS is too minimal (no X11 libraries)

### Step 2: Flash OS to MicroSD Card

**Using Raspberry Pi Imager** (Easiest method):

1. Download **Raspberry Pi Imager**: https://www.raspberrypi.com/software/
2. Insert MicroSD card into computer
3. Open Raspberry Pi Imager
4. Click **"Choose OS"** → **"Raspberry Pi OS (other)"** → **"Raspberry Pi OS with desktop"**
5. Click **"Choose Storage"** → Select your MicroSD card
6. Click **⚙️ Settings** (gear icon):
   - ✅ Enable SSH
   - ✅ Set username: `pi`
   - ✅ Set password: `mash2025` (or your choice)
   - ✅ Configure WiFi (optional, for first boot)
   - ✅ Set hostname: `mash-iot-device`
7. Click **"Write"**
8. Wait for flashing to complete (~10 minutes)

**Using Balena Etcher** (Alternative):

```bash
# 1. Download Balena Etcher
# https://www.balena.io/etcher/

# 2. Extract OS image
unxz 2024-11-19-raspios-bookworm-armhf.img.xz

# 3. Open Etcher
#    - Select image file
#    - Select target drive (MicroSD)
#    - Flash!
```

### Step 3: First Boot

1. **Insert MicroSD** into Raspberry Pi 3
2. **Connect touchscreen** via DSI connector
3. **Connect power supply** (5V 2.5A minimum)
4. **Wait for boot** (~60 seconds first time)
5. **Follow on-screen setup wizard**:
   - Select country/language
   - Set password (if not set in imager)
   - Connect to WiFi (if not pre-configured)
   - Update software (optional, but recommended)

---

## ⚙️ System Configuration

### Step 1: Update System

```bash
# SSH into RPi (or use terminal on device)
ssh pi@mash-iot-device.local

# Update package lists
sudo apt-get update

# Upgrade installed packages
sudo apt-get upgrade -y

# Reboot after upgrade
sudo reboot
```

### Step 2: Enable Touchscreen

```bash
# Edit config file
sudo nano /boot/config.txt

# Add/verify these lines:
lcd_rotate=2              # Rotate 180° if display is upside down
disable_overscan=1        # Remove black borders
dtoverlay=vc4-kms-v3d     # Enable GPU acceleration

# Save and exit (Ctrl+X, Y, Enter)

# Reboot
sudo reboot
```

### Step 3: Configure GPU Memory

```bash
# Allocate more GPU memory for smooth UI
sudo raspi-config

# Navigate to:
# 4. Performance Options → P2. GPU Memory
# Set to: 256 MB (max for RPi3)

# Exit and reboot
```

### Step 4: Disable Screen Blanking

Prevent screen from turning off during operation:

```bash
# Edit lightdm config
sudo nano /etc/lightdm/lightdm.conf

# Find [Seat:*] section and add:
xserver-command=X -s 0 -dpms

# Save and exit

# Also disable console blanking
sudo nano /etc/kbd/config

# Set:
BLANK_TIME=0
POWERDOWN_TIME=0

# Reboot
sudo reboot
```

### Step 5: Set Display Orientation (if needed)

```bash
# If touchscreen is upside down
sudo nano /boot/config.txt

# Add line:
lcd_rotate=2    # 0=normal, 1=90°, 2=180°, 3=270°

# Save and reboot
```

---

## 📦 Software Installation

### Step 1: Install Python and Dependencies

```bash
# Install Python 3 and pip (should already be installed)
sudo apt-get install -y python3 python3-pip python3-venv

# Install system dependencies for Kivy
sudo apt-get install -y \
    libsdl2-dev \
    libsdl2-image-dev \
    libsdl2-mixer-dev \
    libsdl2-ttf-dev \
    libportmidi-dev \
    libswscale-dev \
    libavformat-dev \
    libavcodec-dev \
    zlib1g-dev \
    libgstreamer1.0-dev \
    gstreamer1.0-plugins-base \
    gstreamer1.0-plugins-good \
    libmtdev-dev \
    xclip \
    xsel

# Install build tools
sudo apt-get install -y \
    build-essential \
    git \
    python3-dev \
    pkg-config
```

### Step 2: Install Serial and GPIO Libraries

```bash
# Install RPi.GPIO for relay control
sudo apt-get install -y python3-rpi.gpio

# Install pyserial for Arduino communication
pip3 install pyserial
```

### Step 3: Clone Repository

```bash
# Navigate to home directory
cd /home/pi

# Clone your repository
git clone https://github.com/YOUR_ORG/MASH-IoT-Device.git

# Or copy files via SCP if not using git
# scp -r MASH-IoT-Device pi@mash-iot-device.local:/home/pi/
```

---

## 🚀 Application Setup

### Step 1: Install Backend Dependencies

```bash
cd /home/pi/MASH-IoT-Device

# Create virtual environment (optional but recommended)
python3 -m venv venv
source venv/bin/activate

# Install backend requirements
pip3 install -r requirements.txt
```

### Step 2: Install Touchscreen UI Dependencies

```bash
cd /home/pi/MASH-IoT-Device/touchscreen_ui

# Install Kivy and UI dependencies
pip3 install -r requirements.txt

# This will install:
# - kivy (UI framework)
# - requests (API client)
# - socketio (real-time updates)
# - netifaces, psutil (system info)
```

### Step 3: Configure Environment Variables

```bash
# Copy example environment file
cd /home/pi/MASH-IoT-Device
cp .env.example .env

# Edit environment file
nano .env

# Set these variables:
DEVICE_ID=MASH-A1-CAL25-D5A91F    # Your device ID
DEVICE_NAME="MASH Chamber #1"     # Your device name
SERIAL_PORT=/dev/ttyUSB0          # Arduino port
BACKEND_API_URL=https://your-backend.com/api/v1
FIREBASE_PROJECT_ID=your-project

# Save and exit
```

### Step 4: Verify Backend Server Works

```bash
# Test the Flask backend first
cd /home/pi/MASH-IoT-Device
python3 integrated_server.py

# You should see:
# ✅ Serial connection established
# ✅ Flask server running on 0.0.0.0:5000

# Test API endpoints
curl http://localhost:5000/api/health
# Should return: {"status": "healthy"}

# Stop server (Ctrl+C) after verification
```

### Step 5: Test Touchscreen UI

```bash
# Run touchscreen UI in development mode
cd /home/pi/MASH-IoT-Device/touchscreen_ui
python3 main.py

# You should see:
# ✅ Kivy window opens on touchscreen
# ✅ "Backend Connected" message appears
# ✅ No errors in console

# Exit with Ctrl+C
```

---

## 🔄 Auto-Boot Configuration

Make both the Flask backend and Kivy UI start automatically on boot.

### Step 1: Create Systemd Service for Backend

```bash
# Create service file
sudo nano /etc/systemd/system/mash-backend.service

# Paste this content:
```

```ini
[Unit]
Description=MASH IoT Device Backend
After=network.target

[Service]
Type=simple
User=pi
WorkingDirectory=/home/pi/MASH-IoT-Device
Environment="PATH=/home/pi/MASH-IoT-Device/venv/bin"
ExecStart=/home/pi/MASH-IoT-Device/venv/bin/python3 integrated_server.py
Restart=always
RestartSec=5

[Install]
WantedBy=multi-user.target
```

```bash
# Save and exit (Ctrl+X, Y, Enter)

# Enable and start service
sudo systemctl daemon-reload
sudo systemctl enable mash-backend.service
sudo systemctl start mash-backend.service

# Check status
sudo systemctl status mash-backend.service

# Should show: Active (running)
```

### Step 2: Create Autostart for Kivy UI

```bash
# Create autostart directory
mkdir -p /home/pi/.config/autostart

# Create desktop entry
nano /home/pi/.config/autostart/mash-ui.desktop

# Paste this content:
```

```ini
[Desktop Entry]
Type=Application
Name=MASH Touchscreen UI
Exec=/home/pi/MASH-IoT-Device/venv/bin/python3 /home/pi/MASH-IoT-Device/touchscreen_ui/main.py
Terminal=false
Hidden=false
NoDisplay=false
X-GNOME-Autostart-enabled=true
```

```bash
# Save and exit

# Make executable
chmod +x /home/pi/.config/autostart/mash-ui.desktop
```

### Step 3: Hide Desktop and Maximize UI (Optional)

Make UI fullscreen and hide desktop icons:

```bash
# Install unclutter to hide mouse cursor
sudo apt-get install -y unclutter

# Create startup script
nano /home/pi/start_ui.sh

# Paste:
```

```bash
#!/bin/bash
# Wait for X server to start
sleep 5

# Hide mouse cursor after 1 second of inactivity
unclutter -idle 1 &

# Start Kivy UI in fullscreen
cd /home/pi/MASH-IoT-Device/touchscreen_ui
/home/pi/MASH-IoT-Device/venv/bin/python3 main.py
```

```bash
# Make executable
chmod +x /home/pi/start_ui.sh

# Update autostart to use script
nano /home/pi/.config/autostart/mash-ui.desktop

# Change Exec line to:
Exec=/home/pi/start_ui.sh
```

### Step 4: Test Auto-Boot

```bash
# Reboot to test
sudo reboot

# After reboot (~30 seconds):
# ✅ Backend should be running (check logs: journalctl -u mash-backend -f)
# ✅ UI should appear on touchscreen automatically
# ✅ Mouse cursor should hide after 1 second

# If something fails, check logs:
sudo journalctl -u mash-backend.service -b  # Backend logs
cat /home/pi/.xsession-errors               # UI logs
```

---

## 🌐 Network Configuration

### Option 1: WiFi Setup via UI

Once the touchscreen UI is running:

1. Tap **"WiFi Setup"** screen
2. Tap **"Scan Networks"**
3. Select your WiFi network
4. Enter password using on-screen keyboard
5. Tap **"Connect"**
6. Wait for connection confirmation

### Option 2: Pre-configure WiFi

```bash
# Edit wpa_supplicant config
sudo nano /etc/wpa_supplicant/wpa_supplicant.conf

# Add network:
network={
    ssid="YourWiFiName"
    psk="YourWiFiPassword"
    key_mgmt=WPA-PSK
}

# Save and reboot
sudo reboot

# Check connection
ifconfig wlan0
```

### Option 3: Ethernet (Recommended for production)

Simply plug in ethernet cable - DHCP will auto-configure.

### Set Static IP (Optional)

```bash
# Edit dhcpcd config
sudo nano /etc/dhcpcd.conf

# Add at end:
interface wlan0
static ip_address=192.168.1.100/24
static routers=192.168.1.1
static domain_name_servers=192.168.1.1 8.8.8.8

# Save and reboot
```

---

## 🎯 Touchscreen Calibration

If touch input is misaligned:

```bash
# Install calibration tool
sudo apt-get install -y xinput-calibrator

# Run calibration
DISPLAY=:0 xinput_calibrator

# Follow on-screen instructions:
# 1. Touch each crosshair precisely
# 2. Tool will output calibration values

# Apply calibration permanently
sudo nano /etc/X11/xorg.conf.d/99-calibration.conf

# Paste the output from xinput_calibrator
# Example:
Section "InputClass"
    Identifier "calibration"
    MatchProduct "FT5406 memory based driver"
    Option "Calibration" "3932 300 294 3801"
    Option "SwapAxes" "1"
EndSection

# Save and reboot
```

---

## ✅ Testing & Validation

### Backend Health Check

```bash
# Check if backend is running
sudo systemctl status mash-backend

# Test API endpoints
curl http://localhost:5000/api/health
curl http://localhost:5000/api/status
curl http://localhost:5000/api/sensor/current
```

### UI Functionality Test

1. **Boot Test**: Reboot and verify UI auto-starts
2. **Touch Test**: Tap buttons to verify touch response
3. **Sensor Data**: Verify live sensor readings display
4. **Actuator Control**: Toggle relays (fans, humidifier, lights)
5. **WiFi Test**: Scan and connect to network
6. **Settings**: Check device info displays correctly

### Performance Monitoring

```bash
# Monitor RAM usage
free -h
# Kivy UI should use ~300MB

# Monitor CPU usage
htop
# Should stay under 50% average

# Monitor temperature
vcgencmd measure_temp
# Should stay under 75°C under load
```

---

## 🔧 Troubleshooting

### Issue: UI doesn't start on boot

**Solution:**
```bash
# Check autostart file exists
ls -la /home/pi/.config/autostart/mash-ui.desktop

# Check logs
cat /home/pi/.xsession-errors

# Test manually
DISPLAY=:0 /home/pi/start_ui.sh
```

### Issue: Backend not running

**Solution:**
```bash
# Check service status
sudo systemctl status mash-backend

# View logs
sudo journalctl -u mash-backend -n 50

# Restart service
sudo systemctl restart mash-backend
```

### Issue: Touch input not working

**Solution:**
```bash
# Check if touchscreen is detected
xinput list

# Recalibrate
DISPLAY=:0 xinput_calibrator

# Check kernel module
lsmod | grep ft5406
```

### Issue: Screen is upside down

**Solution:**
```bash
sudo nano /boot/config.txt
# Add: lcd_rotate=2
sudo reboot
```

### Issue: Low FPS / Laggy UI

**Solution:**
```bash
# Increase GPU memory
sudo raspi-config
# Performance Options → GPU Memory → 256MB

# Check CPU throttling
vcgencmd get_throttled
# 0x0 = no throttling, other values = throttled

# Improve cooling (add heatsink or fan)
```

---

## 🔙 Rollback to CLI

If touchscreen UI has issues, easily revert to CLI-only operation:

### Step 1: Disable UI Auto-Start

```bash
# Remove autostart entry
rm /home/pi/.config/autostart/mash-ui.desktop

# Reboot
sudo reboot

# Backend will still run, but no UI appears
```

### Step 2: Backend Continues Working

The Flask backend (`integrated_server.py`) is **unchanged** and continues to:
- Read sensor data from Arduino
- Control actuators via GPIO
- Sync to Backend/Firebase
- Serve API for mobile app

### Step 3: Mobile App Still Works

The Flutter mobile app can still connect remotely to control the device.

### Step 4: Re-enable UI Later

```bash
# Restore autostart file
cp /home/pi/MASH-IoT-Device/touchscreen_ui/mash-ui.desktop /home/pi/.config/autostart/
sudo reboot
```

---

## 📊 System Resource Summary

| Component | RAM Usage | CPU Usage | Boot Time |
|---|---|---|---|
| Raspbian Desktop | ~200MB | 5-10% | 20s |
| Flask Backend | ~50MB | 5-15% | 2s |
| Kivy UI | ~300MB | 10-20% | 5s |
| **Total** | **~550MB** | **20-45%** | **27s** |
| **Available** | 450MB free | 55-80% free | - |

**Performance Target**: 60 FPS, <75°C CPU temp, <80% RAM usage ✅

---

## 📝 Post-Deployment Checklist

- [ ] RPi3 boots automatically to touchscreen UI
- [ ] Sensor data displays in real-time
- [ ] Touch input is responsive and accurate
- [ ] Actuators toggle correctly when tapped
- [ ] WiFi connection is stable
- [ ] Backend syncs to cloud (if configured)
- [ ] Mobile app can still connect remotely
- [ ] System runs for 24 hours without crashes
- [ ] CPU temperature stays under 75°C
- [ ] RAM usage stays under 80%

---

## 🆘 Support

If you encounter issues not covered in this guide:

1. **Check Logs**:
   ```bash
   sudo journalctl -u mash-backend -f  # Backend logs
   cat /home/pi/.xsession-errors       # UI logs
   dmesg | tail -50                    # Kernel logs
   ```

2. **Review Documentation**:
   - `README.md` - Overview and architecture
   - `../documents/API_SPECIFICATION.md` - API reference
   - `../documents/DEPLOYMENT_GUIDE.md` - Original CLI deployment

3. **Test Components Individually**:
   ```bash
   # Test backend only
   python3 integrated_server.py
   
   # Test UI only (assumes backend running)
   python3 touchscreen_ui/main.py
   ```

---

## 🎉 Success!

Your MASH IoT device now has:
- ✅ Local touchscreen interface for on-site control
- ✅ Flask backend API running as system service
- ✅ Auto-boot configuration for hands-free operation
- ✅ Mobile app still works for remote control
- ✅ Easy rollback to CLI if needed

**Next Steps**: Implement remaining UI screens (Dashboard, Controls, Settings) in Phase 2.

---

**Document Version**: 1.0  
**Last Updated**: December 5, 2025  
**Tested On**: Raspberry Pi 3 Model B + Raspbian Bookworm Desktop
