MASH-Mushroom-Automation/MASH-IoT-Device/documents/RULE_BASED_AUTOMATION_GUIDE.md

# MASH IoT - Rule-Based Automation System Guide

## Overview

The Rule-Based Automation System provides intelligent, autonomous control of your mushroom growing chamber using **mathematical thresholds and decision logic** - no machine learning or training datasets required.

### Key Features
- **Mathematical Control**: Uses proven threshold-based decision logic
- **Lightweight**: ~5-10MB RAM usage (perfect for RPi3)
- **Immediate Deployment**: No training data or model preparation needed
- **Scientifically-Based**: Thresholds derived from mushroom cultivation research
- **Mode-Aware**: Different strategies for Spawning vs Fruiting phases
- **Manual Override**: Can be disabled anytime
- **Decision Logging**: Tracks all automated actions and reasoning

---

## How It Works

### Control Strategy

The system uses **simple mathematical comparisons** to make decisions:

```
IF sensor_value > threshold_max THEN
    activate_corrective_actuator
ELSE IF sensor_value < threshold_min THEN
    deactivate_actuator
```

### Hysteresis Prevention

To prevent rapid on/off cycling (oscillation), the system includes **hysteresis buffers**:

```
Effective_Threshold = Base_Threshold ± Hysteresis_Buffer

Example:
- CO2 Max: 1000 ppm
- Hysteresis: 500 ppm
- Turns ON at: 1000 ppm
- Turns OFF at: 500 ppm (1000 - 500)
```

---

## Mathematical Thresholds

### Spawning Phase Formulas

**Objective**: Maintain high CO2 for mycelial growth

```
CO2 Control:
- IF co2 < 10,000 ppm: exhaust_fan = OFF (accumulate CO2)
- IF co2 > 20,000 ppm: exhaust_fan = ON (safety vent)
- ELSE: maintain current state

Temperature Control:
- IF temperature > 27°C: blower_fan = ON
- IF temperature < 21°C: blower_fan = OFF
- ELSE: maintain current state

Humidity Control:
- IF humidity < 85%: humidifier = ON
- IF humidity > 95%: humidifier = OFF
- ELSE: maintain current state
```

### Fruiting Phase Formulas

**Objective**: Maintain fresh air exchange for fruiting body development

```
CO2 Control:
- IF co2 > 1,000 ppm: exhaust_fan = ON (ventilate)
- IF co2 < 300 ppm: exhaust_fan = OFF (reduce ventilation)
- IF co2 > (600 + 500): exhaust_fan = ON (hysteresis)

Temperature Control:
- IF temperature > 24°C: blower_fan = ON
- IF temperature < 18°C: blower_fan = OFF
- ELSE: maintain current state

Humidity Control:
- IF humidity < 85%: humidifier = ON
- IF humidity > 95%: humidifier = OFF
- ELSE: maintain current state
```

---

## Threshold Values Table

| Parameter | Spawning Phase | Fruiting Phase | Unit | Notes |
|---|---|---|---|---|
| CO2 Min | 10,000 | 300 | ppm | Lower safety limit |
| CO2 Optimal | 12,500 | 600 | ppm | Target value |
| CO2 Max | 20,000 | 1,000 | ppm | Upper safety limit |
| Temp Min | 21 | 18 | °C | Lower comfort zone |
| Temp Max | 27 | 24 | °C | Upper comfort zone |
| Humidity Min | 85 | 85 | % | Minimum for growth |
| Humidity Max | 95 | 95 | % | Maximum before issues |
| CO2 Hysteresis | 500 | 500 | ppm | Oscillation buffer |
| Temp Hysteresis | 1.0 | 1.0 | °C | Oscillation buffer |
| Humidity Hysteresis | 3.0 | 3.0 | % | Oscillation buffer |

---

## Setup & Usage

### Quick Start

1. **No training required** - The system works immediately with default thresholds

2. **Start the server**:
   ```bash
   cd /home/mash/MASH-IoT-Device
   python3 integrated_server.py
   ```

3. **Enable automation** (disabled by default):
   ```bash
   curl -X POST http://raspberrypi.local:5000/api/automation/enable
   ```

### Customizing Thresholds

You can adjust thresholds for different mushroom species or growing conditions:

**Option 1: Edit the configuration file**

Create `config/thresholds.json`:
```json
{
  "version": "1.0",
  "updated_date": "2025-11-10",
  "thresholds": {
    "spawning_co2_min": 12000,
    "fruiting_co2_max": 800,
    "spawning_temp_max": 26.0
  }
}
```

**Option 2: Update via API**

```bash
curl -X POST http://raspberrypi.local:5000/api/automation/threshold \
  -H "Content-Type: application/json" \
  -d '{"key": "fruiting_co2_max", "value": 800}'
```

---

## API Endpoints

### Get Automation Status
```http
GET /api/automation/status
```

**Response**:
```json
{
  "success": true,
  "data": {
    "enabled": true,
    "controller_type": "rule_based_mathematical",
    "thresholds": {
      "spawning_co2_min": 10000,
      "fruiting_co2_max": 1000,
      "co2_hysteresis": 500
    },
    "decisions_made": 42,
    "last_decision": {
      "timestamp": "2025-11-10T19:30:00",
      "mode": "Fruiting",
      "sensor_data": {
        "co2": 1200,
        "temperature": 22.5,
        "humidity": 88.0
      },
      "actions": {
        "exhaust_fan": true
      },
      "reasoning": [
        "CO2 high (1200 ppm > 1000 ppm) - activating fresh air exchange"
      ]
    }
  }
}
```

### Enable/Disable Automation
```http
POST /api/automation/enable
POST /api/automation/disable
```

### Get Decision History
```http
GET /api/automation/history?limit=10
```

---

## Decision Logic Examples

### Example 1: Spawning Phase - CO2 Accumulation

**Scenario**: CO2 drops to 8,000 ppm

```
Sensor Reading:
- CO2: 8,000 ppm
- Temperature: 24°C
- Humidity: 90%
- Current State: exhaust_fan = ON

Mathematical Evaluation:
- co2 (8000) < spawning_co2_min (10000)? YES
- Current exhaust_fan state? ON
- Action: Turn exhaust_fan OFF

Reasoning:
"CO2 too low (8000 ppm < 10000 ppm) - stopping exhaust to accumulate CO2"

Result:
- exhaust_fan = OFF
- Chamber will accumulate CO2 from mushroom respiration
```

### Example 2: Fruiting Phase - High CO2 Ventilation

**Scenario**: CO2 rises to 1,500 ppm

```
Sensor Reading:
- CO2: 1,500 ppm
- Temperature: 20°C
- Humidity: 88%
- Current State: exhaust_fan = OFF

Mathematical Evaluation:
- co2 (1500) > fruiting_co2_max (1000)? YES
- Current exhaust_fan state? OFF
- Action: Turn exhaust_fan ON

Reasoning:
"CO2 high (1500 ppm > 1000 ppm) - activating fresh air exchange"

Result:
- exhaust_fan = ON
- Fresh air will reduce CO2 levels
- Fan will turn off when CO2 drops below 1000 ppm
```

### Example 3: Temperature Control with Hysteresis

**Scenario**: Temperature fluctuating around threshold

```
Initial State:
- Temperature: 27.5°C (above max 27°C)
- blower_fan = OFF

Decision 1:
- temp (27.5) > spawning_temp_max (27.0)? YES
- Action: blower_fan = ON
- Reasoning: "Temperature high (27.5°C > 27°C) - activating cooling fan"

After 30 seconds:
- Temperature: 26.8°C (still above min, but below max)
- blower_fan = ON
- No action taken (hysteresis prevents premature shutoff)

After 2 minutes:
- Temperature: 20.5°C (below min 21°C)
- Action: blower_fan = OFF
- Reasoning: "Temperature low (20.5°C < 21°C) - deactivating cooling fan"
```

---

## Scientific Basis

### Why These Thresholds?

**Spawning Phase (High CO2)**:
- Mycelium growth is enhanced in high CO2 environments
- Accumulating CO2 from mushroom respiration creates ideal conditions
- Research shows 10,000-20,000 ppm CO2 optimal for colonization

**Fruiting Phase (Low CO2)**:
- High CO2 inhibits primordia formation (pinning)
- Fresh air exchange triggers fruiting body development
- Ambient air levels (300-1,000 ppm) promote healthy mushroom growth

**Temperature Ranges**:
- Based on Oyster mushroom (*Pleurotus* species) requirements
- Spawning: 21-27°C for rapid mycelial growth
- Fruiting: 18-24°C for optimal fruiting body formation

**Humidity Levels**:
- 85-95% prevents drying and maintains surface moisture
- Critical for both mycelial growth and mushroom development
- Too low causes stalling, too high risks contamination

---

## Adapting for Different Mushroom Species

You can modify thresholds for different species:

### Shiitake (*Lentinula edodes*)
```json
{
  "spawning_temp_min": 20.0,
  "spawning_temp_max": 25.0,
  "fruiting_temp_min": 10.0,
  "fruiting_temp_max": 21.0
}
```

### Lion's Mane (*Hericium erinaceus*)
```json
{
  "spawning_temp_min": 21.0,
  "spawning_temp_max": 24.0,
  "fruiting_temp_min": 13.0,
  "fruiting_temp_max": 18.0,
  "fruiting_humidity_min": 90.0
}
```

### King Oyster (*Pleurotus eryngii*)
```json
{
  "spawning_temp_min": 21.0,
  "spawning_temp_max": 24.0,
  "fruiting_temp_min": 10.0,
  "fruiting_temp_max": 18.0
}
```

---

## Performance Characteristics

### Resource Usage (Raspberry Pi 3)
- **RAM**: ~5-10MB for controller
- **CPU**: <2% average (spikes to 5% during decisions)
- **Decision Time**: <50ms per cycle
- **Update Frequency**: Every 10 seconds (configurable)

### Reliability
- **No dataset dependency**: Works immediately
- **No training time**: Deploy and run
- **Deterministic**: Same inputs always produce same outputs
- **Predictable**: Easy to understand and debug

---

## Troubleshooting

### Actuators Not Responding as Expected

**Check thresholds**:
```bash
curl http://raspberrypi.local:5000/api/automation/status | jq '.data.thresholds'
```

**Review decision logic**:
```bash
curl http://raspberrypi.local:5000/api/automation/history?limit=5
```

### Rapid Actuator Cycling

**Increase hysteresis buffers**:
```json
{
  "co2_hysteresis": 1000,
  "temp_hysteresis": 2.0,
  "humidity_hysteresis": 5.0
}
```

### Thresholds Don't Match Your Environment

**Adjust for your conditions**:
1. Monitor chamber for 24 hours
2. Identify optimal ranges from historical data
3. Update thresholds accordingly
4. Test for another 24 hours

---

## Advantages Over AI/ML Approach

| Aspect | Rule-Based (Current) | AI/ML Approach |
|---|---|---|
| Setup Time | Immediate | Weeks of data collection |
| RAM Usage | 5-10MB | 50-200MB |
| Explainability | Perfect (see exact logic) | Black box |
| Reliability | Deterministic | Probabilistic |
| Maintenance | Simple threshold updates | Regular retraining |
| Debugging | Easy to trace | Difficult |
| Dataset Required | None | Hundreds of samples |
| Training Time | 0 seconds | Minutes to hours |

---

## Migration from Old AI System

The new `rule_based_controller.py` maintains backward compatibility:

```python
# Old code still works
from ai_automation import AIAutomationEngine
controller = AIAutomationEngine()

# New recommended approach
from rule_based_controller import RuleBasedController
controller = RuleBasedController()
```

**No changes needed** to existing integration code!

---

## Best Practices

### 1. Start with Default Thresholds
- The defaults are scientifically-based for Oyster mushrooms
- Test for 48 hours before adjusting

### 2. Make Incremental Changes
- Adjust one threshold at a time
- Document changes and results
- Wait 24 hours between adjustments

### 3. Monitor Decision History
- Review automation decisions daily
- Verify actions match expectations
- Adjust thresholds based on mushroom growth

### 4. Keep Manual Override Available
- Always have the mobile app accessible
- Monitor chamber visually
- Disable automation if unexpected behavior occurs

---

## Summary

The Rule-Based Automation System provides:
- **Simple**: Mathematical threshold comparisons
- **Fast**: No training or datasets required
- **Reliable**: Deterministic and predictable
- **Efficient**: Minimal resource usage
- **Transparent**: Every decision is explainable
- **Scientific**: Based on mushroom cultivation research

No AI or machine learning required - just proven mathematical logic!

---

**Questions?** Check the decision history API to understand what the controller is doing and why.
