MASH-Mushroom-Automation/MASH-IoT-Device/main.py

#!/usr/bin/env python3
"""
MASH IoT Device - Main Application
Raspberry Pi controller for mushroom cultivation automation
"""

import os
import sys
import time
import signal
import logging
import argparse
from datetime import datetime
from typing import Optional, Dict, Any

# Add src directory to Python path
sys.path.insert(0, os.path.join(os.path.dirname(__file__), 'src'))

from sensors import SensorManager, SensorReading
from storage import DatabaseManager
from utils.config import Config
from utils.logger import setup_logging
from mqtt import MQTTClient
from api import APIServer
from discovery import MDNSService
from utils.network_manager import NetworkManager
from utils.provisioning_manager import ProvisioningManager
from utils.hotspot_manager import HotspotManager
from arduino_scd41_bridge import ArduinoSCD41Bridge
from backend_client import BackendClient
from actuators import ActuatorManager


class MASHDevice:
    """Main MASH IoT Device application"""
    
    def __init__(self, config_path: Optional[str] = None):
        """
        Initialize MASH device
        
        Args:
            config_path: Path to configuration file
        """
        self.logger = logging.getLogger(__name__)
        self.running = False
        
        # Load configuration
        self.config = Config(config_path)
        
        # Initialize components
        self.database = None
        self.sensor_manager = None
        self.arduino_bridge = None
        self.mqtt_client = None
        self.api_server = None
        self.mdns_service = None
        self.network_manager = None
        self.provisioning_manager = None
        self.hotspot_manager = None
        self.backend_client = None
        self.actuator_manager = None
        
        # Setup signal handlers for graceful shutdown
        signal.signal(signal.SIGINT, self._signal_handler)
        signal.signal(signal.SIGTERM, self._signal_handler)
    
    def initialize(self) -> bool:
        """
        Initialize all device components
        
        Returns:
            True if initialization successful, False otherwise
        """
        try:
            self.logger.info("Initializing MASH IoT Device...")
            
            # Create required directories
            self._ensure_directories()
            
            # Get device ID
            device_id = self.config.get('device_id', self.config.get('device.id', 'mash-device-001'))
            mock_mode = self.config.get('mock_mode', self.config.get('development.mock_mode', False))
            provisioning_mode = self.config.get('provisioning_mode', self.config.get('provisioning.mode', False))
            
            # Initialize database
            self.database = DatabaseManager(
                db_path=self.config.get('database_path', self.config.get('database.path', './data/mash_device.db')),
                timeout=self.config.get('sqlite_timeout', self.config.get('database.timeout', 30))
            )
            
            sensor_source = self.config.get('sensors.source', 'arduino_bridge')

            if sensor_source == 'arduino_bridge' and not mock_mode:
                self.logger.info("Using Arduino SCD41 bridge for sensor data")
                serial_port = self.config.get('sensors.serial.port', self.config.get('sensors.serial_port', '/dev/ttyACM0'))
                serial_baud = self.config.get('sensors.serial.baud', self.config.get('sensors.serial_baud', 9600))
                self.arduino_bridge = ArduinoSCD41Bridge(
                    serial_port=serial_port,
                    baud_rate=serial_baud,
                    data_callback=self._on_sensor_reading,
                    log_level=logging.DEBUG if self.config.get('debug_mode', False) else logging.INFO
                )
                self.sensor_manager = None
            else:
                self.logger.info("Using onboard SCD41 sensor manager")
                self.sensor_manager = SensorManager(
                    read_interval=self.config.get('sensor_read_interval', self.config.get('sensors.scd41.read_interval', 60)),
                    mock_mode=mock_mode,
                    calibration_offsets={
                        'temp': self.config.get('sensor_calibration_offset_temp', self.config.get('sensors.scd41.calibration.temperature_offset', 0.0)),
                        'humidity': self.config.get('sensor_calibration_offset_humidity', self.config.get('sensors.scd41.calibration.humidity_offset', 0.0))
                    },
                    data_callback=self._on_sensor_reading
                )
            
            # Initialize MQTT client
            self.mqtt_client = MQTTClient(
                broker_url=self.config.get('mqtt_broker_url', self.config.get('mqtt.broker_url', 'mqtt://localhost:1883')),
                client_id=self.config.get('mqtt_client_id', device_id),
                username=self.config.get('mqtt_username', self.config.get('mqtt.username', '')),
                password=self.config.get('mqtt_password', self.config.get('mqtt.password', '')),
                keepalive=self.config.get('mqtt_keepalive', self.config.get('mqtt.keepalive', 60)),
                qos=self.config.get('mqtt_qos', self.config.get('mqtt.qos', 1)),
                mock_mode=mock_mode
            )
            
            # Register MQTT command handlers
            self.mqtt_client.register_command_handler('sensor_config', self._handle_sensor_config_command)
            self.mqtt_client.register_command_handler('device_reboot', self._handle_device_reboot_command)
            
            # Initialize API server
            self.api_server = APIServer(
                host='0.0.0.0',
                port=5000,
                debug=self.config.get('debug_mode', self.config.get('development.debug_mode', False)),
                mock_mode=mock_mode
            )
            
            # Register API callbacks
            self.api_server.register_sensor_data_callback(self._get_latest_sensor_data)
            self.api_server.register_device_status_callback(self.get_status)
            self.api_server.register_command_handler('sensor_config', self._handle_sensor_config_command)
            self.api_server.register_command_handler('actuator_control', self._handle_actuator_command)
            self.api_server.register_wifi_scan_callback(self._wifi_scan)
            self.api_server.register_wifi_connect_callback(self._wifi_connect)
            self.api_server.register_provisioning_info_callback(self._get_provisioning_info)
            
            # Initialize network manager
            self.network_manager = NetworkManager(
                interface='wlan0',
                mock_mode=mock_mode
            )
            
            # Initialize hotspot manager for provisioning
            self.hotspot_manager = HotspotManager(
                device_id=device_id,
                interface='wlan0',
                ssid_prefix='MASH-Chamber',
                password=None,  # Open network for easy setup
                ap_ip='192.168.4.1',
                mock_mode=mock_mode
            )
            
            # Initialize backend client
            backend_url = self.config.get('backend.api_url', 'https://mash-backend.onrender.com/api')
            self.backend_client = BackendClient(
                api_url=backend_url,
                device_id=device_id,
                api_key=self.config.get('backend.api_key'),
                timeout=self.config.get('backend.timeout', 30),
                mock_mode=mock_mode
            )
            
            # Initialize actuator manager
            self.actuator_manager = ActuatorManager(mock_mode=mock_mode)
            
            # Initialize mDNS service
            self.mdns_service = MDNSService(
                device_id=device_id,
                service_name=self.config.get('device_name', self.config.get('device.name', 'MASH IoT Device')),
                port=5000,
                mock_mode=mock_mode
            )
            
            # Check network connectivity and start provisioning if needed
            if not self.network_manager.is_connected():
                self.logger.info("[WARN] Device not connected to WiFi")
                self.logger.info("Starting provisioning mode (hotspot)")
                if self.hotspot_manager.start():
                    self.logger.info("Provisioning hotspot active")
                    self.logger.info(f"Connect to WiFi: {self.hotspot_manager.ssid}")
                    self.logger.info(f"Access setup at: http://{self.hotspot_manager.ap_ip}:5000")
                else:
                    self.logger.error("Failed to start provisioning hotspot")
            else:
                self.logger.info("Device connected to WiFi")
                # Try to register with backend
                self._try_backend_registration()
            
            self.logger.info("Device initialization completed")
            return True
            
        except Exception as e:
            self.logger.error(f"Device initialization failed: {e}")
            return False
            
    def _ensure_directories(self):
        """Create required directories if they don't exist"""
        try:
            import os
            
            # Create data directory
            data_dir = os.path.join(os.path.dirname(__file__), 'data')
            os.makedirs(data_dir, exist_ok=True)
            self.logger.debug(f"Created/verified data directory: {data_dir}")
            
            # Create logs directory
            logs_dir = os.path.join(os.path.dirname(__file__), 'logs')
            os.makedirs(logs_dir, exist_ok=True)
            self.logger.debug(f"Created/verified logs directory: {logs_dir}")
            
        except Exception as e:
            self.logger.error(f"Failed to create directories: {e}")
            raise
    
    def start(self) -> bool:
        """
        Start the device operation
        
        Returns:
            True if started successfully, False otherwise
        """
        try:
            self.logger.info("Starting MASH IoT Device...")
            
            # Start sensor pipeline
            if self.sensor_manager:
                if not self.sensor_manager.start():
                    self.logger.error("Failed to start sensor manager")
                    return False
            if self.arduino_bridge:
                if not self.arduino_bridge.start():
                    self.logger.error("Failed to start Arduino bridge")
                    return False
            
            # Start MQTT client
            if self.mqtt_client:
                if not self.mqtt_client.connect():
                    self.logger.warning("Failed to connect MQTT client, will retry later")
                    # Continue anyway - MQTT is not critical
            
            # Start API server
            if self.api_server:
                if not self.api_server.start():
                    self.logger.warning("Failed to start API server")
                    # Continue anyway - API is not critical
            
            # Start mDNS service (only if not in provisioning mode)
            if self.mdns_service and not self.provisioning_manager.is_provisioning:
                if not self.mdns_service.start():
                    self.logger.warning("Failed to start mDNS service")
                    # Continue anyway - mDNS is not critical
            
            self.running = True
            self.logger.info("MASH IoT Device started successfully")
            return True
            
        except Exception as e:
            self.logger.error(f"Failed to start device: {e}")
            return False
    
    def run(self):
        """Main application loop"""
        try:
            while self.running:
                # Main application logic here
                time.sleep(1)
                
        except KeyboardInterrupt:
            self.logger.info("Received interrupt signal")
        except Exception as e:
            self.logger.error(f"Error in main loop: {e}")
        finally:
            self.stop()
    
    def stop(self):
        """Stop the device and cleanup resources"""
        if not self.running:
            return
        
        self.logger.info("Stopping MASH IoT Device...")
        self.running = False
        
        # Stop sensor manager or bridge
        if self.sensor_manager:
            self.sensor_manager.stop()
        if self.arduino_bridge:
            self.arduino_bridge.stop()
            self.arduino_bridge = None
        
        # Stop MQTT client
        if self.mqtt_client:
            self.mqtt_client.disconnect()
        
        # Stop API server
        if self.api_server:
            self.api_server.stop()
        
        # Stop mDNS service
        if self.mdns_service:
            self.mdns_service.stop()
        
        # Stop hotspot
        if self.hotspot_manager:
            self.hotspot_manager.stop()
        
        # Stop actuators
        if self.actuator_manager:
            self.actuator_manager.cleanup()
        
        # Close backend connection
        if self.backend_client:
            self.backend_client.close()
        
        self.logger.info("MASH IoT Device stopped")
    
    def _on_sensor_reading(self, reading: SensorReading):
        """
        Callback for new sensor readings
        
        Args:
            reading: New sensor reading
        """
        try:
            # Store reading in database
            reading_data = reading.to_dict()
            reading_data['device_id'] = self.config.get('device_id', 'default_device')
            reading_data['sensor_type'] = 'environment'  # Combined environmental reading
            reading_data['unit'] = 'mixed'
            
            if self.database.store_sensor_reading(reading_data):
                self.logger.debug(f"Stored sensor reading: {reading}")
            else:
                self.logger.error(f"Failed to store sensor reading: {reading}")
            
            # Publish telemetry data via MQTT
            if self.mqtt_client and self.mqtt_client.connected:
                self.mqtt_client.publish_telemetry(reading_data)
            
        except Exception as e:
            self.logger.error(f"Error processing sensor reading: {e}")
    
    def _get_latest_sensor_data(self) -> Dict[str, Any]:
        """
        Get latest sensor data for API
        
        Returns:
            Dictionary with latest sensor readings
        """
        if self.sensor_manager and hasattr(self.sensor_manager, 'get_latest_reading'):
            latest = self.sensor_manager.get_latest_reading()
            if latest:
                reading = latest.to_dict()
                reading['source'] = 'sensor_manager'
                return reading
        if self.arduino_bridge:
            latest = self.arduino_bridge.get_latest_reading()
            if latest:
                reading = latest.to_dict()
                reading['source'] = 'arduino_bridge'
                return reading
        return {}
    
    def _handle_sensor_config_command(self, command_data: Dict[str, Any]) -> Dict[str, Any]:
        """
        Handle sensor configuration command
        
        Args:
            command_data: Command data
            
        Returns:
            Result of command execution
        """
        try:
            if 'read_interval' in command_data:
                new_interval = int(command_data['read_interval'])
                if self.sensor_manager:
                    self.sensor_manager.set_read_interval(new_interval)
                    self.logger.info(f"Updated sensor read interval to {new_interval} seconds")
                    return {"success": True, "new_interval": new_interval}
                return {"success": False, "error": "Sensor manager not available for interval updates"}
            
            return {"success": False, "error": "Invalid command data"}
        except Exception as e:
            self.logger.error(f"Error handling sensor config command: {e}")
            return {"success": False, "error": str(e)}
    
    def _handle_device_reboot_command(self, command_data: Dict[str, Any]) -> Dict[str, Any]:
        """
        Handle device reboot command
        
        Args:
            command_data: Command data
            
        Returns:
            Result of command execution
        """
        try:
            delay = int(command_data.get('delay', 5))
            self.logger.info(f"Received reboot command, will reboot in {delay} seconds")
            
            # Schedule reboot in a separate thread
            import threading
            threading.Thread(target=self._delayed_reboot, args=(delay,), daemon=True).start()
            
            return {"success": True, "reboot_in": delay}
        except Exception as e:
            self.logger.error(f"Error handling reboot command: {e}")
            return {"success": False, "error": str(e)}
    
    def _delayed_reboot(self, delay: int):
        """
        Perform delayed reboot
        
        Args:
            delay: Delay in seconds
        """
        try:
            time.sleep(delay)
            self.logger.info("Executing reboot command")
            
            # Stop all services
            self.stop()
            
            # Execute reboot command
            import subprocess
            subprocess.call(['sudo', 'reboot'])
        except Exception as e:
            self.logger.error(f"Failed to reboot: {e}")
    
    def _signal_handler(self, signum, frame):
        """Handle shutdown signals"""
        self.logger.info(f"Received signal {signum}, shutting down...")
        self.stop()
        sys.exit(0)
    
    def get_status(self) -> dict:
        """Get device status"""
        status = {
            'running': self.running,
            'timestamp': datetime.now().isoformat(),
            'config': {
                'device_id': self.config.get('device_id'),
                'mock_mode': self.config.get('mock_mode', False),
                'sensor_interval': self.config.get('sensor_read_interval', 60),
                'sensor_source': self.config.get('sensors.source', 'arduino_bridge')
            }
        }
        
        if self.sensor_manager:
            status['sensor_manager'] = self.sensor_manager.get_statistics()
        if self.arduino_bridge:
            status['arduino_bridge'] = self.arduino_bridge.get_statistics()
        
        if self.database:
            status['database'] = self.database.get_database_stats()
        
        if self.mqtt_client:
            status['mqtt'] = {'connected': getattr(self.mqtt_client, 'connected', False)}
        
        if self.api_server:
            status['api'] = {'running': getattr(self.api_server, 'running', False)}
        
        if self.network_manager:
            status['network'] = {
                'connected': self.network_manager.is_connected(),
                'connection': self.network_manager.get_current_connection()
            }
        
        if self.provisioning_manager:
            status['provisioning'] = self.provisioning_manager.get_provisioning_info()
        
        return status
    
    def _wifi_scan(self):
        """WiFi scan callback for API server"""
        if self.network_manager:
            return self.network_manager.scan_wifi_networks()
        return []
    
    def _wifi_connect(self, ssid: str, password: str) -> bool:
        """WiFi connect callback for API server"""
        if self.network_manager and self.hotspot_manager:
            self.logger.info(f"Attempting to connect to WiFi: {ssid}")
            
            # First, stop the hotspot
            self.logger.info("Stopping hotspot...")
            self.hotspot_manager.stop()
            
            # Wait a moment for network interface to stabilize
            import time
            time.sleep(2)
            
            # Try to connect to WiFi
            success = self.network_manager.connect_to_wifi(ssid, password)
            
            if success:
                self.logger.info("WiFi connected successfully")
                
                # Wait for network to fully establish
                time.sleep(3)
                
                # Start mDNS service
                if self.mdns_service and not self.mdns_service.running:
                    self.mdns_service.start()
                
                # Register device with backend
                self._try_backend_registration()
                
                return True
            else:
                self.logger.error("WiFi connection failed")
                self.logger.info("Restarting hotspot...")
                
                # Restart hotspot if connection failed
                time.sleep(2)
                self.hotspot_manager.start()
                
                return False
        
        return False
    
    def _get_provisioning_info(self) -> Dict[str, Any]:
        """Get provisioning info callback for API server"""
        info = {}
        
        if self.hotspot_manager:
            info.update(self.hotspot_manager.get_status())
        
        if self.network_manager:
            info['network_connected'] = self.network_manager.is_connected()
            info['current_connection'] = self.network_manager.get_current_connection()
        
        if self.backend_client:
            info['backend_registered'] = self.backend_client.is_registered
            info['backend_url'] = self.backend_client.api_url
        
        return info
    
    def _try_backend_registration(self):
        """Try to register device with backend"""
        if not self.backend_client:
            return
        
        try:
            # Check if backend is reachable
            if not self.backend_client.check_connection():
                self.logger.warning("Backend not reachable, skipping registration")
                return
            
            # Get device info
            device_info = {
                'name': self.config.get('device.name', 'MASH Chamber'),
                'type': self.config.get('device.type', 'MUSHROOM_CHAMBER'),
                'firmware': '1.0.0',
                'location': 'Unknown',
                'ip_address': self.network_manager.get_interface_ip() if self.network_manager else None
            }
            
            # For now, use a default user ID (this should come from mobile app during provisioning)
            # TODO: Get actual user_id from provisioning flow
            user_id = self.config.get('device.owner_user_id', 'default-user')
            
            self.logger.info("Attempting to register with backend...")
            if self.backend_client.register_device(user_id, device_info):
                self.logger.info("Device registered with backend")
            else:
                self.logger.warning("Failed to register with backend")
                
        except Exception as e:
            self.logger.error(f"Error during backend registration: {e}")
    
    def _handle_actuator_command(self, command_data: Dict[str, Any]) -> Dict[str, Any]:
        """Handle actuator control commands"""
        if not self.actuator_manager:
            return {"success": False, "error": "Actuator manager not available"}
        
        try:
            action = command_data.get('action')
            
            if action == 'set':
                # Set individual or multiple actuators
                exhaust_fan = command_data.get('exhaust_fan')
                intake_fan = command_data.get('intake_fan')
                humidifier = command_data.get('humidifier')
                led_lights = command_data.get('led_lights')
                
                success = self.actuator_manager.set_all(
                    exhaust_fan=exhaust_fan,
                    intake_fan=intake_fan,
                    humidifier=humidifier,
                    led_lights=led_lights
                )
                
                if success:
                    return {
                        "success": True,
                        "state": self.actuator_manager.get_state_dict()
                    }
                else:
                    return {"success": False, "error": "Failed to set actuators"}
            
            elif action == 'get_state':
                return {
                    "success": True,
                    "state": self.actuator_manager.get_state_dict()
                }
            
            elif action == 'all_off':
                success = self.actuator_manager.turn_all_off()
                return {
                    "success": success,
                    "state": self.actuator_manager.get_state_dict()
                }
            
            elif action == 'set_mode':
                mode = command_data.get('mode', 'MANUAL')
                success = self.actuator_manager.set_mode(mode)
                return {
                    "success": success,
                    "mode": mode
                }
            
            else:
                return {"success": False, "error": f"Unknown action: {action}"}
                
        except Exception as e:
            self.logger.error(f"Error handling actuator command: {e}")
            return {"success": False, "error": str(e)}


def main():
    """Main entry point"""
    parser = argparse.ArgumentParser(description='MASH IoT Device')
    parser.add_argument('--config', help='Configuration file path')
    parser.add_argument('--mock', action='store_true', help='Run in mock mode')
    parser.add_argument('--debug', action='store_true', help='Enable debug logging')
    parser.add_argument('--status', action='store_true', help='Show device status and exit')
    parser.add_argument('--provision', action='store_true', help='Run in provisioning mode')
    
    args = parser.parse_args()
    
    # Setup logging
    log_level = logging.DEBUG if args.debug else logging.INFO
    setup_logging(level=log_level)
    
    logger = logging.getLogger(__name__)
    logger.info("MASH IoT Device starting...")
    
    try:
        # Create device instance
        device = MASHDevice(config_path=args.config)
        
        # Override mock mode if specified
        if args.mock:
            device.config.set('development.mock_mode', True)
        
        # Set provisioning mode if specified
        if args.provision:
            device.config.set('provisioning_mode', True)
            logger.info("Provisioning mode enabled")
        
        # Initialize device
        if not device.initialize():
            logger.error("Device initialization failed")
            sys.exit(1)
        
        # Show status and exit if requested
        if args.status:
            status = device.get_status()
            print(f"Device Status: {status}")
            sys.exit(0)
        
        # Start device
        if not device.start():
            logger.error("Failed to start device")
            sys.exit(1)
        
        # Run main loop
        device.run()
        
    except Exception as e:
        logger.error(f"Fatal error: {e}")
        sys.exit(1)


if __name__ == '__main__':
    main()
