MASH-Mushroom-Automation/MASH-IoT-Device/(commit log)

2025-10-16 Initial project setup for MASH IoT device
    Added project structure, configuration files, deployment script, documentation, and initial source code for Raspberry Pi-based IoT device. Includes sensor, storage, utility modules, database schema aligned with backend, and mock/test data for development and integration.
2025-10-22 Add Arduino Uno test modules and RPi IoT device plan
    Added Arduino Uno test code for SCD41 sensor, live graph visualization script, and related documentation and images for hardware setup and testing. Introduced initial project plan, setup guides, and configuration files for the Raspberry Pi IoT device, including WiFi and SSH configuration, as well as backend integration and development workflow documentation. Also added initial API, discovery, and MQTT client modules, and updated main.py and requirements.txt to support new features.
2025-11-06 Add documentation, core scripts, and config files
    Added multiple markdown documentation files (guides, API specs, logging, deployment), example environment and service files, and core Python/Arduino scripts for device operation, data logging, automation, and network management. Updated main application, configuration, and utility modules to support new features and improved integration. Initial setup for Raspberry Pi and Arduino Uno, including actuator and sensor management, live dashboard, and installation scripts.
    python integrated_server.py
    [training_data_template.csv]
2025-11-11 Add Bluetooth, rule-based control, and documentation
    Introduced Bluetooth integration with new manager and tethering modules, updated API endpoints, and configuration for Bluetooth and GPIO. Migrated AI automation to rule-based control with new controller and comprehensive documentation, including guides and migration notes. Enhanced device configuration, updated backend and Firebase setup, and improved health checks and logging. Moved and expanded documentation files for better organization and clarity.
    [training_data_template.csv]
2025-11-12 Add Bluetooth diagnostics and system-level setup utilities
    Introduces fix_bluetooth.py and src/utils/bluetooth_setup.py for diagnosing and fixing Bluetooth issues, including device name and discoverability configuration. Updates integrated_server.py to use these utilities, adds a Bluetooth diagnostics API endpoint, improves device status sync and shutdown handling, and enhances Bluetooth initialization and discoverability logic.
    [bluetooth_setup.py, integrated_server.py]
2025-12-11 Add persistent Bluetooth agent and WiFi provisioning
    Introduces a native D-Bus Bluetooth agent for 'Just Works' pairing, BLE advertising, and Bluetooth Serial WiFi provisioning. Adds WiFi provisioning API endpoints and updates device startup logic for offline Bluetooth configuration. Removes obsolete deployment and install scripts, and adds documentation and troubleshooting guides for Bluetooth setup.
2025-12-15 Implement complete UI screens and widgets for touchscreen
    Added all main UI screens (dashboard, controls, settings, WiFi setup) and core widgets (sensor card, toggle button, status bar) for the touchscreen interface. Updated api_client.py with WiFi helper methods and config.py with additional font/icon sizes. main.py now loads all screens and removes the placeholder welcome screen. Added comprehensive documentation and testing guides.
2026-01-15 Add PyQt6 UI rewrite and update config/backend URLs
    Introduces a complete PyQt6-based touchscreen UI in the new pyqt6_ui/ directory, including all main screens, configuration, API client, and documentation. Updates .gitignore to exclude the new UI's venv, changes the backend API URL in config/device_config.yaml and integrated_server.py, and resets device_state.json to initial (unconfigured) values. This migration provides a modern, performant, and Python 3.13-compatible UI, replacing the previous Kivy implementation.
    [config.py, device_config.yaml, integrated_server.py]
2026-01-15 Add device creation web app with Luhn Modulo N ID generation
2026-01-15 Add comprehensive documentation for device creation app
2026-01-15 Add quick start guide for device creation app
2026-01-21 Add setup flow and UI improvements to PyQt6 app
    Introduces first-time setup flow with SetupFlowWindow, chamber configuration, onboarding, and related screens. Adds icon utilities for SVG support and updates icon mapping to use SVGs. Refines UI styles, colors, and font sizes for better touchscreen experience. Updates navigation, main window, and screen layouts for improved usability. Adds new assets and reorganizes icon files. Updates environment configuration for JWT authentication. Removes obsolete test file.
